cadus/Hardware-Circuit-Boards/Gesamtstückliste.xlsx

Sheet: Übersicht
remo2hbo Vitalparametermonitoring | Teil | Anzahl | Preis | Summe
 |  | 1 | 296.65 € | 296.65 €

Sheet: Komplett
Bauteilart | Anzahl | Bauteil | Bezeichnung | Einzelpreis | Summe | Anbieter | Artikelnummernr. | link
Power | 2 | 5V Schaltnetzteil | EPS-15-5 | 7.60 € | 15.20 € | Reichelt | EPS-15-5 | https://www.reichelt.de/schaltnetzteil-open-frame-15-w-5-v-3-a-eps-15-5-p170922.html?
 | 1 | Netzschalter | 2xAUS | 3.99 € | 3.99 € | Reichelt | WIPE 1935.3118 | https://www.reichelt.de/wippschalter-2x-aus-beleuchtet-gruen-i-o-wippe-1935-3118-p108252.html?trstct=pol_15
 | 1 | Kaltgerätebuchse + Feinsicherung |  | 1.45 € | 1.45 € | Reichelt | KES 2SI | https://www.reichelt.de/kaltgeraetestecker-mit-sicherungseinsatz-4-8-mm-faston-kes-2si-p9359.html?trstct=pol_1
IC | 3 | LED 3mm | EVL 1254-10SYGD1 | 0.08 € | 0.24 € | Reichelt | EVL 1254-10SYGD1 | https://www.reichelt.de/led-3-mm-bedrahtet-gruen-63-mcd-40-evl-1254-10sygd1-p230791.html?trstct=pol_1
 | 2 | 3,3V Festspannungsregler TO220 | LF33CV | 0.72 € | 1.44 € | Reichelt | LF 33 CV | https://www.reichelt.de/ldo-regler-fest-3-3-v-to-220-lf-33-cv-p39414.html?&trstct=pos_0
 | 1 | AD-Wandler | MCP-3008 | 2.51 € | 2.51 € | Conrad | 651456 - 62 | https://www.conrad.de/de/microchip-technology-mcp3008-ip-datenerfassungs-ic-analog-digital-wandler-adc-extern-pdip-16-651456.html
 | 1 | Drucksensor | OWN_MPX53GP | 8.99 € | 8.99 € | Reichelt | MPX 53GP | https://www.reichelt.de/drucksensor-0-50-kpa-1-2-mv-kpa-mpx-53gp-p82330.html?&trstct=pos_0
 | 1 | Tempsensor | DS18B20 | 7.65 € | 7.65 € | Reichelt | DEBO LK-TEMP2 | https://www.reichelt.de/entwicklerboards-temperatursensor-bis-125-c-debo-lk-temp2-p215884.html?trstct=pos_8
 | 3 | Transistor | IRF540 To220 | 0.50 € | 1.50 € | Reichelt | IRF 540N | https://www.reichelt.de/mosfet-n-ch-100v-33a-130w-to-220ab-irf-540n-p41613.html?&trstct=pos_2
 | 4 | Transistor | BC547 TO92 | 0.03 € | 0.12 € | Reichelt | RND BC547 | https://www.reichelt.de/bipolartransistor-npn-45v-0-1a-0-5w-to-92-rnd-bc547-p223356.html?trstct=pos_0
 | 1 | Multiplexer | CD4052B | 0.45 € | 0.45 € | Reichelt | CD 4052BE TEX | https://www.reichelt.de/multi-demultiplexer-4-ch-3-20-v-dil-16-cd-4052be-tex-p216651.html?trstct=pos_0
 | 2 | DigitalPoti | X9C104P DIL8 | 5.20 € | 10.40 € | Reichelt | X 9C104 PIZ | https://www.reichelt.de/digitalpoti-1-kanal-100-schritte-100-kohm-pdip-8-x-9c104-piz-p188766.html?trstct=pos_0
 | 3 | Instrumentenverstärker | INA126P | 2.99 € | 8.97 € | Reichelt | INA 126 PA | https://www.reichelt.de/instrumentenverstaerker-1-fach-dip-8-ina-126-pa-p147253.html?&trstct=pos_0
 | 11 | Quad OP Amp | LMC6484 | 2.60 € | 28.60 € | Reichelt | LMC 5484 N | https://www.reichelt.de/operationsverstaerker-4-fach-dip-14-lmc-6484-n-p10531.html?&trstct=pos_1
 | 3 | Quad OP Amp | MCP6024 | 2.46 € | 7.38 € | Conrad | 1084871 - 62 | https://www.conrad.de/de/microchip-technology-linear-ic-operationsverstaerker-mcp6024-ip-mehrzweck-pdip-14-1084871.html
 | 5 | ATMega 328P | DIP28 | 1.80 € | 9.00 € | Reichelt | ATMEGA 328P-PU | https://www.reichelt.de/mcu-atmega-avr-risc-32-kb-20-mhz-pdip-28-atmega-328p-pu-p119685.html?trstct=pos_1
 | 1 | ATTiny85 | Dil8 | 1.05 € | 1.05 € | Reichelt | ATTINY 85-20 PU | https://www.reichelt.de/mcu-attiny-avr-risc-8-kb-20-mhz-pdip-8-attiny-85-20-pu-p69299.html?trstct=pos_1
 | 4 | USB to Serial | Pololu CP2104 | 5.94 € | 23.76 € | Eckstein Komponente | PO1308 | https://eckstein-shop.de/Pololu-CP2104-USB-to-Serial-Adapter-Carrier
 | 5 | 16MHz Quarzoszillator | 16,0000-HC49U-S | 0.22 € | 1.10 € | Reichelt | 16,0000-HC49U-S | https://www.reichelt.de/standardquarz-grundton-16-000000-mhz-16-0000-hc49u-s-p32852.html?trstct=pos_7
Sockel | 5 | Sockel | DIL8 | 0.04 € | 0.20 € | Reichelt | GS 8 | https://www.reichelt.de/ic-sockel-8-polig-doppelter-federkontakt-gs-8-p8230.html?&trstct=pol_0
 | 14 | Sockel | DIL14 | 0.05 € | 0.70 € | Reichelt | GS 14 | https://www.reichelt.de/ic-sockel-14-polig-doppelter-federkontakt-gs-14-p8206.html?&trstct=pol_0
 | 2 | Sockel | DIl16 | 0.05 € | 0.10 € | Reichelt | GS 16 | https://www.reichelt.de/ic-sockel-16-polig-doppelter-federkontakt-gs-16-p8208.html?&trstct=pol_2
 | 1 | Sockel | DIL28 | 0.10 € | 0.10 € | Reichelt | GS 28-S | https://www.reichelt.de/ic-sockel-28-polig-doppelter-federkontakt-gs-28-s-p86281.html?&trstct=pol_0
 | 1 | Pinhead | 2x20 | 0.62 € | 0.62 € | Reichelt | MPE 087-2-040 | https://www.reichelt.de/stiftleisten-2-54-mm-2x20-gerade-mpe-087-2-040-p119900.html?&trstct=pol_2
 | 5 | Pinhead | 2x3 | 0.14 € | 0.70 € | Reichelt | MPE 087-2-006 | https://www.reichelt.de/stiftleisten-2-54-mm-2x03-gerade-mpe-087-2-006-p119893.html?&trstct=pol_13
 | 1 | Pinhead | 1x2 | 0.05 € | 0.05 € | Reichelt | MPE 087-1-002 | https://www.reichelt.de/stiftleisten-2-54-mm-1x02-gerade-mpe-087-1-002-p119879.html?&trstct=pol_3
 | 4 | Pinhead | 1x3 | 0.07 € | 0.28 € | Reichelt | MPE 097-1-003 | https://www.reichelt.de/stiftleisten-2-54-mm-1x03-gerade-mpe-087-1-003-p119880.html?&trstct=pol_4
Diode | 16 | Diode | 1N4148/1N4004 | 0.02 € | 0.32 € | Reichelt | RND 1N4148 | https://www.reichelt.de/schalt-diode-100-v-200-ma-do-35-rnd-1n4148-p223368.html?&trstct=pos_0
 | 9 | Schottkydiode | 1N5819 | 0.06 € | 0.54 € | Reichelt | 1N 5819 | https://www.reichelt.de/schottkydiode-40-v-1-a-do-41-1n-5819-p41850.html?&trstct=pos_0
Widerstand | 1 | Widerstand | 68 | 0.08 € | 0.08 € | Reichelt | K-O SFCN68R0T52 | https://www.reichelt.de/widerstand-metallschicht-68-ohm-0207-0-6-w-1-k-o-sfcn68r0t52-p237203.html?trstct=pos_0
 | 1 | Widerstand | 100 | 0.08 € | 0.08 € | Reichelt | K-O SFCN1000T52 | https://www.reichelt.de/widerstand-metallschicht-100-ohm-0207-0-6-w-1-k-o-sfcn1000t52-p237350.html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
 | 1 | Widerstand | 220 | 0.08 € | 0.08 € | Reichelt | K-O SFCN2200T52 | https://www.reichelt.de/widerstand-metallschicht-220-ohm-0207-0-6-w-1-k-o-sfcn2200t52-p237299.html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
 | 3 | Widerstand | 330 | 0.08 € | 0.24 € | Reichelt | K-O SFCN3300T52 | https://www.reichelt.de/widerstand-metallschicht-330-ohm-0207-0-6-w-1-k-o-sfcn3300t52-p237265.html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
 | 8 | Widerstand | 1k | 0.08 € | 0.64 € | Reichelt | K-O SFCN1001T52 | https://www.reichelt.de/widerstand-metallschicht-1-0-kohm-0207-0-6-w-1-k-o-sfcn1001t52-p237349.html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
 | 1 | Widerstand | 1,5k | 0.08 € | 0.08 € | Reichelt | K-O SFCN1501T52 | https://www.reichelt.de/widerstand-metallschicht-1-5-kohm-0207-0-6-w-1-k-o-sfcn1501t52-p237324.html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
 | 3 | Widerstand | 4,7k | 0.08 € | 0.24 € | Reichelt | K-O SFCN4701T52 | https://www.reichelt.de/widerstand-metallschicht-4-7-kohm-0207-0-6-w-1-k-o-sfcn4701t52-p237245.html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
 | 3 | Widerstand | 8,2k | 0.08 € | 0.24 € | Reichelt | K-O SFCN8201T52 | https://www.reichelt.de/widerstand-metallschicht-8-2-kohm-0207-0-6-w-1-k-o-sfcn8201t52-p237195.html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
 | 35 | Widerstand | 10k | 0.08 € | 2.80 € | Reichelt | K-O SFCN1002T52 | https://www.reichelt.de/widerstand-metallschicht-10-kohm-0207-0-6-w-1-k-o-sfcn1002t52-p237348.html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
 | 19 | Widerstand | 22k | 0.08 € | 1.52 € | Reichelt | K-O SFCN2202T52 | https://www.reichelt.de/widerstand-metallschicht-22-kohm-0207-0-6-w-1-k-o-sfcn2202t52-p237297.html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
 | 3 | Widerstand | 33k | 0.08 € | 0.24 € | Reichelt | K-O SFCN3302T52 | https://www.reichelt.de/widerstand-metallschicht-33-kohm-0207-0-6-w-1-k-o-sfcn3302t52-p237263.html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
 | 9 | Widerstand | 47k | 0.08 € | 0.72 € | Reichelt | K-O SFCN4702T52 | https://www.reichelt.de/widerstand-metallschicht-47-kohm-0207-0-6-w-1-k-o-sfcn4702t52-p237244.html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
 | 20 | Widerstand | 100k | 0.08 € | 1.60 € | Reichelt | K-O SFCN1003T52 | https://www.reichelt.de/widerstand-metallschicht-100-kohm-0207-0-6-w-1-k-o-sfcn1003t52-p237347.html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
 | 1 | Widerstand | 180k | 0.08 € | 0.08 € | Reichelt | METALL 180K | https://www.reichelt.de/widerstand-metallschicht-180-kohm-0207-0-6-w-1-metall-180k-p11564.html?trstct=pos_1
 | 4 | Widerstand | 220k | 0.08 € | 0.32 € | Reichelt | K-O SFCN2203T52 | https://www.reichelt.de/widerstand-metallschicht-220-kohm-0207-0-6-w-1-k-o-sfcn2203t52-p237296.html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
 | 3 | Widerstand | 390k | 0.08 € | 0.24 € | Reichelt | K-O SFCN3903T52 | https://www.reichelt.de/widerstand-metallschicht-390-kohm-0207-0-6-w-1-k-o-sfcn3903t52-p237255.html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
 | 6 | Widerstand | 470k | 0.08 € | 0.49 € | Reichelt | METALL 470K | https://www.reichelt.de/widerstand-metallschicht-470-kohm-0207-0-6-w-1-metall-470k-p11827.html?trstct=pos_1
 | 35 | Widerstand | 1M | 0.08 € | 2.80 € | Reichelt | K-O SFCN1004T52 | https://www.reichelt.de/widerstand-metallschicht-1-0-mohm-0207-0-6-w-1-k-o-sfcn1004t52-p237346.html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
 | 1 | Widerstand | 1,5M | 0.08 € | 0.08 € | Reichelt | K-O SFCN1504T52 | https://www.reichelt.de/widerstand-metallschicht-1-5-mohm-0207-0-6-w-1-k-o-sfcn1504t52-p237321.html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
Kondensator | 8 | Kondensator C2, 5 | 2,2p | 0.05 € | 0.40 € | Reichelt | KERKO 2,2P | https://www.reichelt.de/keramik-kondensator-2-2p-kerko-2-2p-p9276.html?&trstct=pol_0
 | 3 | Kondensator C2, 5 | 10p | 0.05 € | 0.15 € | Reichelt | KERKO 10P | https://www.reichelt.de/keramik-kondensator-10p-kerko-10p-p9268.html?&trstct=pol_0
 | 10 | Kondensator C2,5 | 22p | 0.05 € | 0.50 € | Reichelt | KERKO 22P | https://www.reichelt.de/keramik-kondensator-22p-kerko-22p-p9281.html?&trstct=pol_0
 | 3 | Kondensator C2, 5 | 100p | 0.05 € | 0.15 € | Reichelt | KERKO 100P | https://www.reichelt.de/keramik-kondensator-100p-kerko-100p-p9266.html?&trstct=pol_0
 | 7 | Kondensator C2, 5 | 150p | 0.06 € | 0.42 € | Reichelt | KERKO 150P | https://www.reichelt.de/keramik-kondensator-150p-kerko-150p-p9271.html?&trstct=pol_0
 | 8 | Kondensator C2, 5 | 470p | 0.05 € | 0.40 € | Reichelt | KERKO 470P | https://www.reichelt.de/keramik-kondensator-470p-kerko-470p-p9295.html?&trstct=pol_0
 | 3 | Kondensator C2, 5 | 680p | 0.05 € | 0.15 € | Reichelt | KERKO 680P | https://www.reichelt.de/keramik-kondensator-680p-kerko-680p-p9303.html?&trstct=pol_0
 | 15 | Kondensator C2, 5 | 1,5n | 0.05 € | 0.75 € | Reichelt | KERKO 1,5N | https://www.reichelt.de/keramik-kondensator-1-5n-kerko-1-5n-p9261.html?&trstct=pol_2
 | 6 | Kondensator C2, 5 | 2,2n | 0.06 € | 0.36 € | Reichelt | KERKO 2,2N | https://www.reichelt.de/keramik-kondensator-2-2n-kerko-2-2n-p9275.html?&trstct=pol_0
 | 6 | Kondensator C2, 5 | 4,7n | 0.06 € | 0.36 € | Reichelt | KERKO 4,7N | https://www.reichelt.de/keramik-kondensator-4-7n-kerko-4-7n-p9293.html?&trstct=pos_0
 | 3 | Kondensator C2,5 | 10n | 0.05 € | 0.15 € | Reichelt | KERKO 10N | https://www.reichelt.de/keramik-kondensator-10n-kerko-10n-p9267.html?&trstct=pos_0
 | 6 | Kondensator C2, 5 | 15n | 0.33 € | 1.98 € | Reichelt | ECWHA 15N 800 | https://www.reichelt.de/folienkondensator-15-nf-800-v-rm-13-105-c-3-ecwha-15n-800-p228880.html?trstct=pos_4
 | 2 | Kondensator C2, 5 | 22n | 0.06 € | 0.12 € | Reichelt | KERKO 22N | https://www.reichelt.de/keramik-kondensator-22n-kerko-22n-p9280.html?&trstct=pol_0
 | 3 | Kondensator C2, 5 | 33n | 0.24 € | 0.72 € | Reichelt | MKS02-250 33N | https://www.reichelt.de/folienkondensator-33nf-250v-rm2-5-mks02-250-33n-p172674.html?&trstct=pos_9
 | 2 | Kondensator C2, 5 | 47n | 0.09 € | 0.18 € | Reichelt | KERKO 47N | https://www.reichelt.de/keramik-kondensator-47n-kerko-47n-p9296.html?&trstct=pos_0
 | 9 | Kondensator C2, 5 | 68n | 0.44 € | 3.96 € | Reichelt | MKS02-63 680N | https://www.reichelt.de/folienkondensator-680nf-63v-rm2-5-mks02-63-680n-p12328.html?&trstct=pos_3
 | 14 | Kondensator C2,5 | 100n | 0.05 € | 0.70 € | Reichelt | KERKO 100N | https://www.reichelt.de/keramik-kondensator-100n-kerko-100n-p9265.html?r=1
 | 8 | Kondensator C2, 5 | 220n | 0.22 € | 1.76 € | Reichelt | MKS02-63 220N | https://www.reichelt.de/folienkondensator-220nf-63v-rm2-5-mks02-63-220n-p12319.html?&trstct=pos_3
 | 1 | Kondensator C2,5 | 330n | 0.27 € | 0.27 € | Reichelt | MKS02-63 330N | https://www.reichelt.de/folienkondensator-330nf-63v-rm2-5-mks02-63-330n-p172661.html?&trstct=pos_4
 | 6 | Kondensator C150 | 470n | 0.33 € | 1.98 € | Reichelt | MKP4-250 470N | https://www.reichelt.de/folienkondensator-470nf-250v-rm15-mkp4-250-470n-p172980.html?&trstct=pos_1
 | 1 | Kondensator C150 | 680n | 0.29 € | 0.29 € | Reichelt | MKS4-250 680N | https://www.reichelt.de/folienkondensator-680nf-250v-rm15-mks4-250-680n-p172870.html?&trstct=pos_13
 | 3 | Kondensator C150 | 1µ | 0.16 € | 0.48 € | Reichelt | RND 150MKT105K2A | https://www.reichelt.de/folienkondensator-1-f-100-v-rm15-rnd-150mkt105k2a-p211355.html?&trstct=pos_1
 | 2 | Kondensator E2,5 | 4,7µ | 0.02 € | 0.04 € | Reichelt | RAD 105 4,7/100 | https://www.reichelt.de/elko-radial-4-7-f-100-v-rm-2-5-1000h-105-c-20-rad-105-4-7-100-p44857.html?trstct=pol_0
 | 2 | Kondensator E2,5 | 10µ | 0.02 € | 0.04 € | Reichelt | RAD 105 10/63 | https://www.reichelt.de/elko-radial-10-f-63-v-rm-2-5-1000h-105-c-20-rad-105-10-63-p42397.html?trstct=pol_0
 | 10 | Kondensator E2,5 | 47µ | 0.04 € | 0.40 € | Reichelt | RAD 105 47/35 | https://www.reichelt.de/elko-radial-47-f-35-v-rm-2-5-1000h-105-c-20-rad-105-47-35-p42399.html?trstct=pol_1
Steckkontakte | 4 | JST B2P VH | Stifte gerade | 0.13 € | 0.52 € | Reichelt | JST VH2P ST | https://www.reichelt.de/jst-stiftleiste-gerade-1x2-polig-vh-jst-vh2p-st-p185110.html?&trstct=pos_11
Notlösung, muss dann angepasst werden | 2 | JST B2P VH | Stifte gewinkelt | 0.27 € | 0.54 € | Reichelt | JST VH4P ST90 | https://www.reichelt.de/jst-stiftleiste-rm-3-96-mm-1x4-polig-gew-vh-jst-vh4p-st90-p190558.html?trstct=pos_5
 | 10 | JST B2P VH | Female | 0.10 € | 1.00 € | Reichelt | JST VH2P BU | https://www.reichelt.de/jst-buchsengehaeuse-1x2-polig-vh-jst-vh2p-bu-p185107.html?&trstct=pos_8
 | 1 | JST B3P VH | Stifte gerade | 0.19 € | 0.19 € | Reichelt | JST VH3P ST | https://www.reichelt.de/jst-stiftleiste-gerade-1x3-polig-vh-jst-vh3p-st-p185111.html?&trstct=pos_12
 | 3 | JST B3P VH | Stifte gewinkelt | 0.41 € | 1.23 € | Conrad | 741182 - 62 | https://www.conrad.de/de/jst-stiftleiste-standard-vh-polzahl-gesamt-3-rastermass-396-mm-b3ps-vh-lfsn-1-st-741182.html
 | 4 | JST B3P VH | Female | 0.13 € | 0.52 € | Reichelt | JST VH3P BU | https://www.reichelt.de/jst-buchsengehaeuse-1x3-polig-vh-jst-vh3p-bu-p185108.html?&trstct=pos_9
 | 6 | JST XH 03 | Stifte gerade | 0.16 € | 0.96 € | Reichelt | JST XH3P ST | https://www.reichelt.de/jst-stiftleiste-gerade-1x3-polig-xh-jst-xh3p-st-p185074.html?&trstct=pos_5
 | 4 | JST XH 03 | Stifte gewinkelt | 0.19 € | 0.76 € | Reichelt | JST XH3P ST90 | https://www.reichelt.de/jst-stiftleiste-90-1x3-polig-xh-jst-xh3p-st90-p185080.html?&trstct=pos_10
 | 10 | JST XH 03 | Female | 0.06 € | 0.60 € | Reichelt | JST XH3P BU | https://www.reichelt.de/jst-buchsengehaeuse-1x3-polig-xh-jst-xh3p-bu-p185086.html?trstct=lsbght_sldr::185080
 | 15 | JST XH 02 | Stifte gerade | 0.10 € | 1.50 € | Reichelt | JST XH2P ST | https://www.reichelt.de/jst-stiftleiste-gerade-1x2-polig-xh-jst-xh2p-st-p185073.html?&trstct=pos_4
 | 19 | JST XH 02 | Stifte gewinkelt | 0.13 € | 2.47 € | Reichelt | JST XH2P ST90 | https://www.reichelt.de/jst-stiftleiste-90-1x2-polig-xh-jst-xh2p-st90-p185079.html?&trstct=pos_9
 | 34 | JST XH 02 | Female | 0.06 € | 2.04 € | Reichelt | JST XH2P BU | https://www.reichelt.de/jst-buchsengehaeuse-1x2-polig-xh-jst-xh2p-bu-p185085.html?trstct=lsbght_sldr::185079
 | 56 | Crimpkontakte | JST VH | 0.10 € | 5.60 € | Reichelt | JST VH CKS | https://www.reichelt.de/jst-crimpkontakt-buchse-vh-jst-vh-cks-p185113.html?&trstct=pos_0
 | 196 | Crimpkontakte | JST XH | 0.10 € | 19.60 € | Reichelt | JST XH CKB | https://www.reichelt.de/jst-crimpkontakt-buchse-xh-jst-xh-ckb-p185091.html?trstct=lsbght_sldr::185073
Leitung | 1 | EKG Elektrodenkabel |  |  | 0.00 €
 | 1 | Flachbandkabel Raspberry Pi |  | 3.25 € | 3.25 € | Eckstein Komponente | ZB02034 | https://eckstein-shop.de/IDE-Flachband-Kabel-40Pin-Buchse-auf-Buchse-female-to-female-20cm
 | 1 | Leitung |  | 0.81 € | 0.81 € | Reichelt | LITZE OR | https://www.reichelt.de/kupferlitze-isoliert-10m-1x0-14mm-orange-litze-or-p118722.html?&trstct=pol_0
 | 1 | Leitung |  | 0.78 € | 0.78 € | Reichelt | LITZE BL | https://www.reichelt.de/kupferlitze-isoliert-10m-1x0-14mm-blau-litze-bl-p10292.html?&trstct=pol_1
 | 1 | Leitung |  | 0.78 € | 0.78 € | Reichelt | LITZE BR | https://www.reichelt.de/kupferlitze-isoliert-10m-1x0-14mm-braun-litze-br-p10293.html?&trstct=pol_2
 | 1 | Leitung |  | 0.76 € | 0.76 € | Reichelt | LITZE GE | https://www.reichelt.de/kupferlitze-isoliert-10m-1x0-14mm-gelb-litze-ge-p10294.html?&trstct=pol_3
 | 1 | Leitung |  | 0.76 € | 0.76 € | Reichelt | LITZE GR | https://www.reichelt.de/kupferlitze-isoliert-10m-1x0-14mm-grau-litze-gr-p10295.html?&trstct=pol_4
 | 1 | Leitung |  | 0.76 € | 0.76 € | Reichelt | LITZE GN | https://www.reichelt.de/kupferlitze-isoliert-10m-1x0-14mm-gruen-litze-gn-p10296.html?&trstct=pol_5
 | 1 | Leitung |  | 0.76 € | 0.76 € | Reichelt | LITZE RT | https://www.reichelt.de/kupferlitze-isoliert-10m-1x0-14mm-rot-litze-rt-p10297.html?&trstct=pol_6
 | 1 | Leitung |  | 0.78 € | 0.78 € | Reichelt | LITZE SW | https://www.reichelt.de/kupferlitze-isoliert-10m-1x0-14mm-schwarz-litze-sw-p10298.html?&trstct=pol_7
 | 1 | Leitung |  | 1.20 € | 1.20 € | Reichelt | LITZE VT | https://www.reichelt.de/kupferlitze-isoliert-10m-1x0-14mm-violett-lila-litze-vt-p211172.html?trstct=pol_9
 | 1 | Leitung |  | 1.75 € | 1.75 € | Reichelt | H05VK 0,75-10BL | https://www.reichelt.de/schaltlitze-h05v-k-0-75-mm-10-m-blau-h05vk-0-75-10bl-p69460.html?trstct=pol_0
 | 1 | Leitung |  | 1.99 € | 1.99 € | Reichelt | H05VK 0,75-10SW | https://www.reichelt.de/schaltlitze-h05v-k-0-75-mm-10-m-schwarz-h05vk-0-75-10sw-p69459.html?trstct=pol_2
Gehäsueanschluss | 1 | D-SUB Einbaubuchse | 9 pol | 0.17 € | 0.17 € | Reichelt | D-SUB BU 09 | https://www.reichelt.de/d-sub-buchse-9-polig-loetkelch-d-sub-bu-09-p6948.html?&trstct=pos_10
 | 2 | Stereo Klinkenbuchse 3,5mm |  | 0.90 € | 1.80 € | Reichelt | LUM KLB 4 | https://www.reichelt.de/klinkeneinbaubuchse-3-5-mm-stereo-3-pol-lum-klb-4-p116183.html?trstct=pol_15
 | 1 | Schlauchanschluss-gehäuse |  |  | 0.00 €
Blutdruck | 1 | 6V DC Mini Air pump |  | 3.95 € | 3.95 € | Pollin Electronic | 330067 | https://www.pollin.de/p/luftpumpe-daypower-lp27-06-6-v-330067
 | 2 | 3V Magnetventil |  | 0.34 € | 0.68 € | Aliexpress |  | https://de.aliexpress.com/item/DC3V-Elektronische-Blutdruck-Magnetventil-Normal-Open-Arbeitsdruck-300-mmHg-Blutdruckmessger-t-Vent-Ventil-DC-Auspuff-Ventil/32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
 | 1 | Schlauch |  |  | 0.00 €
 | 3 | T Stück |  |  | 0.00 €
 | 1 | KLettManschette Erwachsene Standard abwaschbar |  | 16.50 € | 16.50 € | Medishop | BOS1104250A | https://www.medishop.de/sitemap/Klettenmanschette-fuer-Erwachsene-Standard-abwaschbar-Einschlauch.html
Sonstiges | 1 | Display, 7" resisitive Touch |  | 54.95 € | 54.95 € | Pollin Electronic | 120964 | https://www.pollin.de/p/7-17-78-cm-display-set-mit-touchscreen-ls-7t-hdmi-dvi-vga-cvbs-120964
 | 1 | Raspberry Pi 3B+ |  | 32.50 € | 32.50 € | Reichelt | RASPBERRY PI 3B+ | https://www.reichelt.de/raspberry-pi-3-b-4x-1-4-ghz-1-gb-ram-wlan-bt-raspberry-pi-3b-p217696.html?trstct=pos_0
 | 5 | USB Kabel micro-->A |  | 1.45 € | 7.25 € | Eckstein Komponente | ZB02246 | https://eckstein-shop.de/20cm-Micro-USB-Ladekaber-fuer-Raspberry-Pi-Adapterkabel-keine-Datenuebertragung
 | 1 | HDMI |  | 7.90 € | 7.90 € | Reichelt | DELOCK 85117 | https://www.reichelt.de/high-speed-hdmi-kabel-mit-ethernet-0-25-m-delock-85117-p203113.html?trstct=pol_0
 | 1 | Kaltgerätekabel | 2,5m | 3.55 € | 3.55 € | Reichelt | NKSK 250 SW | https://www.reichelt.de/kaltgeraeteanschlusskabel-2-5m-schwarz-nksk-250-sw-p133128.html?trstct=pos_1
 | 1 | Usb Hub |  | 9.40 € | 9.40 € | Reichelt | RPIZ USB 4PORT | https://www.reichelt.de/raspberry-pi-usb-hub-4-port-phat-rpiz-usb-4port-p242791.html?PROVID=2788&r=1

Sheet: Power Supply
Baugruppe / Modul | Anzahl | Bauteil | Bezeichnung
Power supply | 2 | Kondensator E2, 5 | 10µ
 | 2 | Kondensator C2, 5 | 0,1µ
 | 2 | 3,3V Festspannungsregler TO220 | LF33
 | 3 | LED 3mm
 | 1 | Widerstand | 220
 | 2 | Widerstand | 1k
 | 3 | JST B2P VH | Buchse gerade
 | 3 | JST B2P VH | Stecker
 | 1 | JST B3P VH | Buchse gerade
 | 1 | JST B3P VH | Stecker

Sheet: OctoBrain
Baugruppe / Modul | Anzahl | Bauteil | Bezeichnung
OctoBrain | 1 | Kondensator E2, 5 | 47µ
 | 1 | AD-Wandler | MCP-3008
 | 1 | Widerstand | 4,7k
 | 1 | Pinhead | 2x20
 | 1 | JST XH 03 | Buchse gerade
 | 1 | JST XH 03 | Stecker
 | 12 | JST XH 02 | Buchse gerade
 | 12 | JST XH 02 | Stecker
 | 1 | JST B2P VH | Buchse gerade
 | 1 | JST B2P VH | Stecker

Sheet: ECG Supply
Baugruppe / Modul | Anzahl | Bauteil | Bezeichnung
ECG_Supply | 6 | Diode | 1N4148
 | 3 | Widerstand | 100k
 | 5 | JST XH 03 | Buchse gerade
 | 5 | JST XH 03 | Stecker
 | 3 | JST XH 02 | Buchse gerade
 | 3 | JST XH 02 | Stecker

Sheet: ECG
Baugruppe / Modul | Anzahl | Bauteil | Bezeichnung
ECG I, II, III | 6 | Kondensator C2, 5 | 2,2p
 | 3 | Kondensator C2, 5 | 10p
 | 3 | Kondensator C2, 5 | 100p
 | 6 | Kondensator C2, 5 | 150p
 | 6 | Kondensator C2, 5 | 470p
 | 3 | Kondensator C2, 5 | 680p
 | 15 | Kondensator C2, 5 | 1,5n
 | 6 | Kondensator C2, 5 | 2,2n
 | 6 | Kondensator C2, 5 | 4,7n
 | 6 | Kondensator C2, 5 | 15n
 | 3 | Kondensator C2, 5 | 33n
 | 9 | Kondensator C2, 5 | 68n
 | 3 | Kondensator C2, 5 | 100n
 | 6 | Kondensator C2, 5 | 220n
 | 6 | Kondensator C15 | 0,47µ
 | 3 | Schottkydiode | 1N5819
 | 3 | Diode | 1N4148/1N4004
 | 3 | Instrumentenverstärker | INA126P
 | 9 | Quad OP Amp | LM6484
 | 3 | Widerstand | 330
 | 3 | Widerstand | 8,2k
 | 21 | Widerstand | 10k
 | 3 | Widerstand | 22k
 | 12 | Widerstand | 27k
 | 3 | Widerstand | 33k
 | 9 | Widerstand | 47k
 | 3 | Widerstand | 100k
 | 3 | Widerstand | 390k
 | 6 | Widerstand | 500k
 | 24 | Widerstand | 1M
 | 3 | JST XH 03 | Buchse
 | 3 | JST XH 03 | Stecker
 | 9 | JST XH 02 | Buchse
 | 9 | JST XH 02 | Stecker
 | 1 | Stereo Klinkenbuchse 3,5mm
 | 1 | Elektrodenkabel
 | 9 | Sockel | DIL14
 | 3 | Sockel | DIL8

Sheet: PulseDet
Baugruppe / Modul | Anzahl | Bauteil | Bezeichnung
Pulse_Detection | 2 | Kondensator C2, 5 | 22p
 | 1 | Pinhead | 2x3
 | 1 | Pinhead | 1x3
 | 1 | ATMega 328P | DIP28
 | 1 | 16MHz Crystal
 | 3 | Widerstand | 22k
 | 1 | Widerstand | 10k
 | 1 | USB to Serial | Pololu CP2104
 | 1 | Sockel | DIL28
 | 1 | JST XH 03 | Buchse
 | 1 | JST XH 03 | Stecker
 | 3 | JST XH 02 | Buchse
 | 3 | JST XH 02 | Stecker

Sheet: PulseOxy
Baugruppe / Modul | Anzahl | Bauteil | Bezeichnung
PulseOxy | 1 | ATTiny85 | Dil8
 | 1 | ATMega 328P | DIP28
 | 2 | Kondensator C2, 5 | 2,2p
 | 2 | Kondensator C2,5 | 22p
 | 1 | Kondensator C2, 5 | 150p
 | 2 | Kondensator C2,5 | 470p
 | 2 | Kondensator C2,5 | 10n
 | 2 | Kondensator C2, 5 | 22n
 | 2 | Kondensator C2, 5 | 47n
 | 5 | Kondensator C2, 5 | 100n
 | 2 | Kondensator C150 | 1µ
 | 2 | Kondensator E2,5 | 4,7µ
 | 4 | Kondensator E2,5 | 47µ
 | 4 | Schottkydiode | 1N5819
 | 1 | Diode | 1N4148/1N4004
 | 1 | Multiplexer | CD4052B
 | 1 | Pinhead | 2x3
 | 1 | Pinhead | 1x3
 | 1 | 16MHz Crystal
 | 1 | Widerstand | 68
 | 1 | Widerstand | 100
 | 6 | Widerstand | 1k
 | 2 | Widerstand | 4,7k
 | 9 | Widerstand | 10k
 | 6 | Widerstand | 100k
 | 1 | Widerstand | 180k
 | 2 | Widerstand | 220k
 | 9 | Widerstand | 1Meg
 | 4 | Transistor | BC547 TO92
 | 2 | DigitalPoti | X9C104P DIL8
 | 1 | USB to Serial | Pololu CP2104
 | 1 | Quad OP Amp | LM6484
 | 2 | Quad OP Amp | MCP6024
 | 4 | JST XH 02 | Buchse
 | 4 | JST XH 02 | Stecker
 | 1 | JST B3P VH | Buchse
 | 1 | JST B3P VH | Stecker
 | 1 | D-SUB Einbaubuchse | 9 pol
 | 2 | Sockel | DIL8
 | 3 | Sockel | DIL14
 | 1 | Sockel | DIl16
 | 1 | Sockel | DIL28

Sheet: PTT
Baugruppe / Modul | Anzahl | Bauteil | Bezeichnung
PTT | 4 | Kondensator C2,5 | 22p
 | 2 | Kondensator C2,5 | 100n
 | 2 | Kondensator E2,5 | 47µ
 | 2 | Diode | 1N4148/1N4004
 | 2 | ATMega 328P | DIP28
 | 2 | 16MHz Crystal
 | 2 | Pinhead | 1x3
 | 2 | Pinhead | 2x3
 | 2 | Widerstand | 10k
 | 1 | USB to Serial | Pololu CP2104
 | 1 | JST B2P VH | Buchse
 | 1 | JST B2P VH | Stecker
 | 1 | JST B3P VH | Buchse
 | 1 | JST B3P VH | Stecker
 | 2 | Sockel | DIL28

Sheet: BloodPressure
Baugruppe / Modul | Anzahl | Bauteil | Bezeichnung
Blood_Pressure | 2 | Kondensator C2,5 | 22p
 | 1 | Kondensator C2,5 | 10n
 | 2 | Kondensator C2,5 | 100n
 | 2 | Kondensator C2,5 | 220n
 | 1 | Kondensator C2,5 | 330n
 | 1 | Kondensator C150 | 680n
 | 1 | Kondensator C150 | 1µ
 | 3 | Kondensator E2,5 | 47µ
 | 4 | Diode | 1N4148/1N4004
 | 2 | Schottkydiode | 1N5819
 | 1 | ATMega 328P | DIP28
 | 1 | Pinhead | 2x3
 | 1 | Drucksensor | OWN_MPX53GP
 | 1 | 16MHz Crystal
 | 3 | Transistor | IRF540 To220
 | 1 | Widerstand | 1,5k
 | 2 | Widerstand | 10k
 | 1 | Widerstand | 22k
 | 8 | Widerstand | 100k
 | 2 | Widerstand | 220k
 | 2 | Widerstand | 1M
 | 1 | Widerstand | 1,5M
 | 1 | Pinhead | 1x3
 | 1 | Pinhead | 1x2
 | 1 | USB to Serial | Pololu CP2104
 | 1 | Quad OP Amp | MCP6024
 | 1 | Quad OP Amp | LM6484
 | 3 | JST XH 02 | Buchse
 | 3 | JST XH 02 | Stecker
 | 1 | JST B3P VH | Buchse
 | 1 | JST B3P VH | Stecker
 | 1 | JST B2P VH | Buchse
 | 1 | JST B2P VH | Stecker
 | 1 | DC E-Pump
 | 2 | Micro Valve
 | 1 | Schlauch
 | 1 | Schlauchanschluss-gehäuse
 | 2 | T Stück
 | 1 | Blutdruckmanschette
 | 1 | Sockel | DIl28
 | 2 | Sockel | DIl14

Sheet: Netzteil
Baugruppe / Modul | Anzahl | Bauteil | Bezeichnung
Netzteil | 2 | 5V Schaltnetzteil | EPS-15-5
 | 4 | JST B2P VH | Stecker
 | 1 | Netzschalter
 | 1 | Kaltgerätebuchse + Feinsicherung
