cadus/Hardware-Circuit-Boards/Wiring_all_modules.pdf

# Power Supply

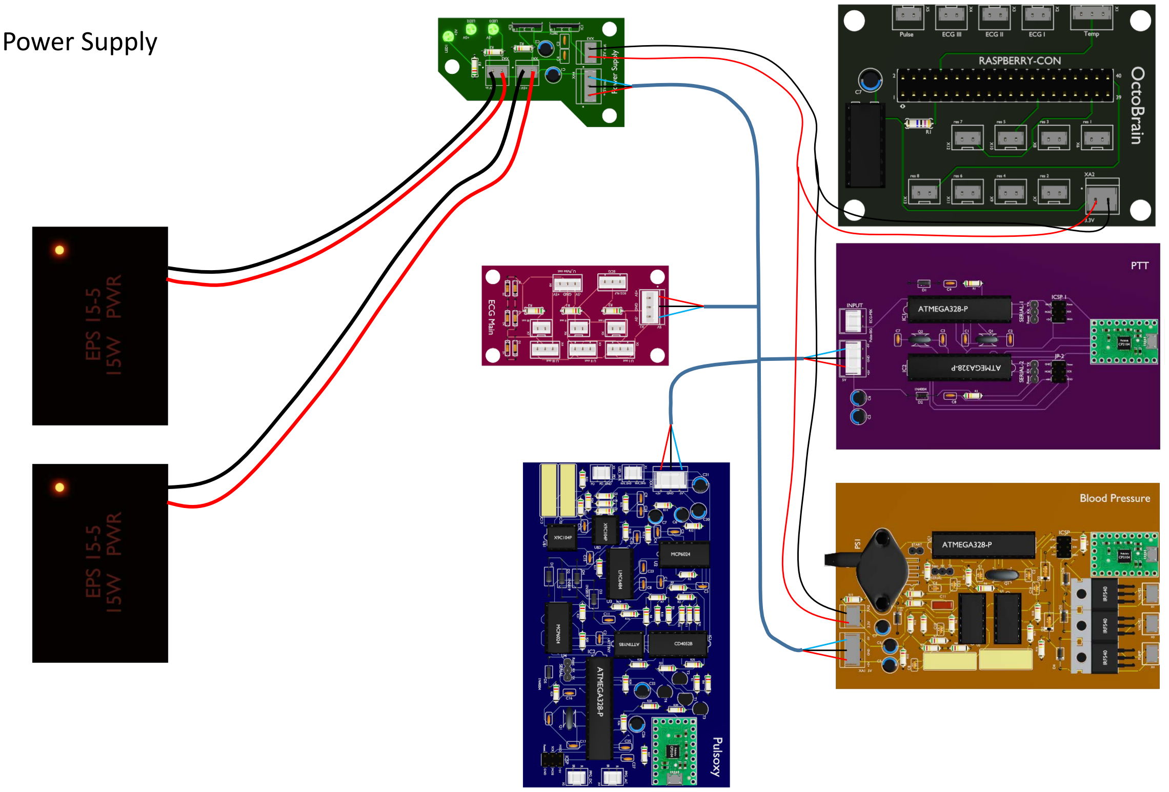
[picture p1: page 1]

# ECG

R

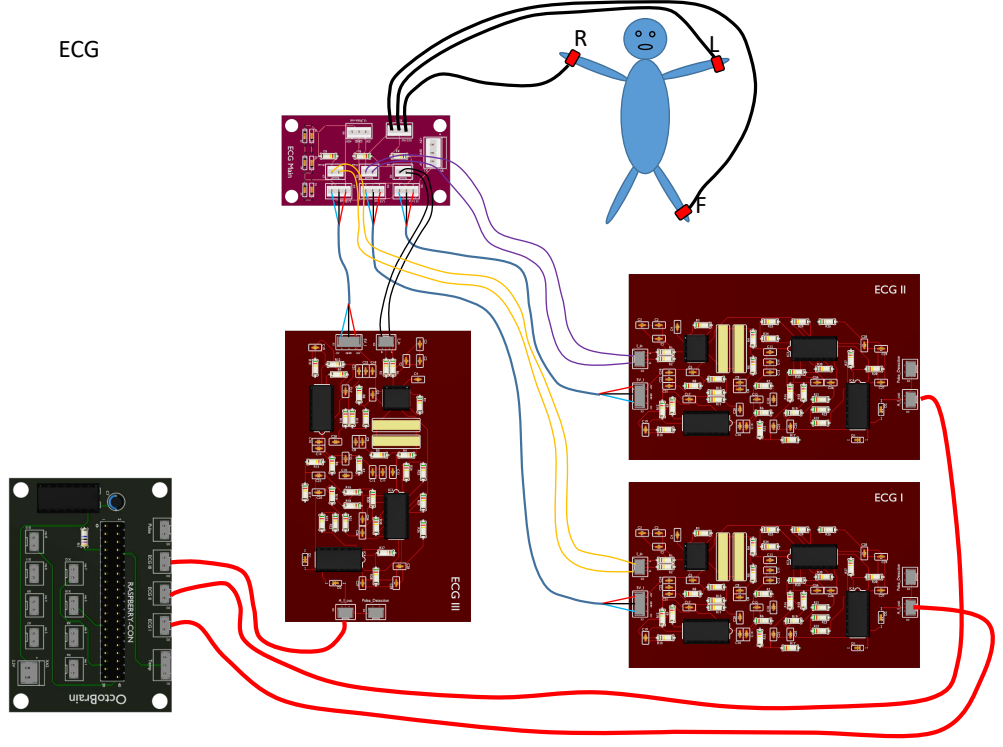
[picture p2: page 2]

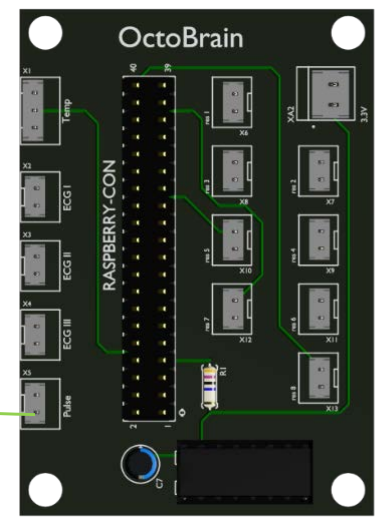
[picture p3: figure]

# SpO2

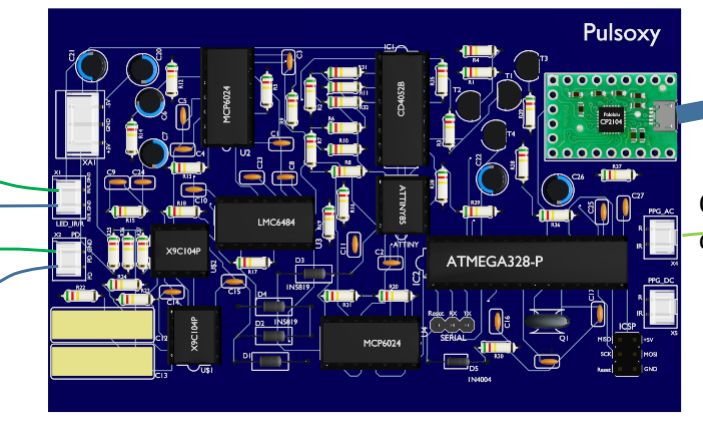
[picture p4: figure]

Only one of the two pins, either the R channel or the IR channel

R
IR

PD

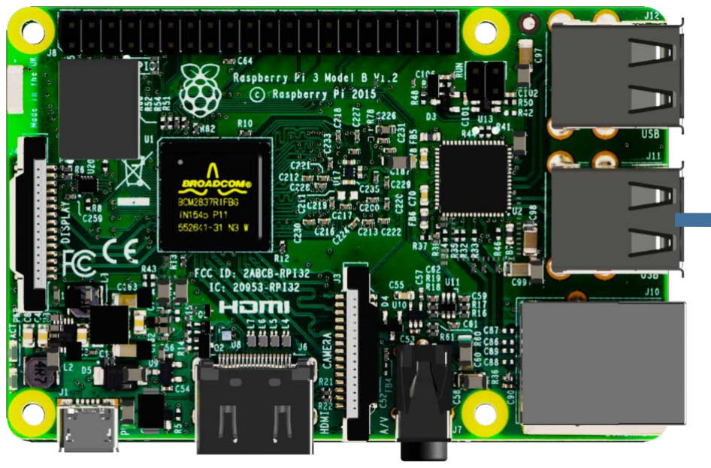
[picture p5: figure]

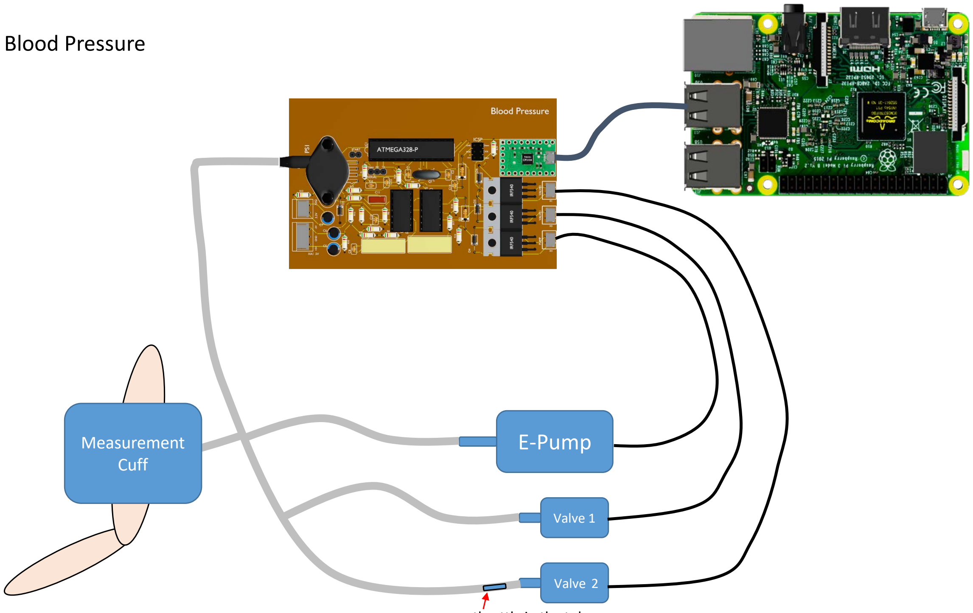
[picture p6: figure]
Blood Pressure; E-Pump; Valve 1; Valve 2; Measurement Cuff

### throttle in the tube

# Pulse

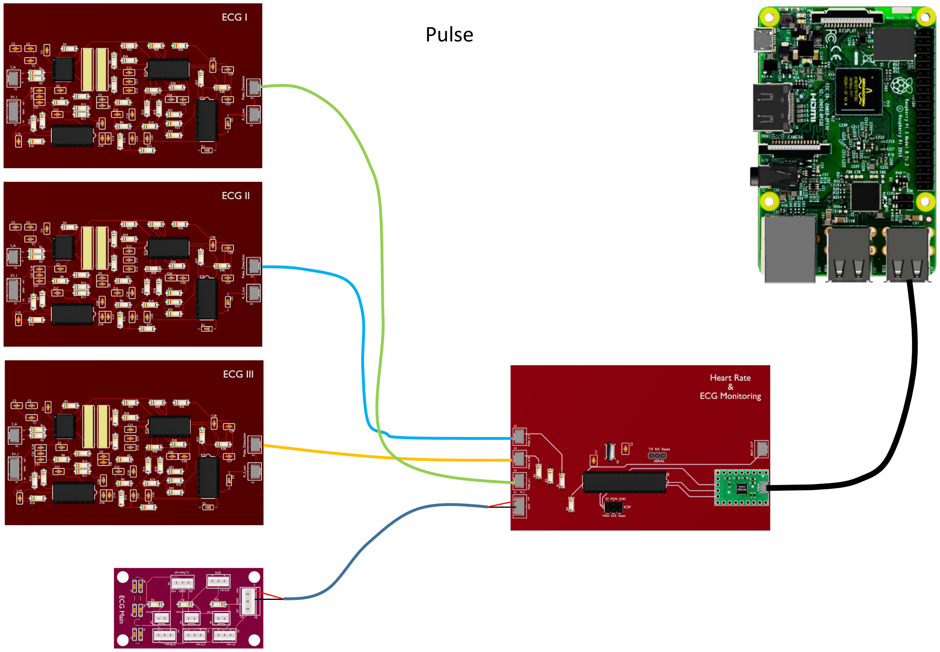
[picture p7: page 5]

# Pulse Transit Time

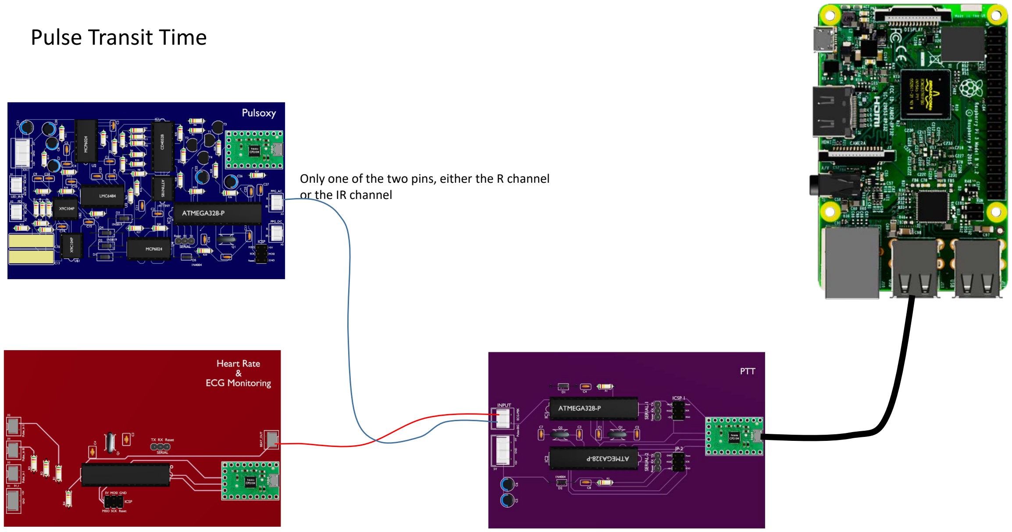
[picture p8: page 6]

Only one of the two pins, either the R channel or the IR channel
