cadus/Hardware-Circuit-Boards/(threads)

Thread 1 (2019-05-07):

Question

kermit943, 2019-05-07:
May we write in English or German?

I saw you work on the CCC youtube chanel

Any reasons why you don´t use SMD parts for the boards?
I can imagine that there is barley time or nerves to resolder a resistor in a crises area no matter if THT or SMD.
But SMD build could reduce the costs of production and there could be mass produced mmodules with still low costs if you chose assembled boards.
-> more boards/moduls -> just swap the old with the new one and repair the other one if you got time.

I know there still some parts with needed to be resolder or handsoldered before sending (pressurepump and so on)

other thing why using a Atmega 328p and extra usbUart MCU if u can have a arduino nano clone for less than 2€, you cann still use the ISP and remove the Bootloader if thats the reason.

not even a hour in the group and already complaining .... tztz sorry

I´m not an electrician or any specialist, just a industrialmechanic and a (so called) Maker with Experience in Arduino/AVR/Rasperry/shit but I hope I can help in any way..

auf gute zusammen Arbeit =)

sabinammm, 2019-05-13:
Hi Kermit:)

thanks for your questions and comments!! English is perfect, but we are just starting out as a community, so please bear with us as we don't always answer everything.

We're just now in the process of building the 2nd prototype using the CAD files available here. As 2 out of 3 of us are relatively new to soldering and not at all specialists, we figure this is a great testing ground for these instructions.

I will pass on your questions with regard to soldering. One thing that comes to mind that makes soldering important: robustness. In a crisis area, machines do need to be especially robust. But in connection with replaceable parts, this is definitely a challenge.

Thanks for the info on the Atmega - maybe one of the more experienced health electronics professionals will have answers to that.

kermit943, 2019-05-13:
> please bear with us as we don't always answer everything.

 How couldn´ t I.

> great testing ground

didn´t thought about prototyping, forgive me

I´m looking forward to see some of the team at MakerFair in Berlin

sabinammm, 2019-05-14:
> I´m looking forward to see some of the team at MakerFair in Berlin

Great:) We also look forward to seeing you there!!

kermit943, 2019-05-18:
Hy Sabinammm
ich kann natürlich keine Leute hinzufügen, sorry!
Würdest du salt4pommes adden?

Wir hätten mal Mailadressen oder ähnliches austauschen sollen

grüße Kermit

sabinammm, 2019-05-22:
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

Hi Kermit,
da du Mitglied der Organisation bist, dachte ich du könntest auch Leute hinzufügen. Vielleicht muss ich das dann noch einschalten. Ich füge salt4pommes gerne hinzu.

Wir hatten ja über das Image geredet. Hier findest du ein funktionierendes: http://remo2hbo-sim.f4.htw-berlin.de/. Wir sind aber noch auf der Suche nach einer besseren Ablage für dieses und zukünftige, also solltet ihr oder du da eine Idee haben, freuen sich bestimmt noch viele Mitstreiter*innen:)

sabinammm, 2019-05-23:
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

Hi Kermit,
das SD-Kartenimage hat jetzt einen neuen Platz: https://redmine.f4.htw-berlin.de/owncloud/index.php/s/6XYWEb62KBo3KN4

sabinammm, 2019-06-06:
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

Hi Kermit,
wir haben noch eine Mailingliste: https://lists.htw-berlin.de/mailman/listinfo/remo2hbo-community. Das hatte ich vergessen dir zu schreiben. Ist eine sehr gute alternative Kommunikation.
VG
Sabina

kermit943, 2019-06-14:
Hy Sabina da trag ich mich gleich mal ein.
Kannst du mir zufällig sagen was das EKG -Modul ausgibt bzw. hast du/ ihr ne Testausgabe? Bild von der UART kommunikation o.ä.
liebe Grüße

steini-at-cadus, 2019-06-14:
Hallo,

Ohne zu wissen worum‘s gerade geht.
Derzeit liegt das EKG analog vor. Nächste Woche wird der AD Wandler hoffentlich seinen Job tun, dann haben wir auf dem Raspi einen digitalen stream der Daten.

Im Moment schaut das analog so aus:

Lieben Gruss,
Steini
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

kermit943, 2019-06-15:
Guten Morgen Steini
kurz: Pommes und ich versuchen uns grade an einer Lösung die auf den RaspberryPi verzichtet, wenn wir ein bisschen weiter sind, zeigen wir das mal vor.

Außer dem probieren wir das ganze mit TWI (I2C) statt UART und Multiplexer umzusetzen.
Dafür lasse ich 3 ATMegas Module Simulieren Blutdruck, Herzrate und EKG. was bissher auch funktioniert.
Nur bin ich mit meiner EKG sache nicht ganz zu frieden ich arbeite mit delays und setze ein wert zwischen 126 und 142, sieht im Plotter richtig gut aus, aufm display dann aber bisschen gequetscht da ich wahrscheinlich mehr werte brauche.

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

Bild zeigt EKG, BD 120 zu 90 und 80er Puls

soviel dazu
ähm sollte bei dir ein Bild angehängt sein?

Im moment ist nach dem ":"   weiß .

Liebe Grüße Kermit

steini-at-cadus, 2019-06-15:
Moin,

Jo, auf den Raspi zu verzichten is ne gute Idee. Das Ding treibt die Kosten. Ich sehe da eher so was wie n ESP32 oder so. Billig und mach gleich wifi.
Irgendwo nen Raspi als server für viele Patienten würde ja reichen.

Kannste für die Simulation nich real-Daten nehmen? Gibts doch bestimmt im Netz. Ist halt immer so ne Sache mit der time-base...
Oder noch besser, ne ECG Platine nachbauen und echte Daten nehmen ;-)
Was wollt ihr als Display nehmen?

Und ja, da hing ein Bild dran. Hier noch mal:

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

kermit943, 2019-06-15:
Du bist ja auch zeitig wach.
über den esp32 haben wir auch nach gedacht, sind aber zu dem schluss gekommen, dass das Kanonen auf Spatzen wären, also der esp8266. bei mir in Form eines esp12 aufm wemos clon.
Pommes baut das web interface zurzeit auf dem Esp-01. ist ja dann kompatibel.

wir haben seit gestern ein ecg Modul von eBay das ist wahrscheinlich qualitativ nicht zuvergleichen aber könnte uns erstmal Werte geben.
besser wäre natürlich wenn ihr noch eine EKG Platine rumliegen habt die wir uns leihen könnten.

als display habe ich an ein nextion gedacht was aber noch irgend wo im Versand hängt -.-
ich probiere aber schon mal mit dem Nextion Editor rum, der hat einen Simulatior für die Displays.

irgend was stimmt bei dir mit den Bildern nicht.

Thread 7 (2019-12-11):

Microcontroller code needs rewrite

Zaph-O, 2019-12-11:
Code for Microcontroller was written in Atmel-Studio and needs to be rewritten in Arduino-Code for consitancy

[Link to code ](https://github.com/cadus/Hardware-Circuit-Boards/tree/master/Source_codes/SPO2)

seihan, 2020-01-18:
I have prepared a simple port here: https://github.com/seihan/arduino-pulsoxy
This is just a 'throw the C files into an Arduino project' approach. Are you looking for consistency only in the build system or should it all be translated into clean Arduino-style C++?

I also opened pull request https://github.com/cadus/Hardware-Circuit-Boards/pull/8 to import the project.
