cadus/Hardware-Circuit-Boards/Schematics and PCB as PDF and PNG/Blood_Pressure_schematic.pdf

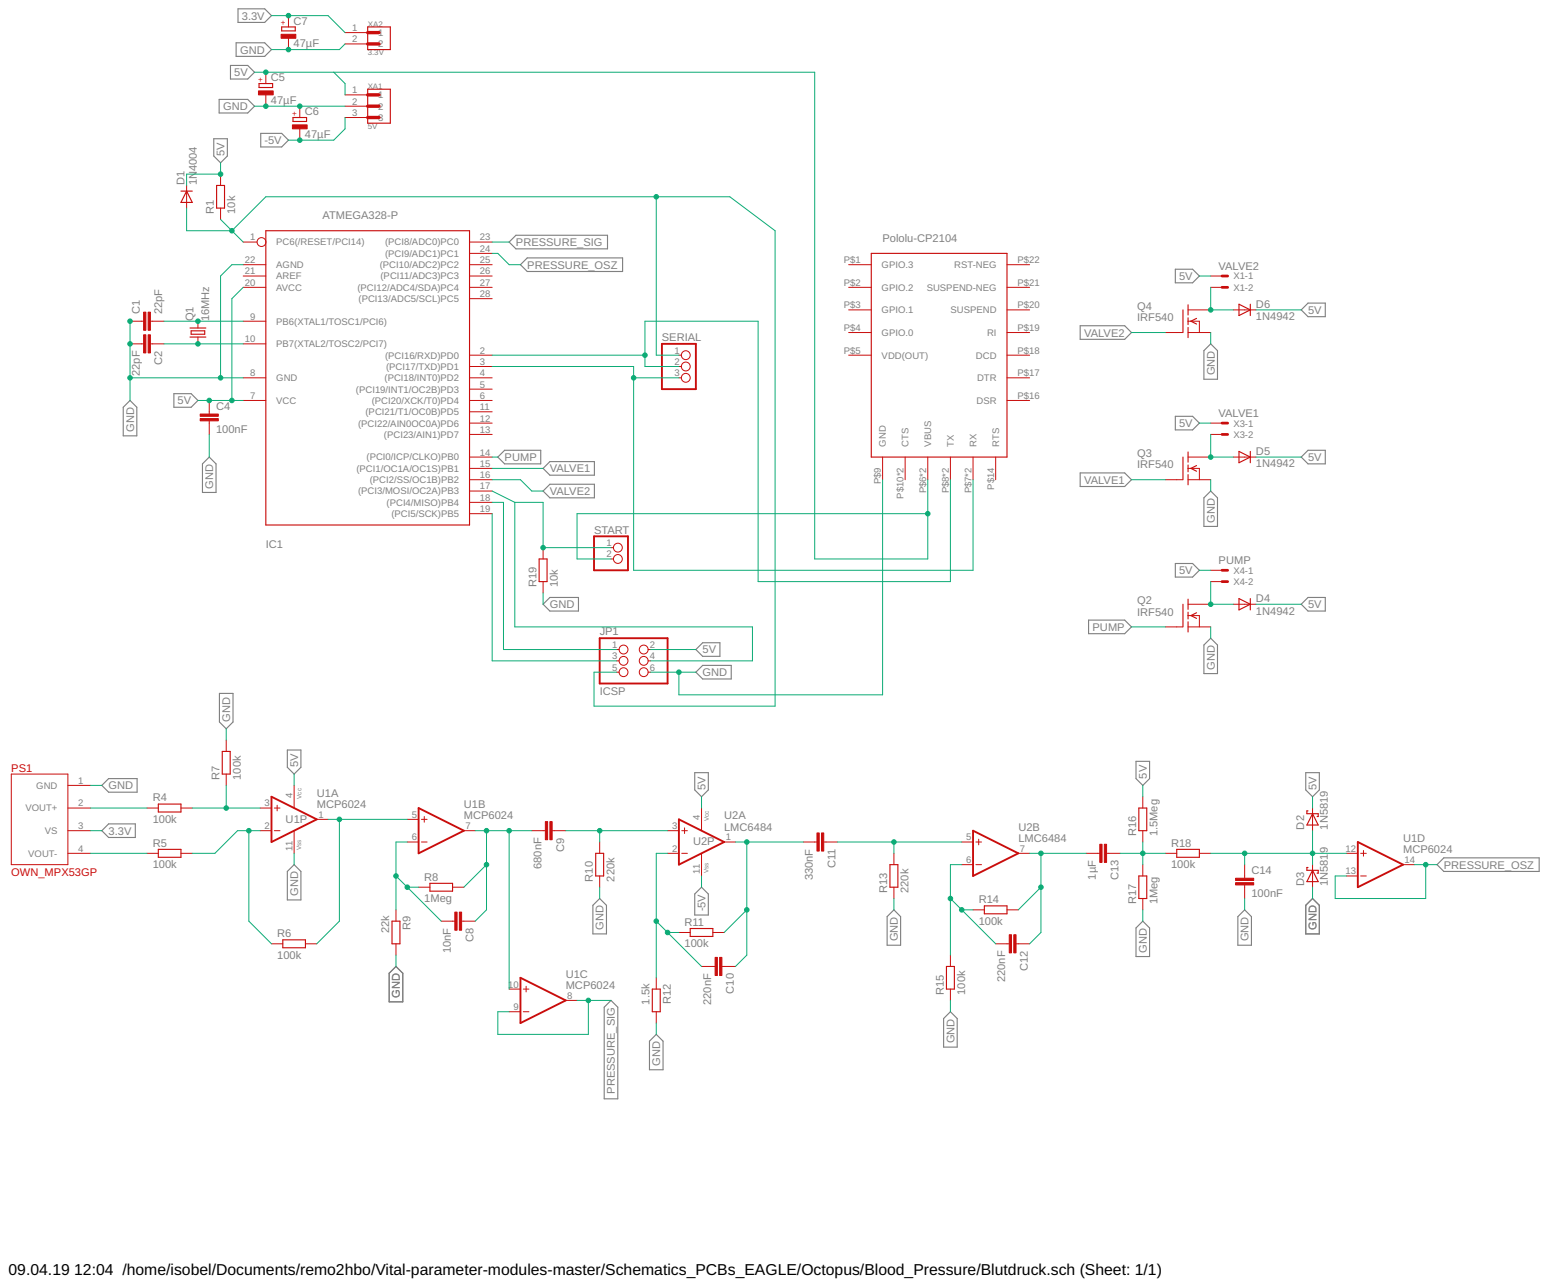
[picture p9: page 1]

09.04.19 12:04 /home/isobel/Documents/remo2hbo/Vital-parameter-modules-master/Schematics_PCBs_EAGLE/Octopus/Blood_Pressure/Blutdruck.sch (Sheet: 1/1)
