cadus/Hardware-Circuit-Boards/Schematics and PCB as PDF and PNG/ECG_HeartRate ECG_Monitoring_schematic.pdf

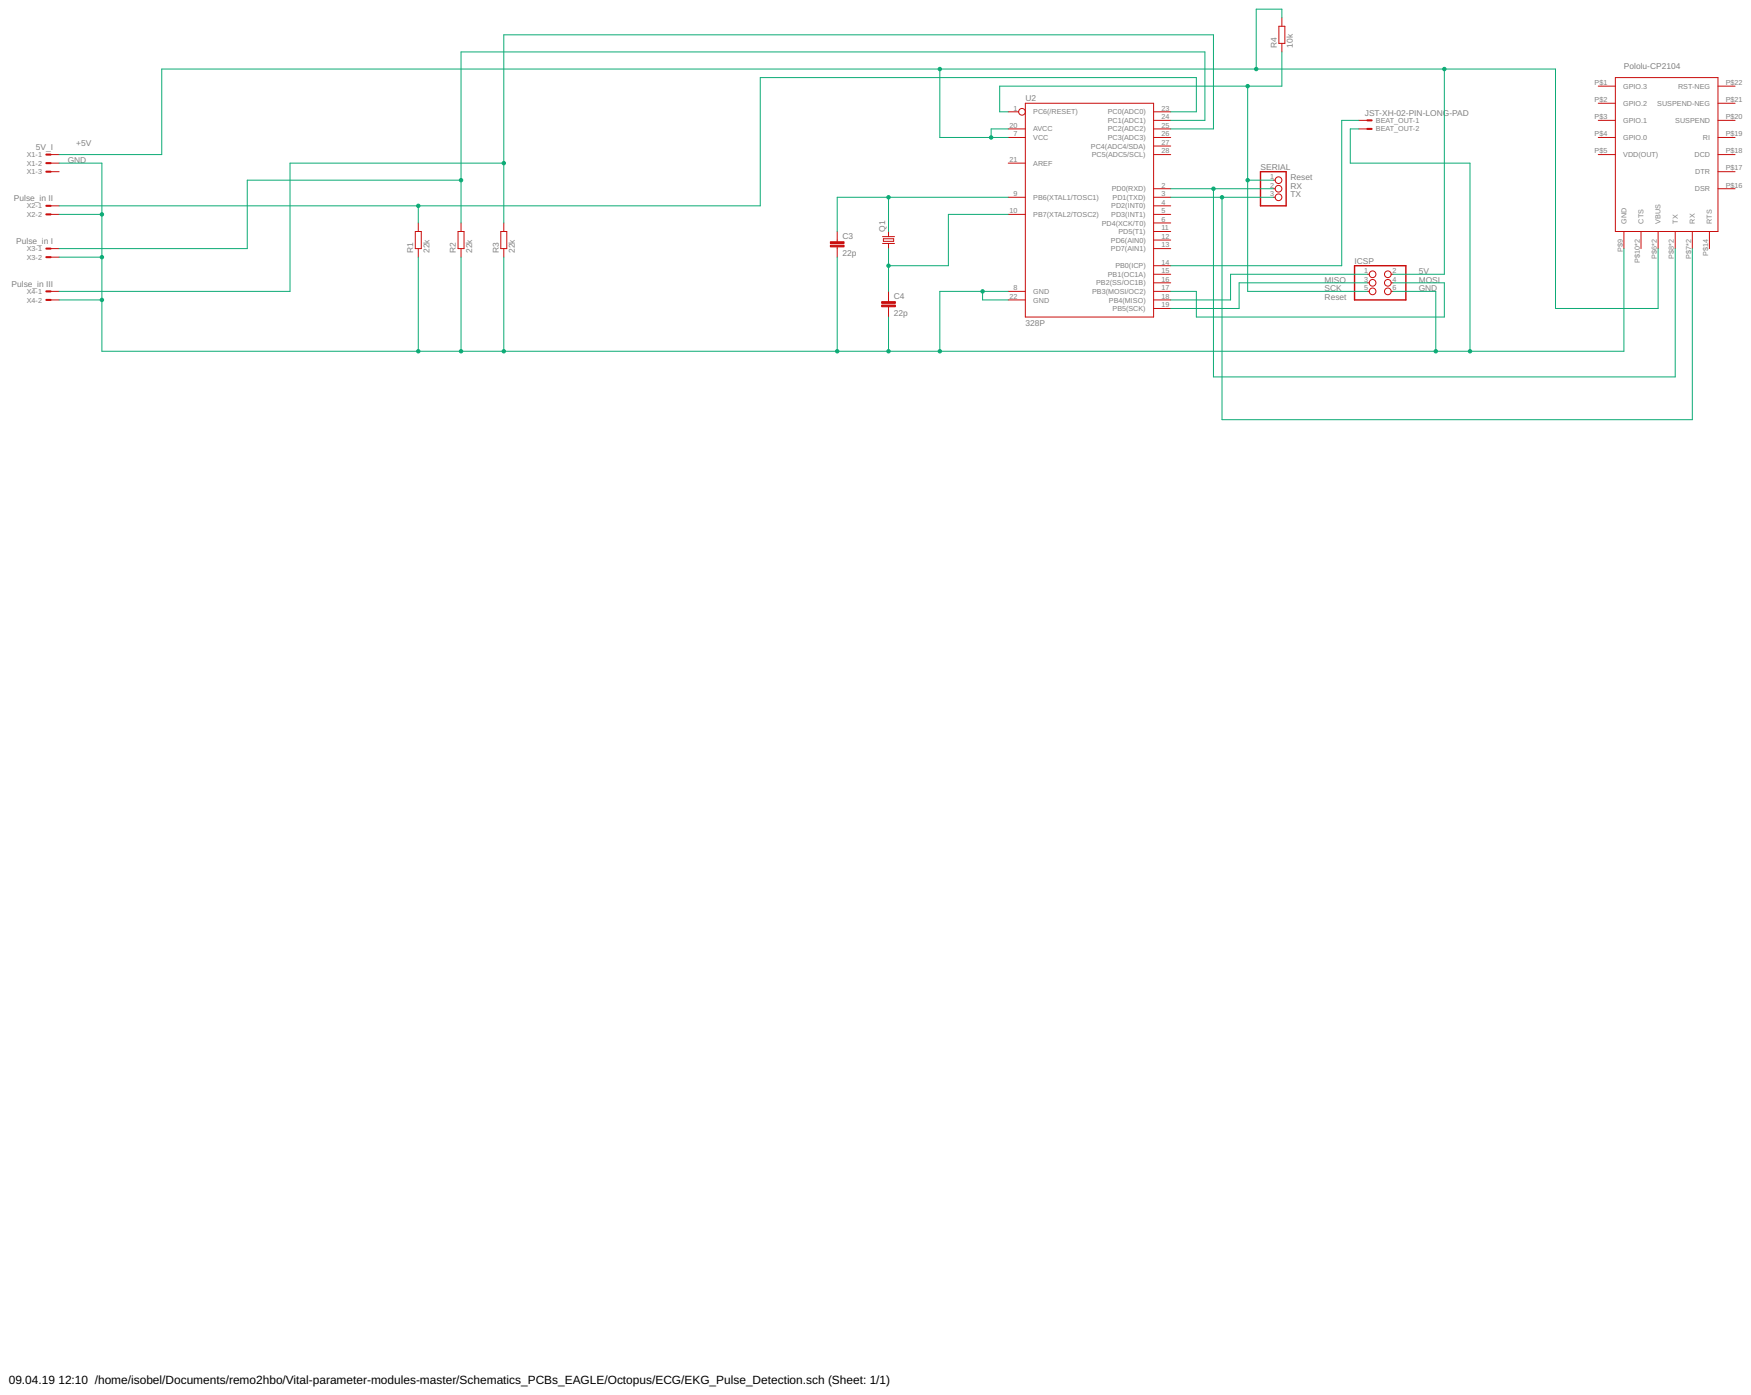
[picture p10: page 1]

JST-XH-02-PIN-LONG-PAD

09.04.19 12:10 /home/isobel/Documents/remo2hbo/Vital-parameter-modules-master/Schematics_PCBs_EAGLE/Octopus/ECG/EKG_Pulse_Detection.sch (Sheet: 1/1)
