cadus/Hardware-Circuit-Boards/Schematics and PCB as PDF and PNG/ECG_II_schematic.pdf

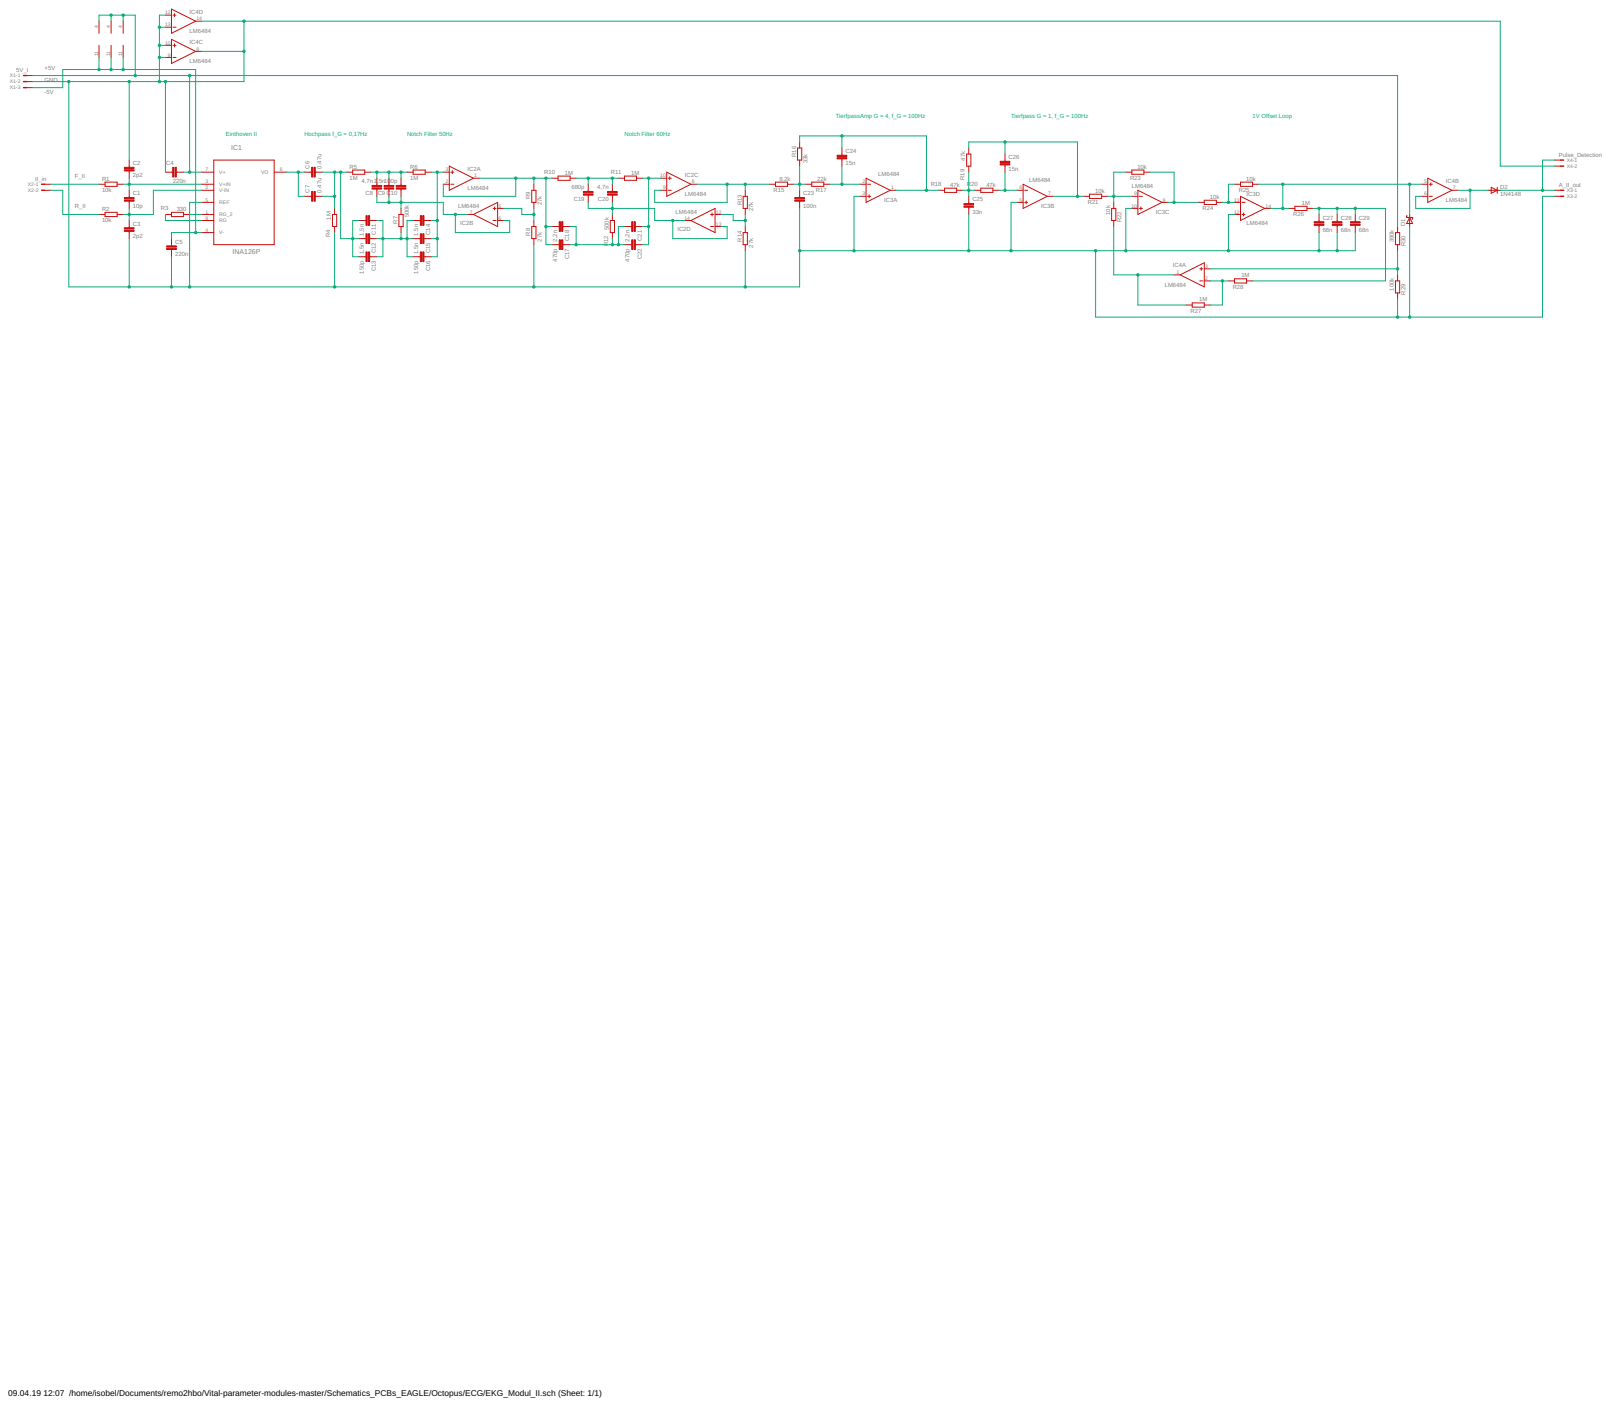
[picture p12: page 1]

09.04.19 12:07 /home/isobel/Documents/remo2hbo/Vital-parameter-modules-master/Schematics_PCBs_EAGLE/Octopus/ECG/EKG_Modul_II.sch (Sheet: 1/1)
