cadus/Hardware-Circuit-Boards/Schematics and PCB as PDF and PNG/ECG_III_schematic.pdf

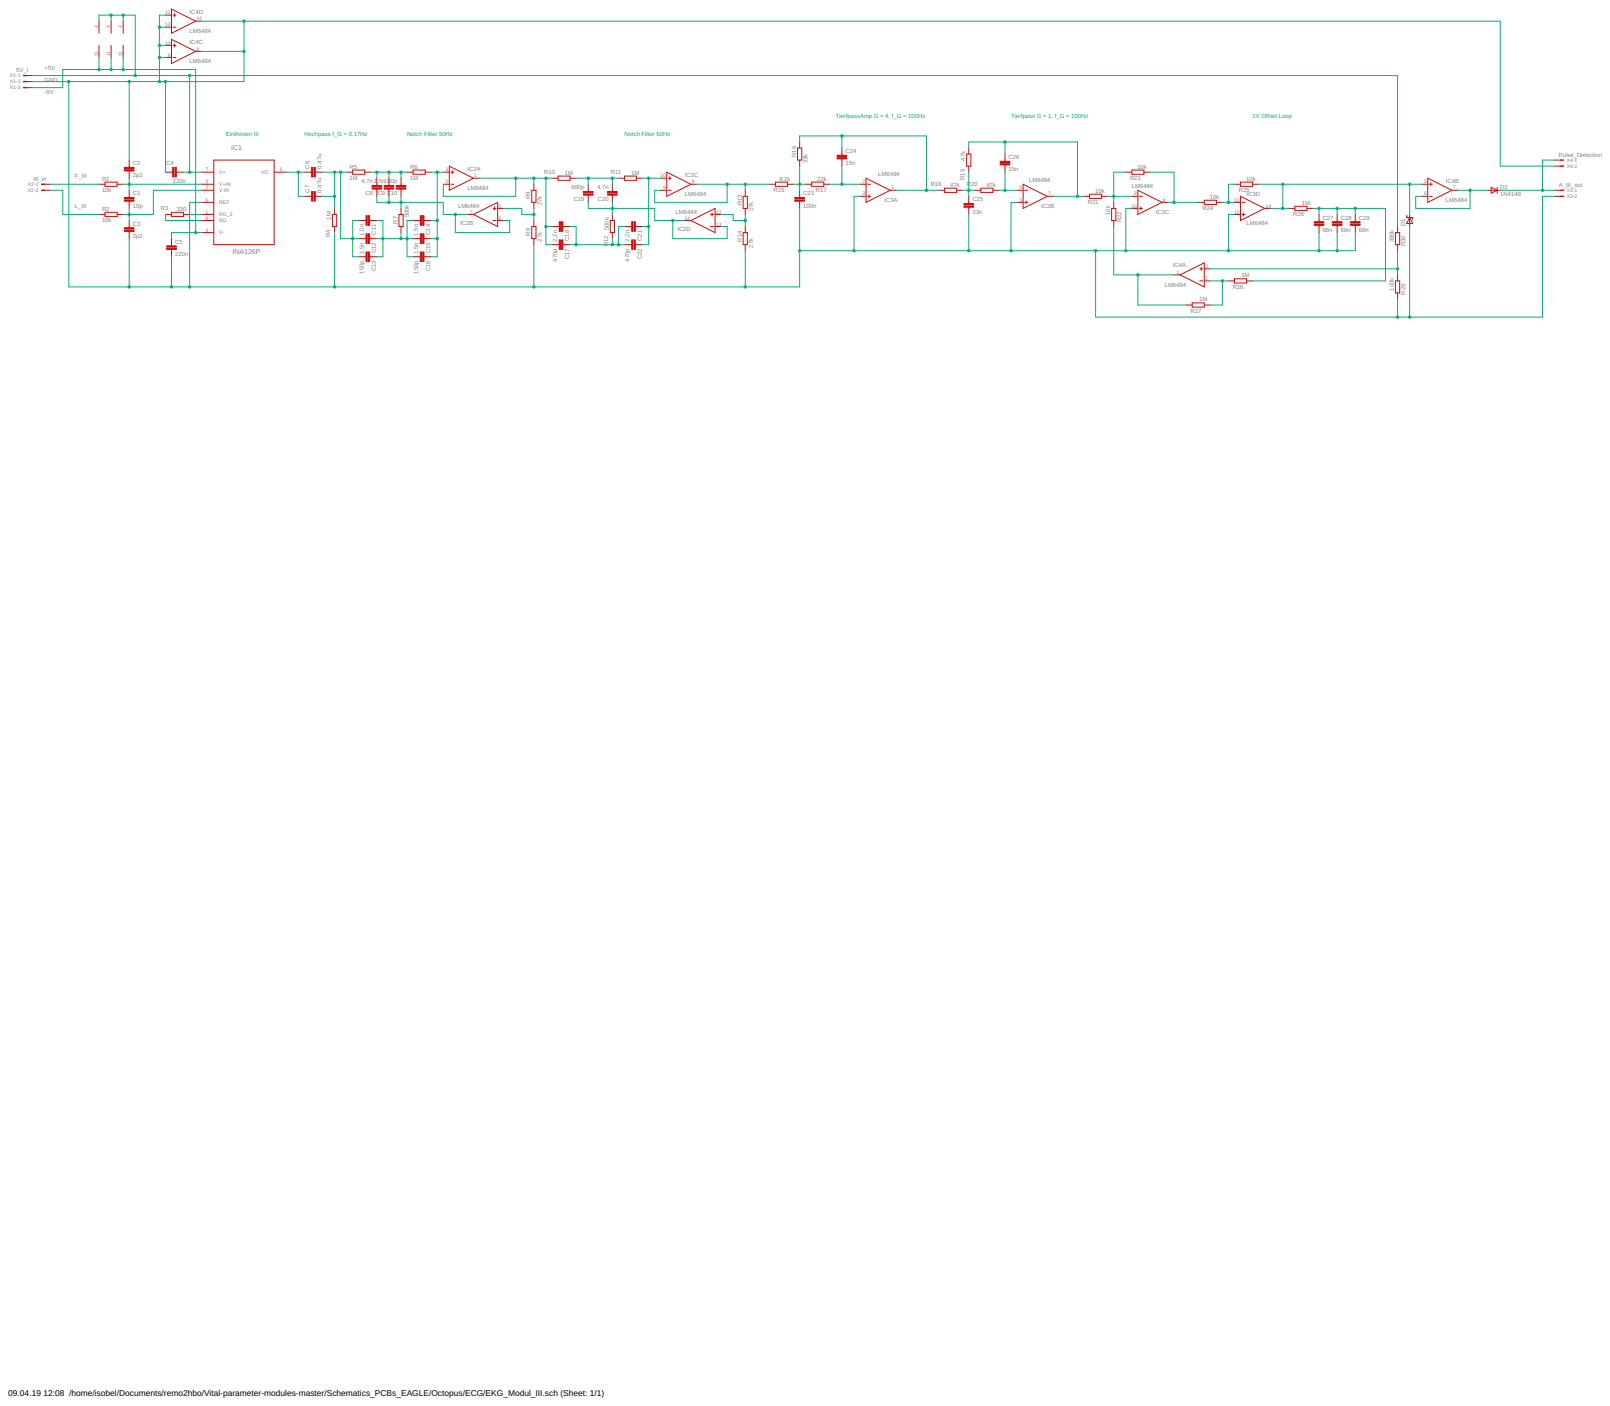
[picture p13: page 1]

09.04.19 12:08 /home/isobel/Documents/remo2hbo/Vital-parameter-modules-master/Schematics_PCBs_EAGLE/Octopus/ECG/EKG_Modul_III.sch (Sheet: 1/1)
