cadus/Hardware-Circuit-Boards/Schematics and PCB as PDF and PNG/ECG_Main_schematic.pdf

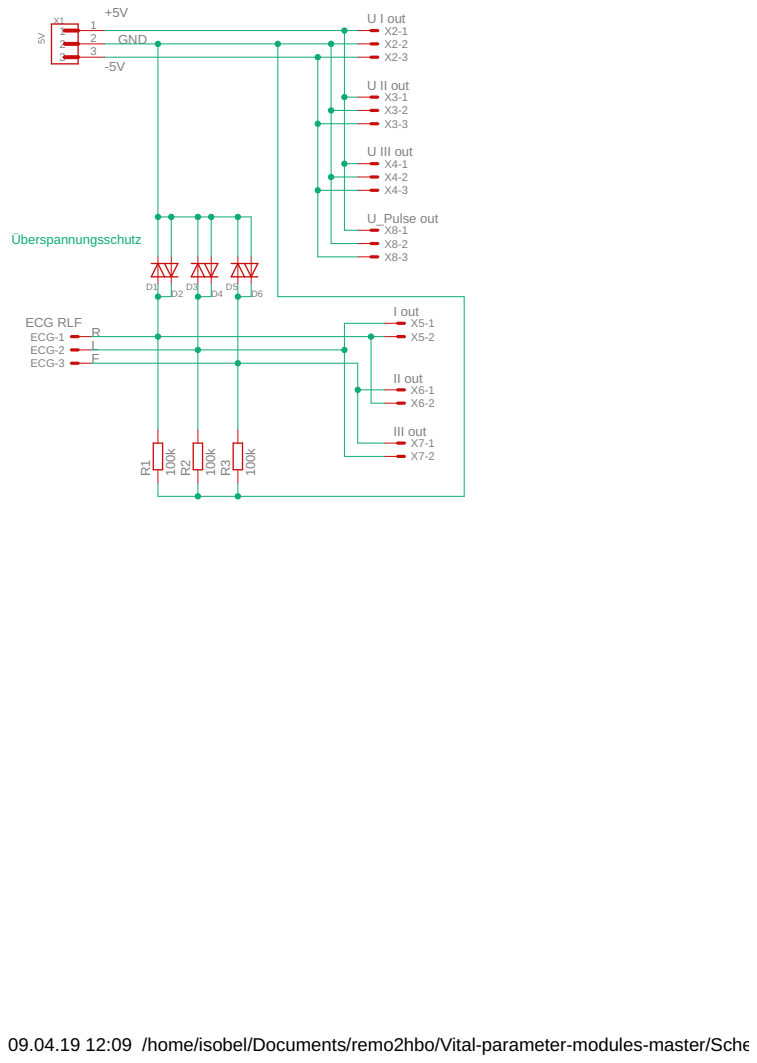
[picture p14: page 1]

09.04.19 12:09 /home/isobel/Documents/remo2hbo/Vital-parameter-modules-master/Schematics_PCBs_EAGLE/Octopus/ECG/EKG_Modul_Versorgung.sch (Sheet: 1/1)
