cadus/Hardware-Circuit-Boards/Schematics and PCB as PDF and PNG/OctoBrain2.pdf

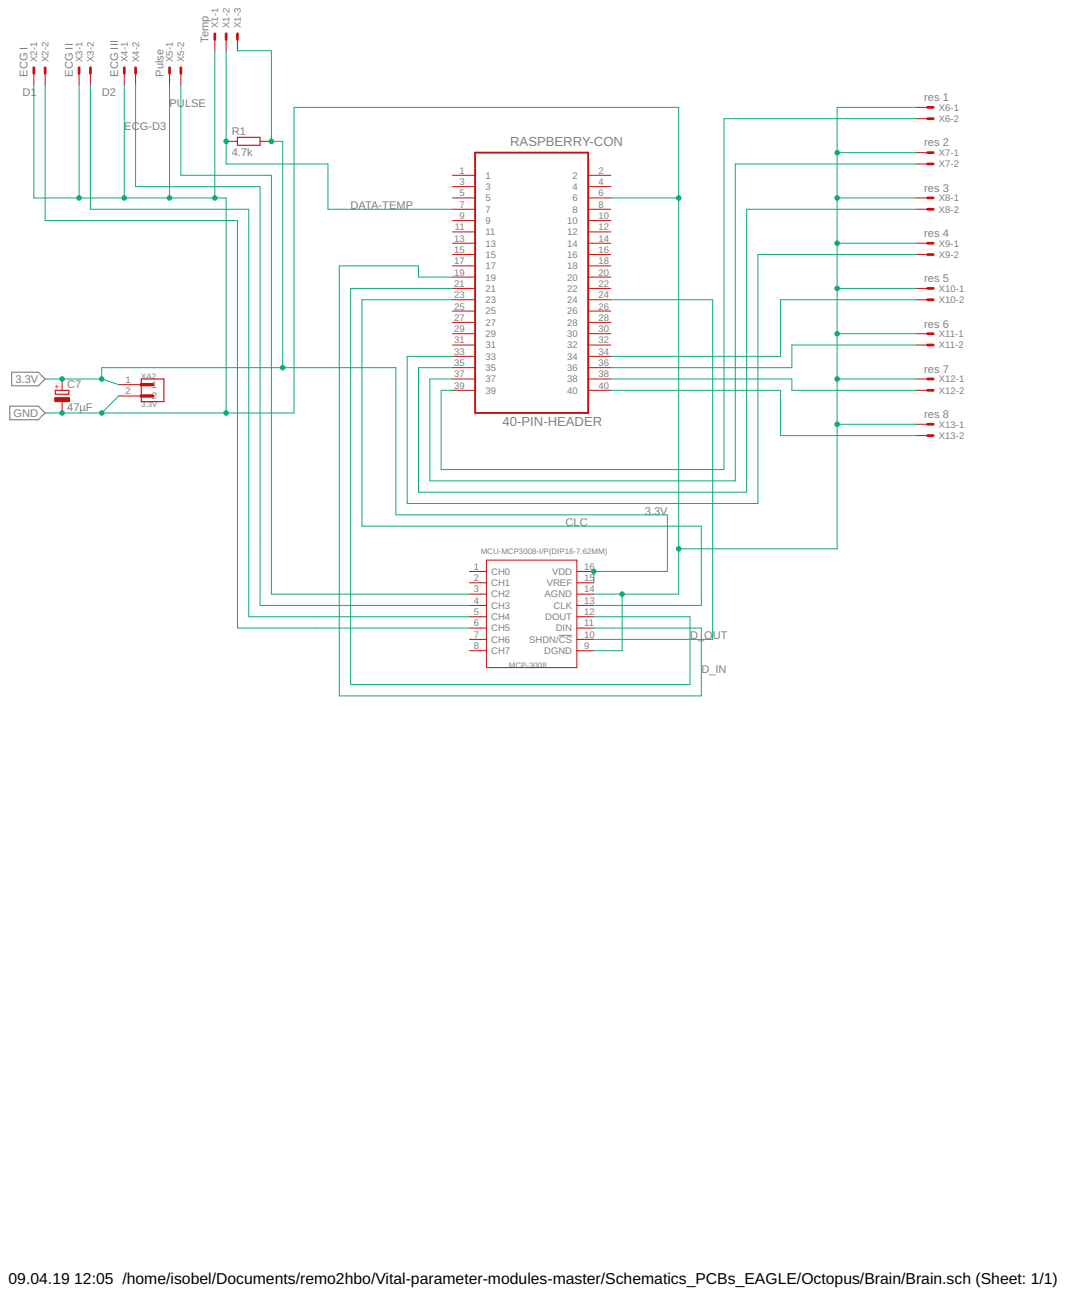
[picture p15: page 1]

ECG I ECG II ECG III Pulse

35 | 36
37 | 38
39 | 40

09.04.19 12:05 /home/isobel/Documents/remo2hbo/Vital-parameter-modules-master/Schematics_PCBs_EAGLE/Octopus/Brain/Brain.sch (Sheet: 1/1)
