cadus/Hardware-Circuit-Boards/Schematics and PCB as PDF and PNG/Power_Supply_schematic.pdf

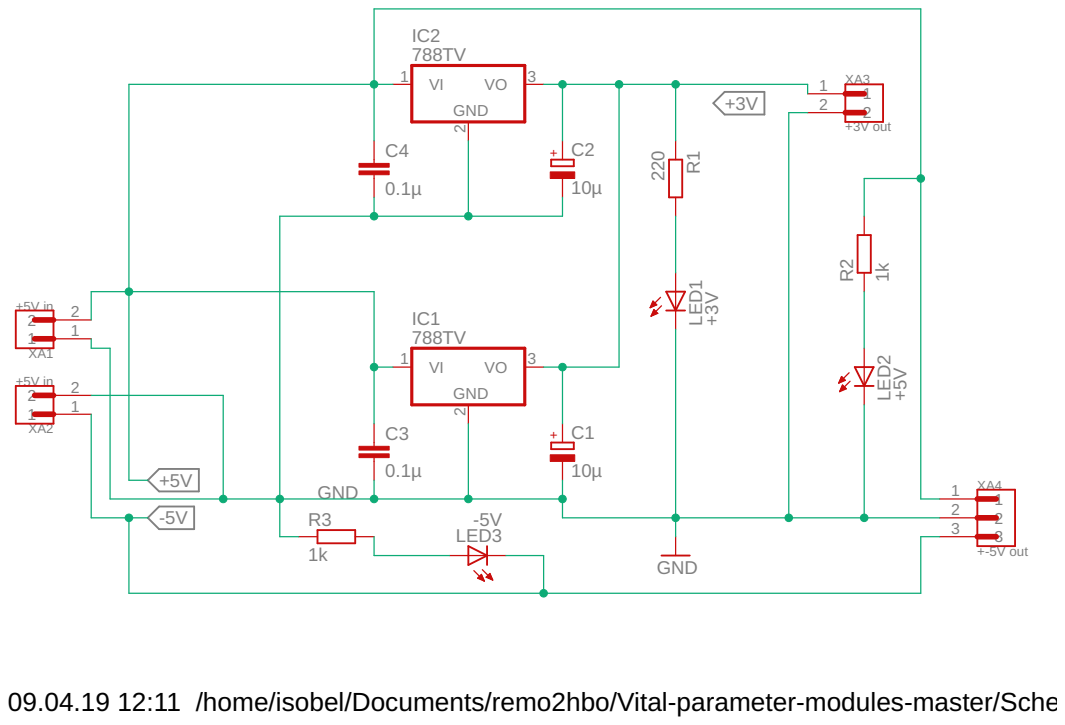
[picture p16: page 1]

09.04.19 12:11 /home/isobel/Documents/remo2hbo/Vital-parameter-modules-master/Schematics_PCBs_EAGLE/Octopus/Power_Supply/Spannungsversorgung.sch (Sheet: 1/1)
