cadus/Hardware-Circuit-Boards/Schematics and PCB as PDF and PNG/Pulsoxy_schematic.pdf

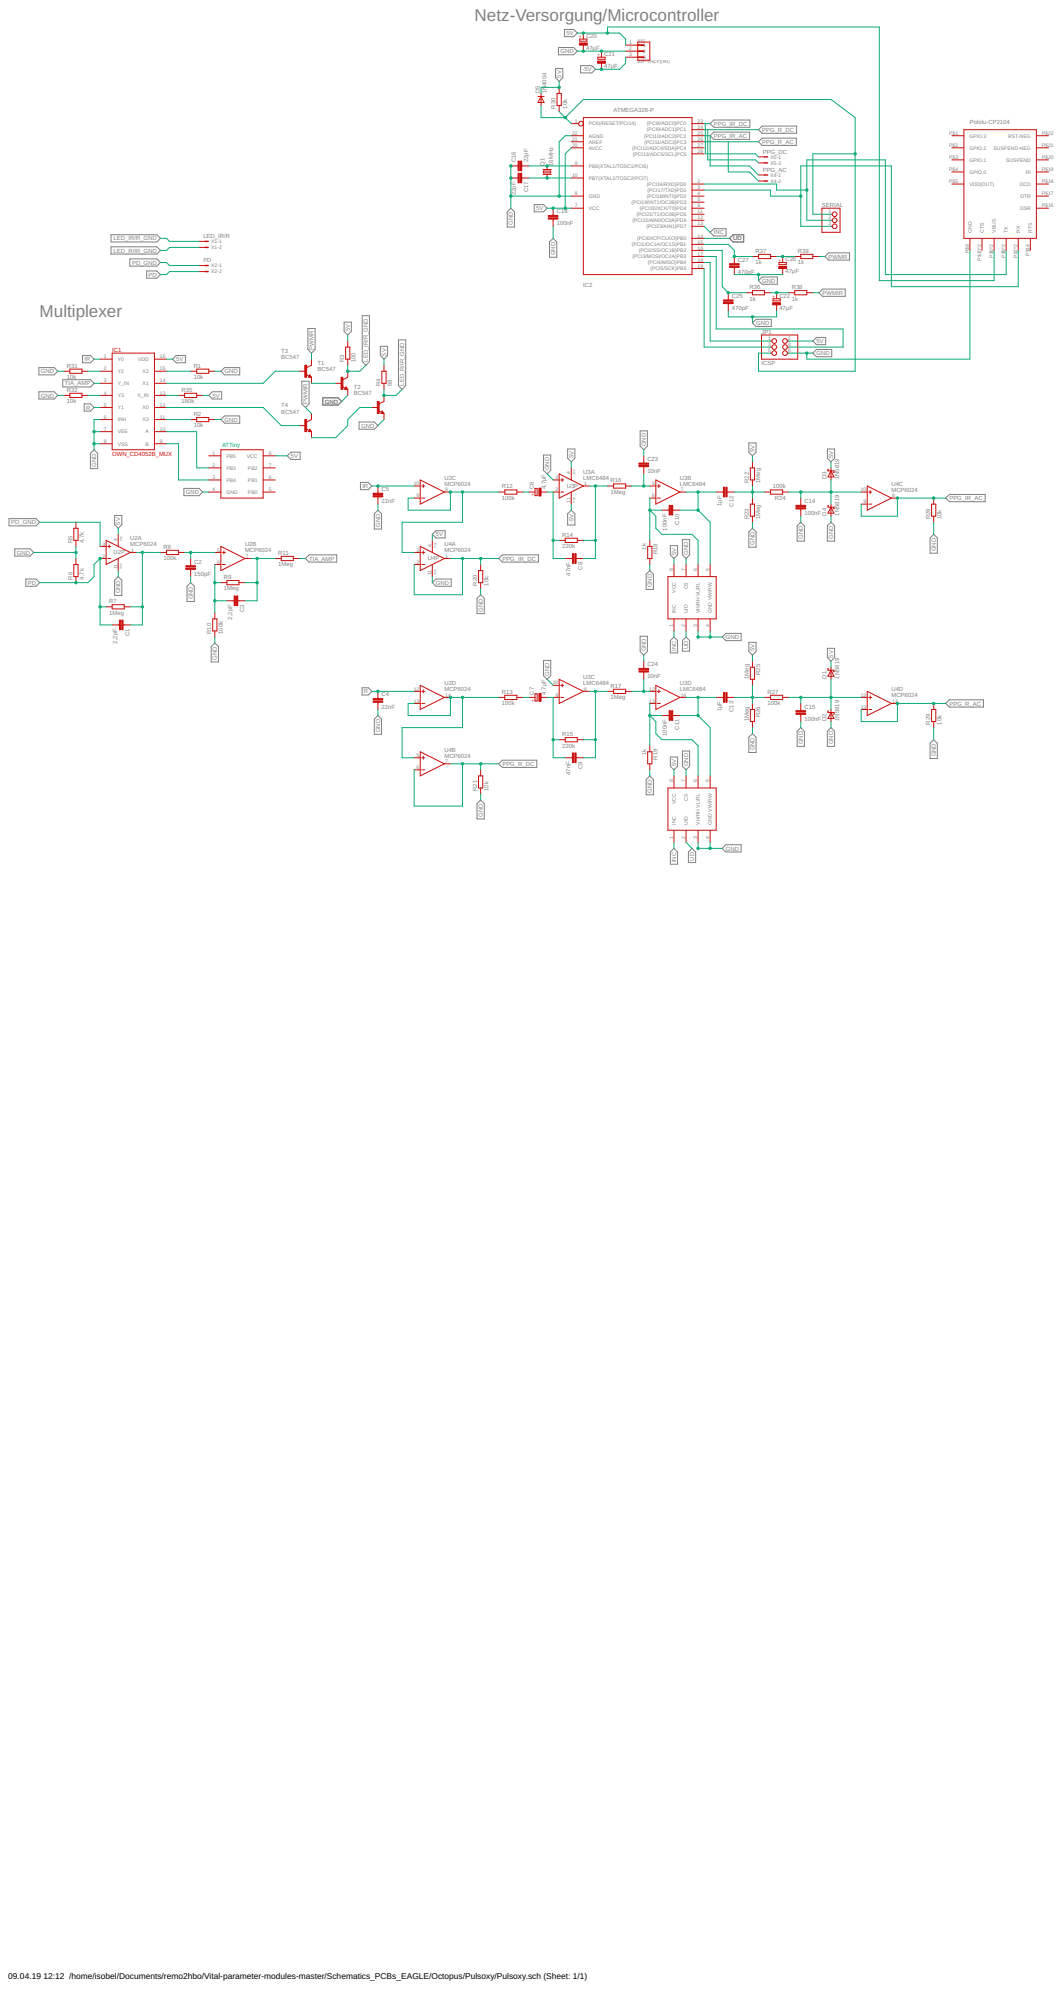
[picture p17: page 1]

GND GND GND

09.04.19 12:12 /home/isobel/Documents/remo2hbo/Vital-parameter-modules-master/Schematics_PCBs_EAGLE/Octopus/Pulsoxy/Pulsoxy.sch (Sheet: 1/1)
