cadus/Hardware-Circuit-Boards/Schematics and PCB as PDF and PNG/Heart_Rate ECG_Monitoring.pdf

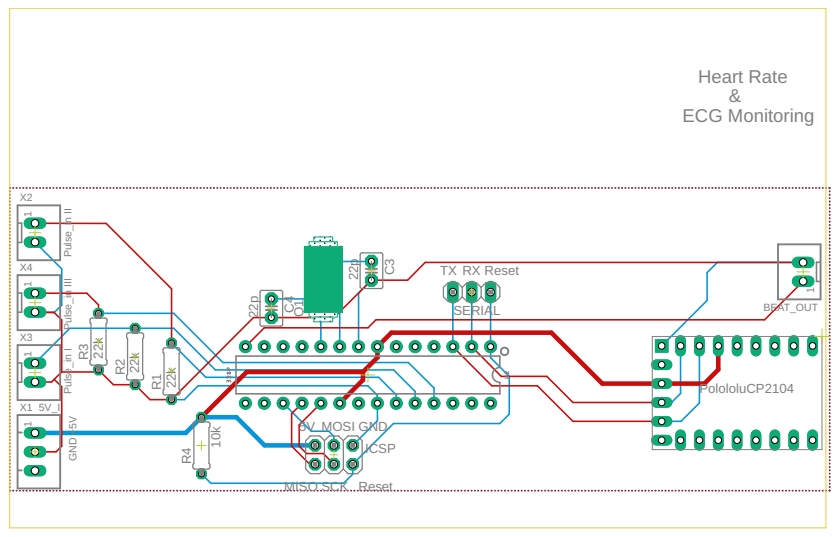
[picture p18: page 1]

1 1 1 1 1 TX RX Reset Reset 5V MOSI GND MISO SCK Heart Rate & ECG Monitoring +5V GND X1 5V_I X2 Pulse_in II Q1 C3 C4 ICSP SERIAL BEAT_OUT RPolololuCP2104 1R2R3 X3 Pulse_in I X4 Pulse_in III R4 22p 22p 222k22k2k 10k
