cadus/Hardware-Circuit-Boards/Schematics and PCB as PDF and PNG/OctoBrain.pdf

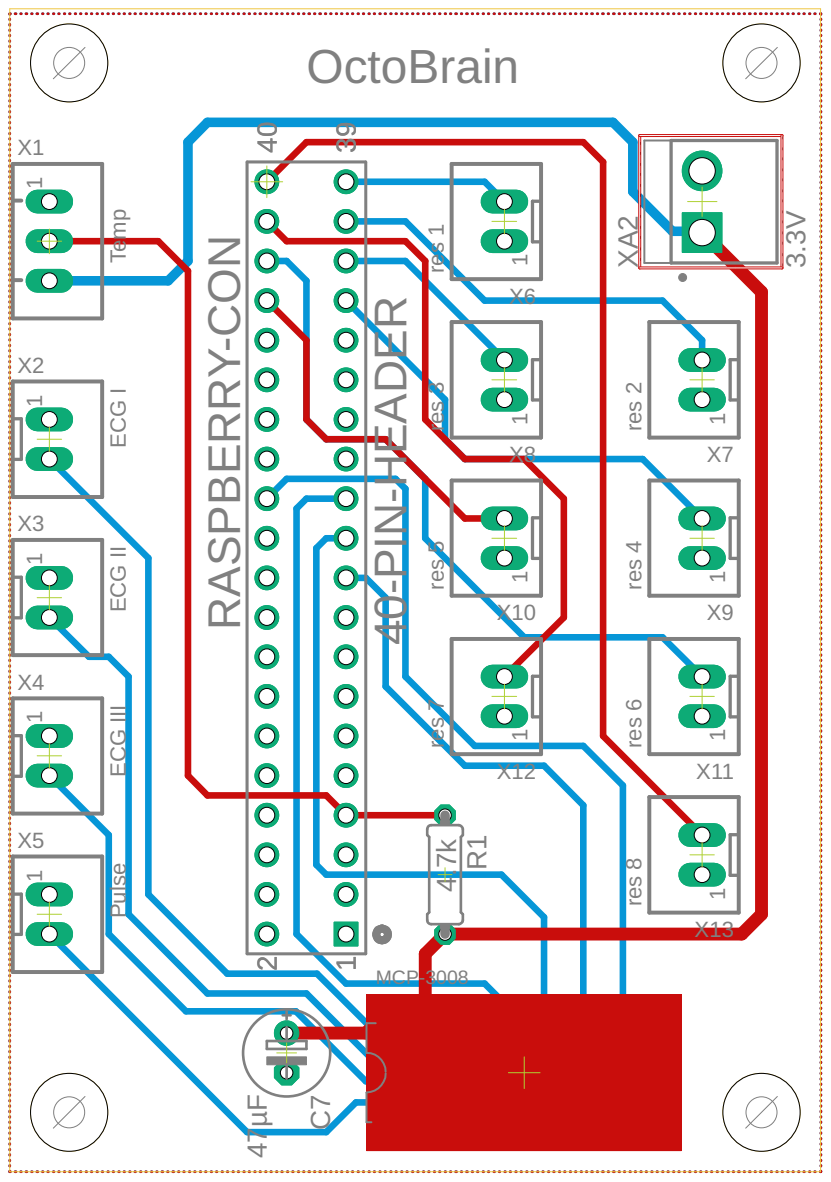
[picture p19: page 1]

21 3940 21 3940 1 1 1 1 1 1 11 11 11 1 OctoBrain C7 MCP-3008 R1 RASPBERRY-CONXA2 3.3V X1 Temp X2 ECG I X3 ECG II X4 ECG III X5 Pulse X6 res 1 X8 X7 res 3 X9 res 4 X10 res 5 X11 res 6 X12 res 7 X13 res 8 47µF 4.7k 40-PIN-HEADER res 2
