cadus/Hardware-Circuit-Boards/Schematics and PCB as PDF and PNG/Blood_Pressure.pdf

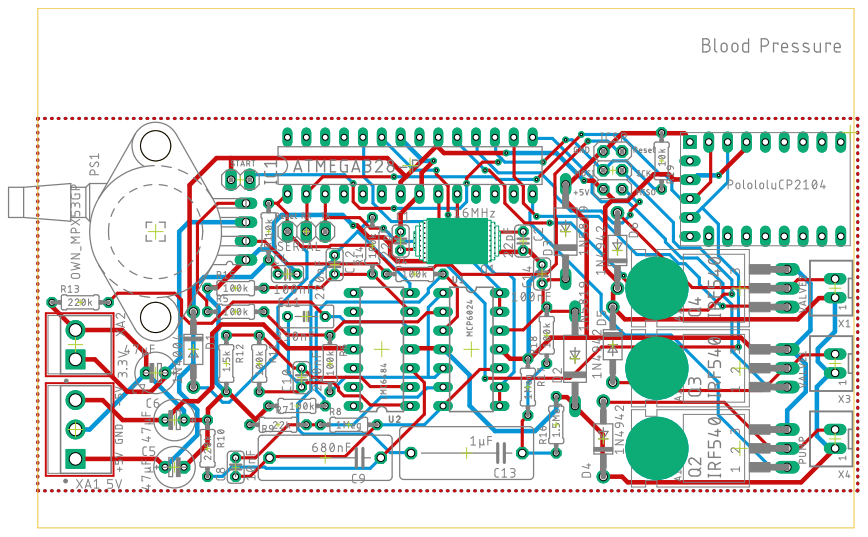
[picture p20: page 1]
