cadus/Hardware-Circuit-Boards/Schematics and PCB as PDF and PNG/ECG_I.pdf

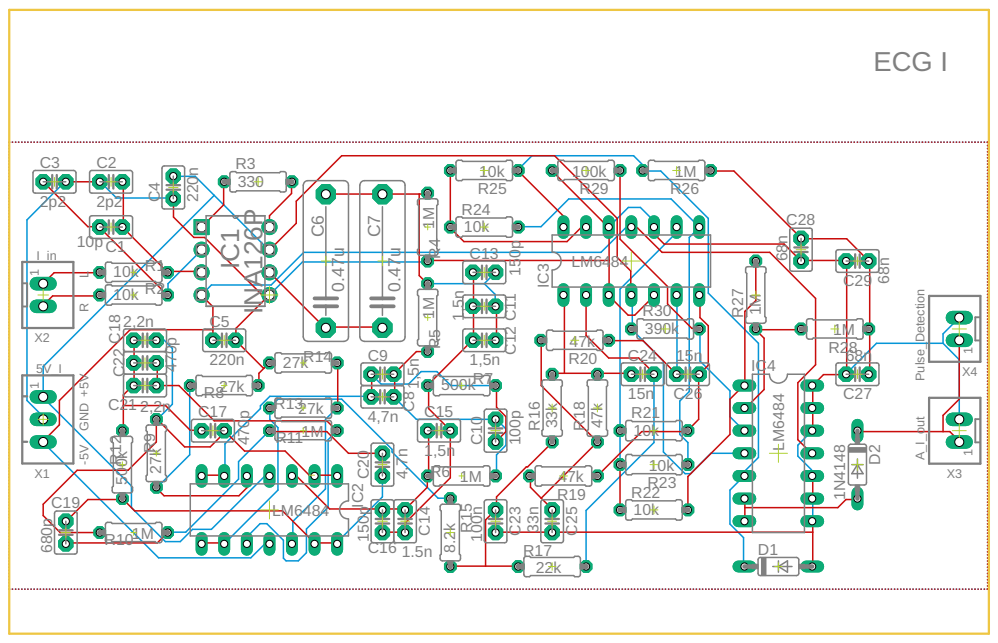
[picture p21: page 1]
