cadus/Hardware-Circuit-Boards/Schematics and PCB as PDF and PNG/ECG_II.pdf

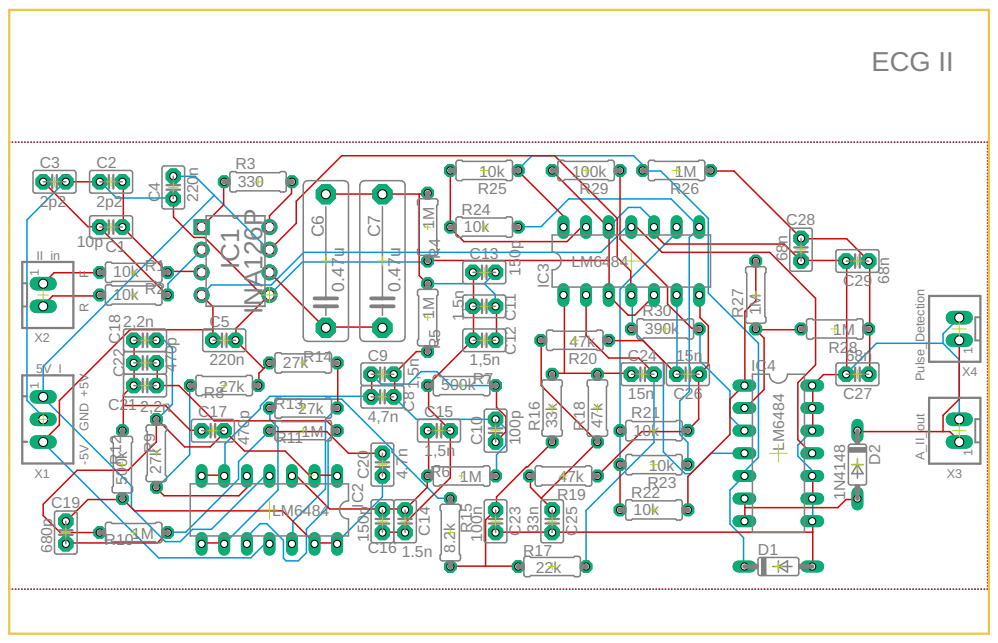
[picture p22: page 1]
