cadus/Hardware-Circuit-Boards/Schematics and PCB as PDF and PNG/ECG_III.pdf

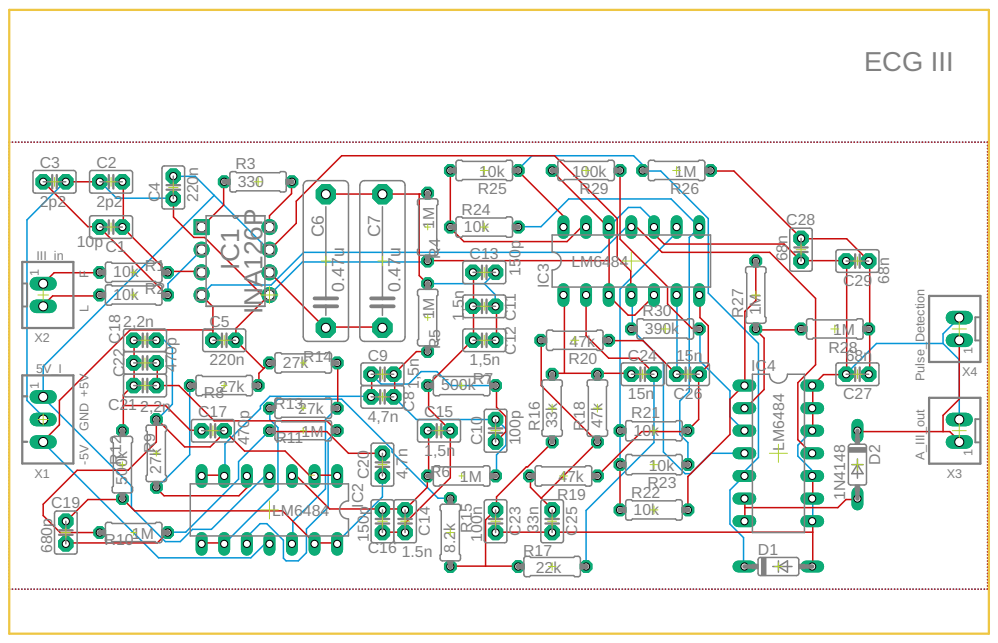
[picture p23: page 1]
