cadus/Hardware-Circuit-Boards/Schematics and PCB as PDF and PNG/ECG_Main.pdf

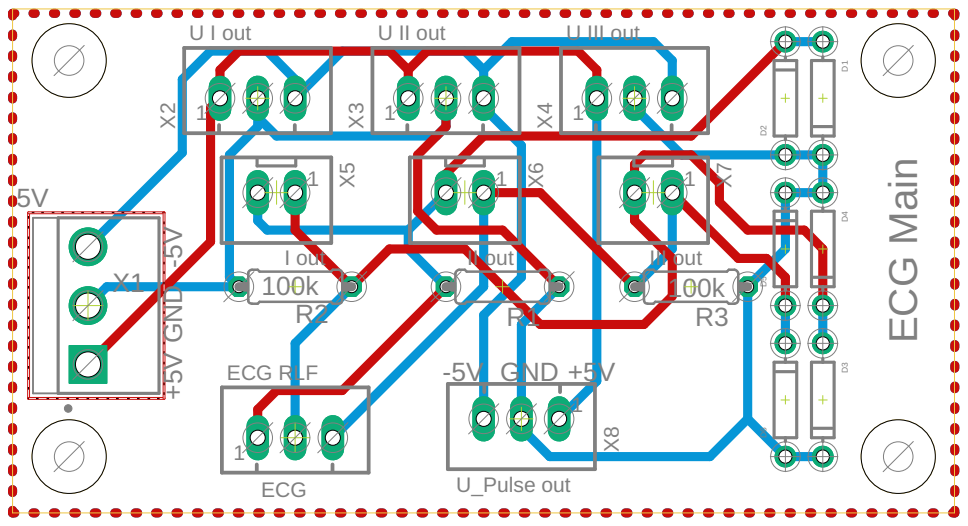
[picture p24: page 1]
