cadus/Hardware-Circuit-Boards/Schematics and PCB as PDF and PNG/Power_Supply.pdf

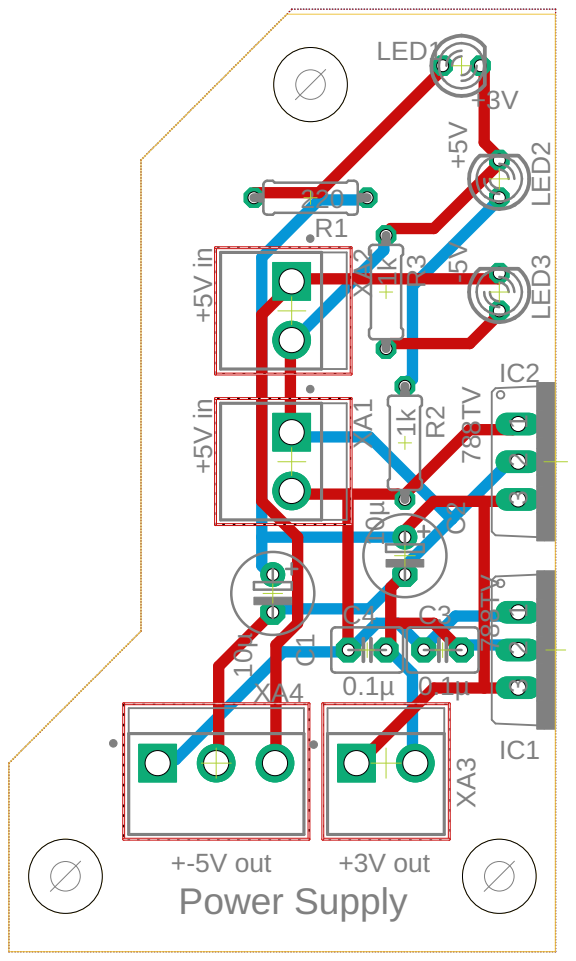
[picture p25: page 1]
