cadus/Hardware-Circuit-Boards/Schematics and PCB as PDF and PNG/PTT.pdf

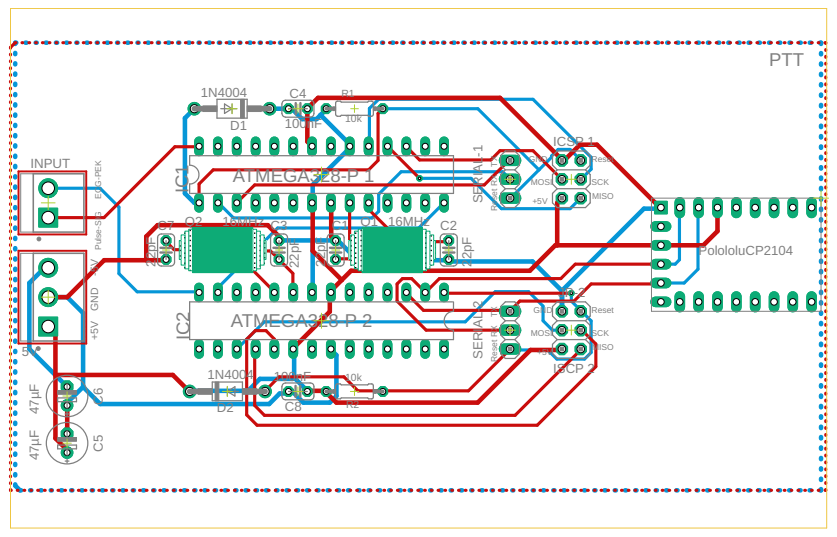
[picture p26: page 1]
