cadus/Hardware-Circuit-Boards/Schematics and PCB as PDF and PNG/Pulsoxy.pdf

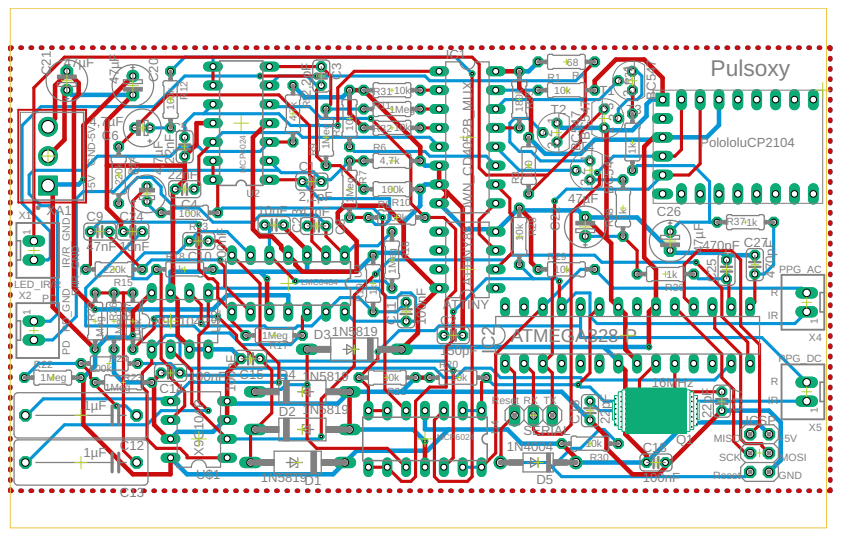
[picture p27: page 1]

16MHz
