cadus/Hardware-Circuit-Boards/Schematics_PCBs_EAGLE/Octopus/Blood_Pressure/Blutdruck.brd

## EAGLE design Schematics_PCBs_EAGLE/Octopus/Blood_Pressure/Blutdruck.brd (2019-03-29)

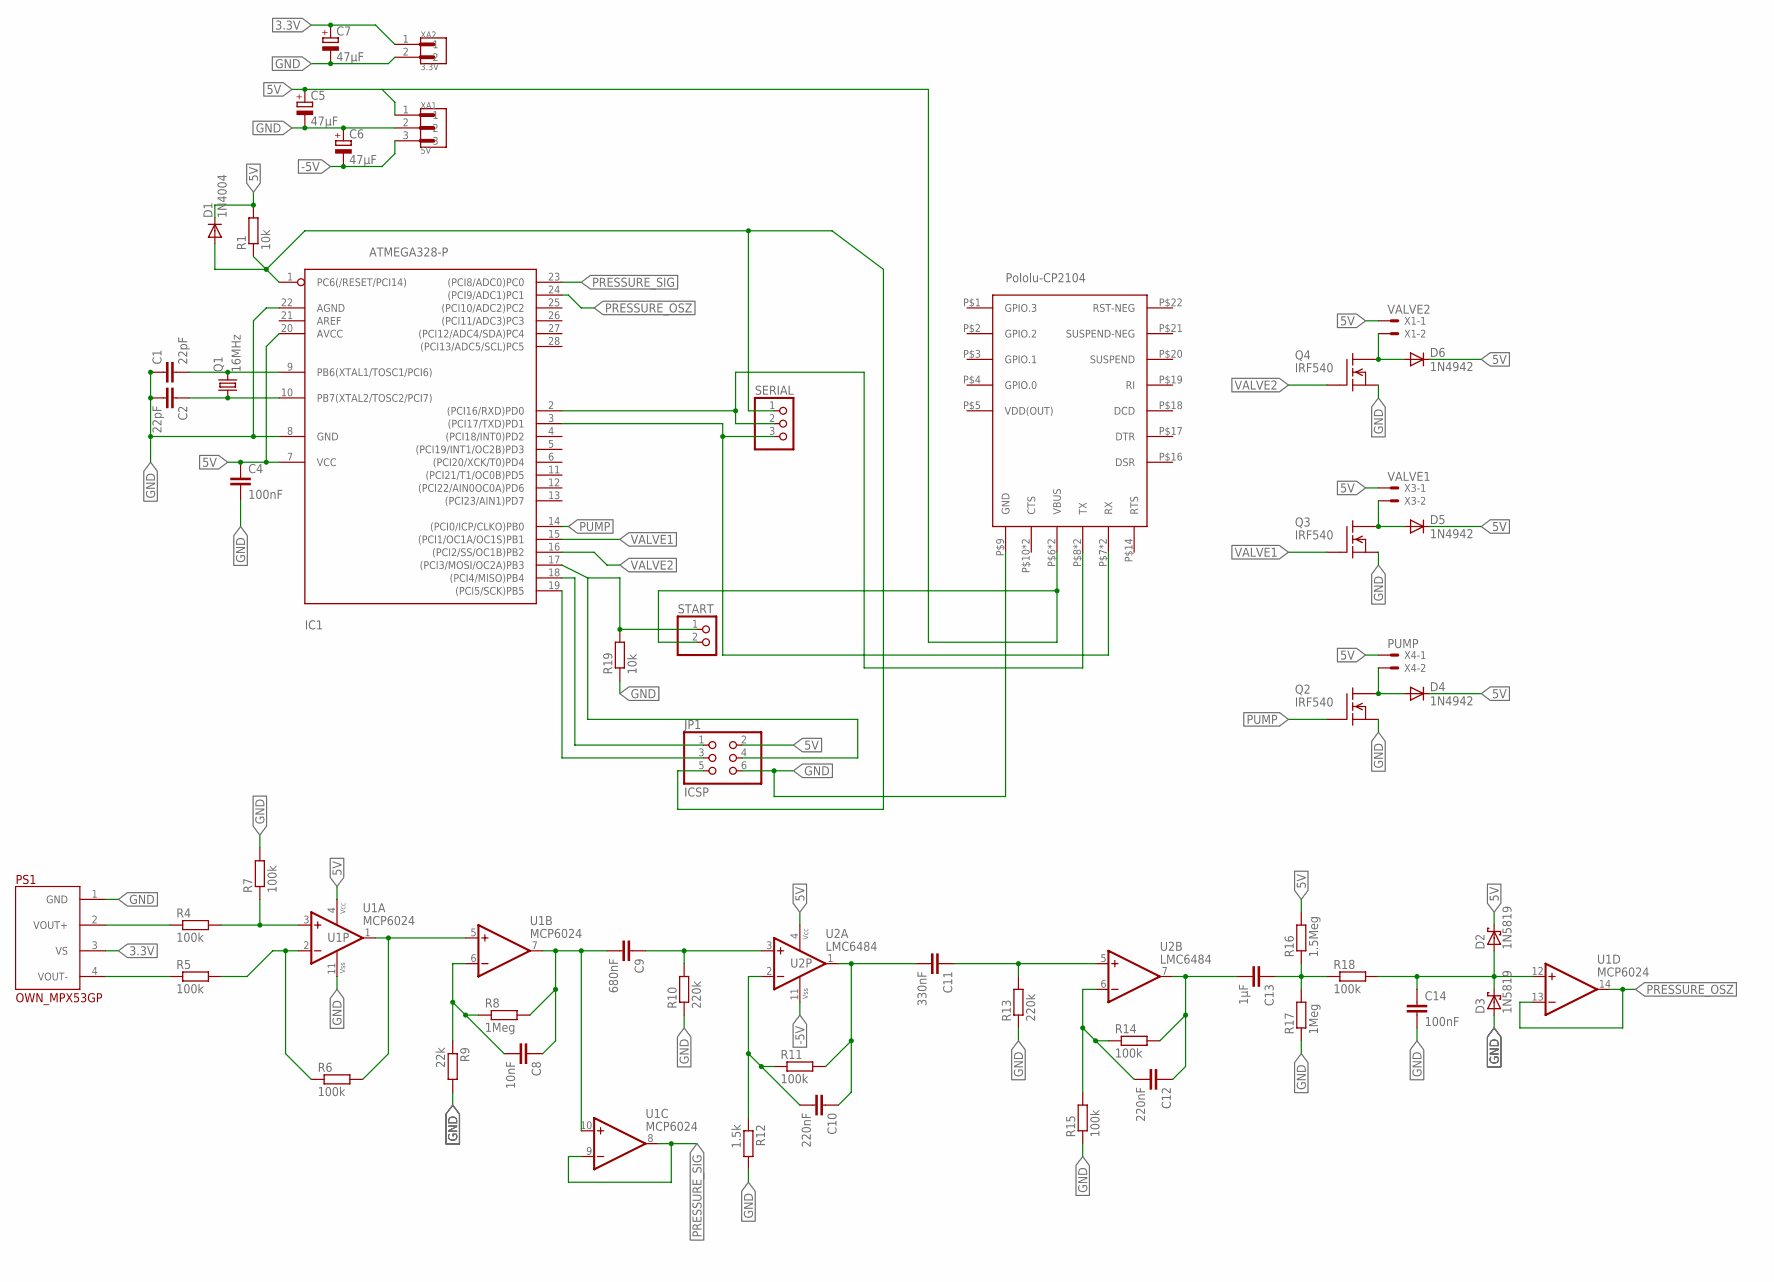
[picture p28: schematic Blutdruck.sch]

Parts:
C1, C2: 22pF; C025-024X044
C4, C14: 100nF; C025-024X044
C5, C6, C7: 47µF; E2,5-6E
C8: 10nF; C025-024X044
C9: 680nF; C150-064X183
C10, C12: 220nF; C025-024X044
C11: 330nF; C050-030X075
C13: 1µF; C150-072X183
D1: 1N4004; DO41-10
D2, D3: 1N5819; F126Z12
D4, D5, D6: 1N4942; DO41-10
IC1: ATMEGA328-P; DIL28-3
JP1: ICSP; 2X03
PS1: OWN_MPX53GP; MPX53
Q1: 16MHz; HC49U70
Q2, Q3, Q4: IRF540; TO220
R1, R19: 10k; 0204/7
R4, R5, R6, R7, R11, R14, R15, R18: 100k; 0204/7
R8, R17: 1Meg; 0204/7
R9: 22k; 0204/7
R10, R13: 220k; 0204/7
R12: 1.5k; 0204/7
R16: 1.5Meg; 0204/7
SERIAL: PINHD-1X3; 1X03
START: PINHD-1X2; 1X02
U1: MCP6024; DIL14
U2: LMC6484; DIL14
U$1: POLOLU_CP2104; POLOLUCP2104
X1: VALVE2; JST-XH-02-PACKAGE-LONG-PAD
X3: VALVE1; JST-XH-02-PACKAGE-LONG-PAD
X4: PUMP; JST-XH-02-PACKAGE-LONG-PAD
XA1: 5V; JST_B3P-VH(LF)(SN)
XA2: 3.3V; JST_B2P-VH(LF)(SN)

Connections:
3.3V: C7.+, PS1.3 (VS), XA2.1
5V: C4.1, C5.+, D1.C, D2.C, D4.C, D5.C, D6.C, IC1.7 (VCC), IC1.20 (AVCC), JP1.2, R1.2, R16.2, START.2, U1.4 (VCC+), U2.4 (VCC+), U$1.P$6 (VBUS), U$1.P$11 (VBUS), X1.1, X3.1, X4.1, XA1.1
-5V: C6.-, U2.11 (VCC-), XA1.3
GND: C1.1, C2.2, C4.2, C5.-, C6.+, C7.-, C14.2, D3.A, IC1.8 (GND), IC1.22 (AGND), JP1.6, PS1.1 (GND), Q2.3 (S), Q3.3 (S), Q4.3 (S), R7.2, R9.2, R10.1, R12.2, R13.1, R15.1, R17.1, R19.1, U1.11 (VCC-), U$1.P$9 (GND), XA1.2, XA2.2
unnamed: PS1.2 (VOUT+), R4.1
unnamed: R4.2, R7.1, U1.3 (+IN)
unnamed: PS1.4 (VOUT-), R5.1
unnamed: R5.2, R6.1, U1.2 (-IN)
unnamed: R6.2, U1.1 (OUT), U1.5 (+IN)
unnamed: C8.2, R8.1, R9.1, U1.6 (-IN)
unnamed: C8.1, C9.2, R8.2, U1.7 (OUT), U1.10 (+IN)
unnamed: C9.1, R10.2, U2.3 (+IN)
unnamed: C10.2, R11.1, R12.1, U2.2 (-IN)
unnamed: C10.1, C11.2, R11.2, U2.1 (OUT)
unnamed: C11.1, R13.2, U2.5 (+IN)
unnamed: C12.2, R14.1, R15.2, U2.6 (-IN)
unnamed: C12.1, C13.2, R14.2, U2.7 (OUT)
unnamed: C13.1, R16.1, R17.2, R18.1
unnamed: C14.1, D2.A, D3.C, R18.2, U1.12 (+IN)
unnamed: D4.A, Q2.2 (D), X4.2
unnamed: D5.A, Q3.2 (D), X3.2
unnamed: D6.A, Q4.2 (D), X1.2
unnamed: IC1.17 ((PCI3/MOSI/OC2A)PB3), JP1.4, R19.2, START.1
unnamed: IC1.2 ((PCI16/RXD)PD0), SERIAL.2, U$1.P$8 (TX), U$1.P$12 (TX)
unnamed: IC1.3 ((PCI17/TXD)PD1), SERIAL.3, U$1.P$7 (RX), U$1.P$13 (RX)
unnamed: C1.2, IC1.9 (PB6(XTAL1/TOSC1/PCI6)), Q1.2
unnamed: C2.1, IC1.10 (PB7(XTAL2/TOSC2/PCI7)), Q1.1
unnamed: IC1.18 ((PCI4/MISO)PB4), JP1.1
unnamed: IC1.19 ((PCI5/SCK)PB5), JP1.3
PRESSURE_OSZ: IC1.24 ((PCI9/ADC1)PC1), U1.13 (-IN), U1.14 (OUT)
PRESSURE_SIG: IC1.23 ((PCI8/ADC0)PC0), U1.8 (OUT), U1.9 (-IN)
PUMP: IC1.14 ((PCI0/ICP/CLKO)PB0), Q2.1 (G)
RESET: D1.A, IC1.1 (PC6(/RESET/PCI14)), JP1.5, R1.1, SERIAL.1
VALVE1: IC1.15 ((PCI1/OC1A/OC1S)PB1), Q3.1 (G)
VALVE2: IC1.16 ((PCI2/SS/OC1B)PB2), Q4.1 (G)
VDD(OUT): U$1.P$5 (VDD(OUT))

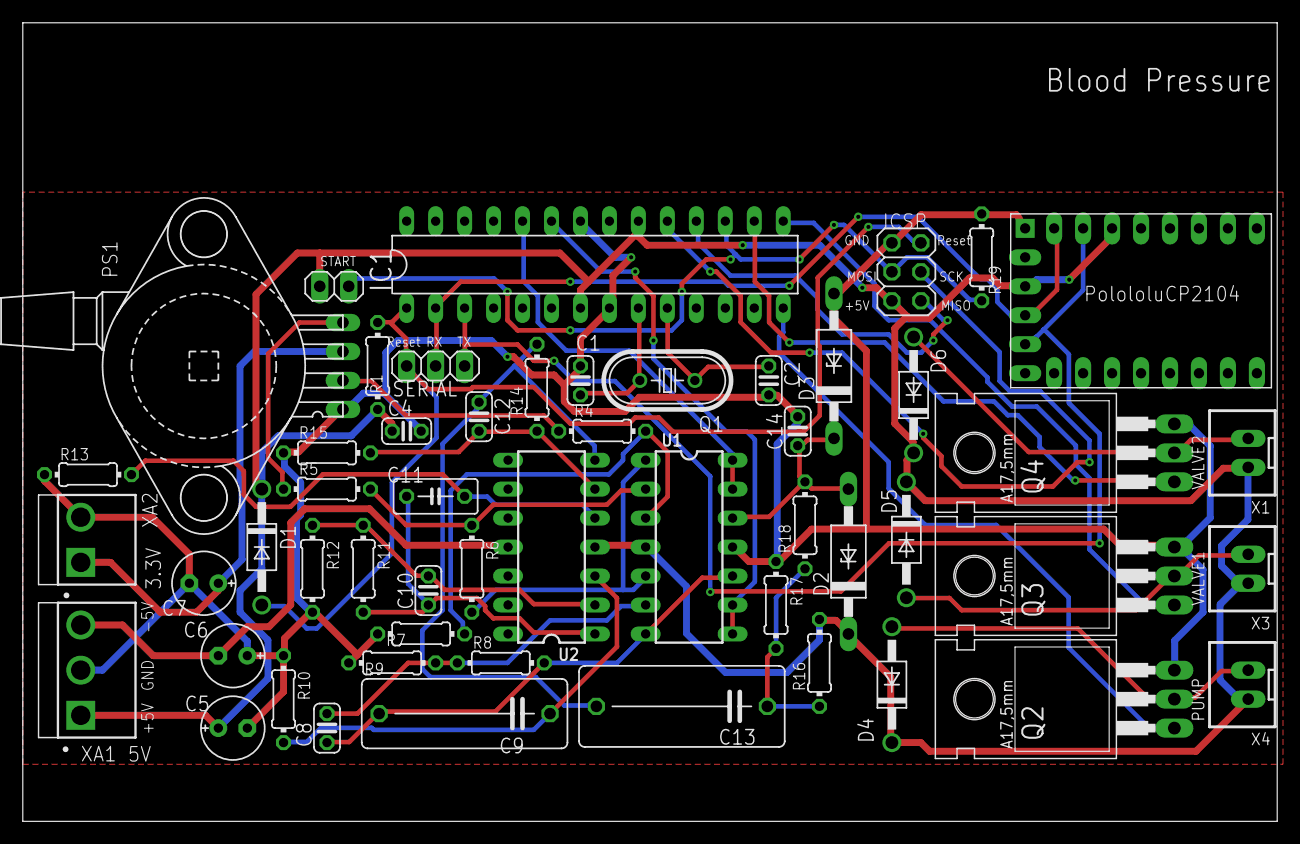
[picture p29: board Blutdruck.brd from above]

Board: 2 copper layers, 110.0 x 70.0 mm, 53 parts (0 on the bottom side), 35 nets.
