cadus/Hardware-Circuit-Boards/Schematics_PCBs_EAGLE/Octopus/PTT/PTT.brd

## EAGLE design Schematics_PCBs_EAGLE/Octopus/PTT/PTT.brd (2019-03-29)

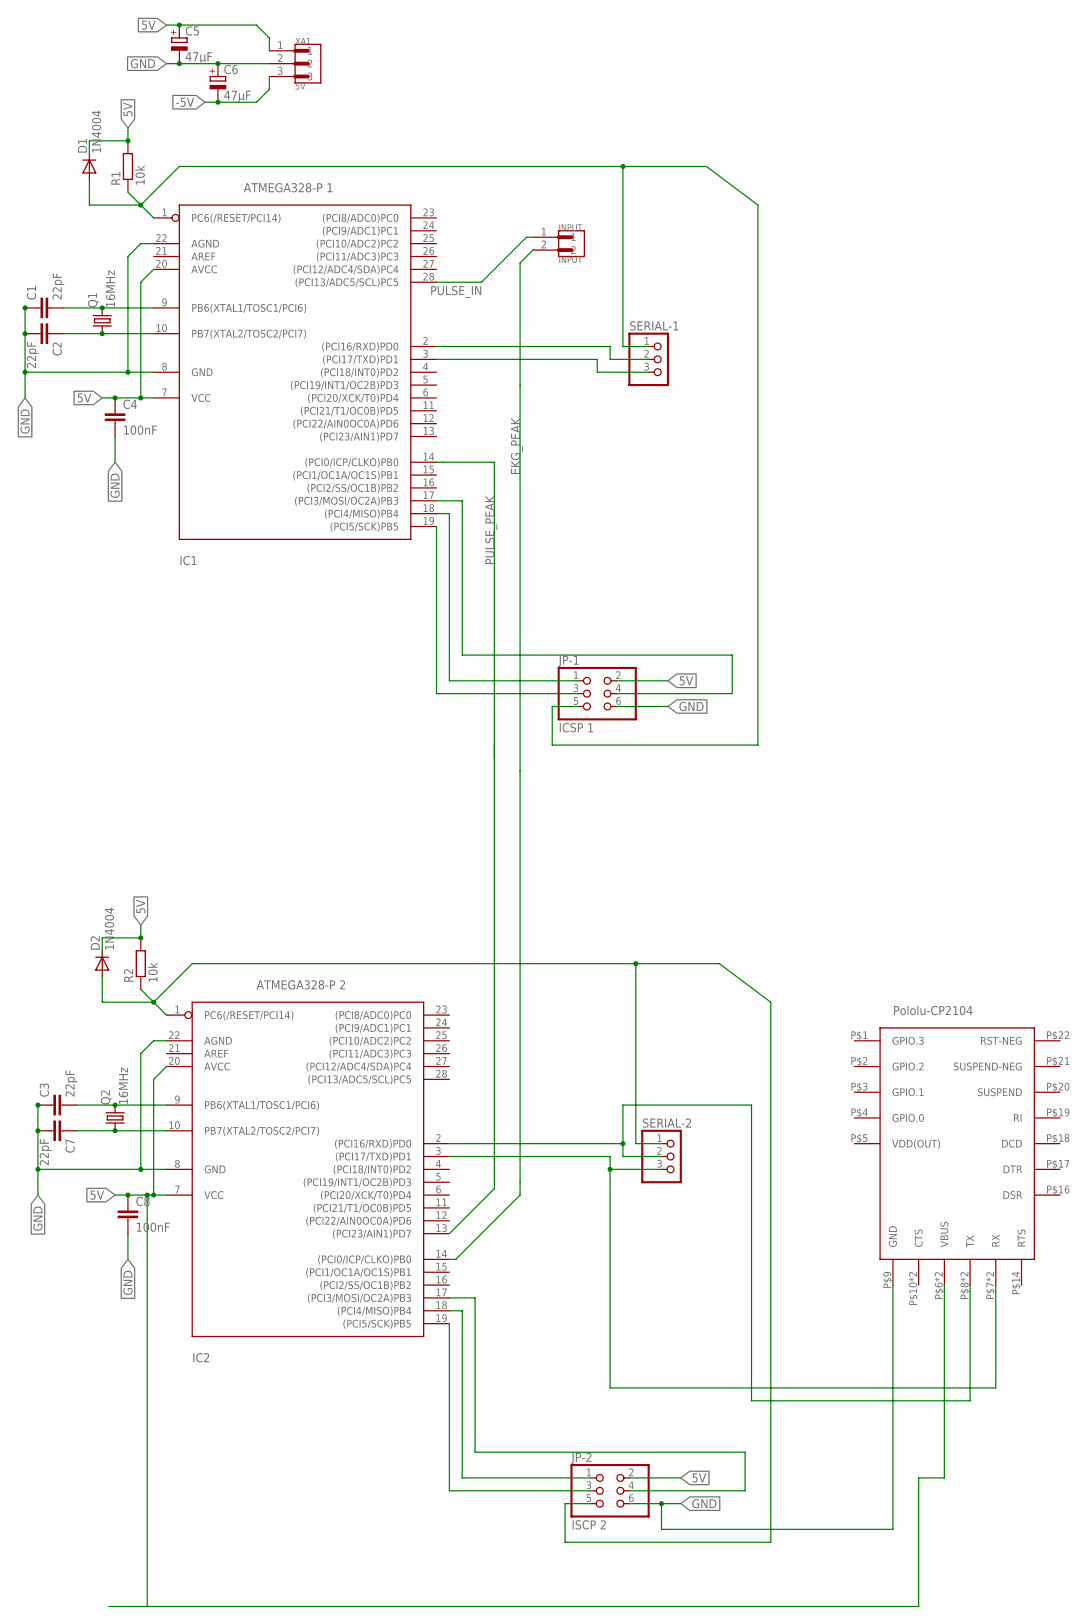
[picture p30: schematic PTT.sch]

Parts:
C1, C2, C3, C7: 22pF; C025-024X044
C4, C8: 100nF; C025-024X044
C5, C6: 47µF; E2,5-6E
D1, D2: 1N4004; DO41-10
IC1: ATMEGA328-P 1; DIL28-3
IC2: ATMEGA328-P 2; DIL28-3
INPUT: INPUT; JST_B2P-VH(LF)(SN)
JP-1: ICSP 1; 2X03
JP-2: ISCP 2; 2X03
Q1, Q2: 16MHz; HC49U70
R1, R2: 10k; 0204/7
SERIAL-1, SERIAL-2: PINHD-1X3; 1X03
U$2: POLOLU_CP2104; POLOLUCP2104
XA1: 5V; JST_B3P-VH(LF)(SN)

Connections:
5V: C4.1, C5.+, C8.1, D1.C, D2.C, IC1.7 (VCC), IC1.20 (AVCC), IC2.7 (VCC), IC2.20 (AVCC), JP-1.2, JP-2.2, R1.2, R2.2, U$2.P$6 (VBUS), U$2.P$11 (VBUS), XA1.1
-5V: C6.-, XA1.3
EKG_PEAK: IC2.14 ((PCI0/ICP/CLKO)PB0), INPUT.2
GND: C1.1, C2.2, C3.1, C4.2, C5.-, C6.+, C7.2, C8.2, IC1.8 (GND), IC1.22 (AGND), IC2.8 (GND), IC2.22 (AGND), JP-1.6, JP-2.6, U$2.P$9 (GND), XA1.2
unnamed: C3.2, IC2.9 (PB6(XTAL1/TOSC1/PCI6)), Q2.2
unnamed: C7.1, IC2.10 (PB7(XTAL2/TOSC2/PCI7)), Q2.1
unnamed: IC2.18 ((PCI4/MISO)PB4), JP-2.1
unnamed: IC2.19 ((PCI5/SCK)PB5), JP-2.3
unnamed: IC2.17 ((PCI3/MOSI/OC2A)PB3), JP-2.4
unnamed: IC2.2 ((PCI16/RXD)PD0), SERIAL-2.2, U$2.P$8 (TX), U$2.P$12 (TX)
unnamed: IC2.3 ((PCI17/TXD)PD1), SERIAL-2.3, U$2.P$7 (RX), U$2.P$13 (RX)
unnamed: IC1.17 ((PCI3/MOSI/OC2A)PB3), JP-1.4
unnamed: IC1.2 ((PCI16/RXD)PD0), SERIAL-1.2
unnamed: IC1.3 ((PCI17/TXD)PD1), SERIAL-1.3
unnamed: C1.2, IC1.9 (PB6(XTAL1/TOSC1/PCI6)), Q1.2
unnamed: C2.1, IC1.10 (PB7(XTAL2/TOSC2/PCI7)), Q1.1
unnamed: IC1.18 ((PCI4/MISO)PB4), JP-1.1
unnamed: IC1.19 ((PCI5/SCK)PB5), JP-1.3
PULSE_IN: IC1.28 ((PCI13/ADC5/SCL)PC5), INPUT.1
PULSE_PEAK: IC1.14 ((PCI0/ICP/CLKO)PB0), IC2.13 ((PCI23/AIN1)PD7)
RESET: D1.A, IC1.1 (PC6(/RESET/PCI14)), JP-1.5, R1.1, SERIAL-1.1
RESET1: D2.A, IC2.1 (PC6(/RESET/PCI14)), JP-2.5, R2.1, SERIAL-2.1
VDD(OUT): U$2.P$5 (VDD(OUT))

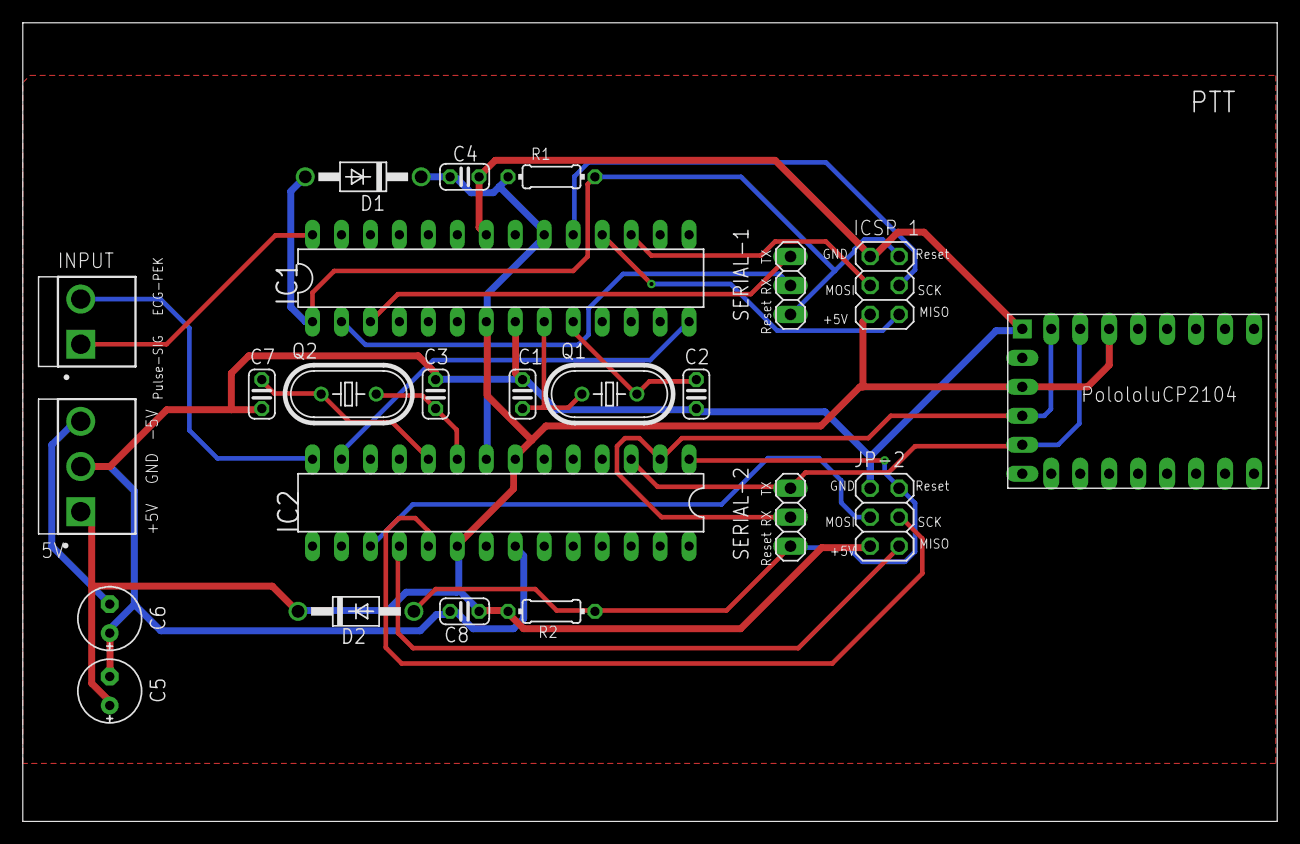
[picture p31: board PTT.brd from above]

Board: 2 copper layers, 110.0 x 70.0 mm, 23 parts (0 on the bottom side), 22 nets.
