cadus/Hardware-Circuit-Boards/Schematics_PCBs_EAGLE/Octopus/ECG/EKG_Pulse_Detection.brd

## EAGLE design Schematics_PCBs_EAGLE/Octopus/ECG/EKG_Pulse_Detection.brd (2019-03-29)

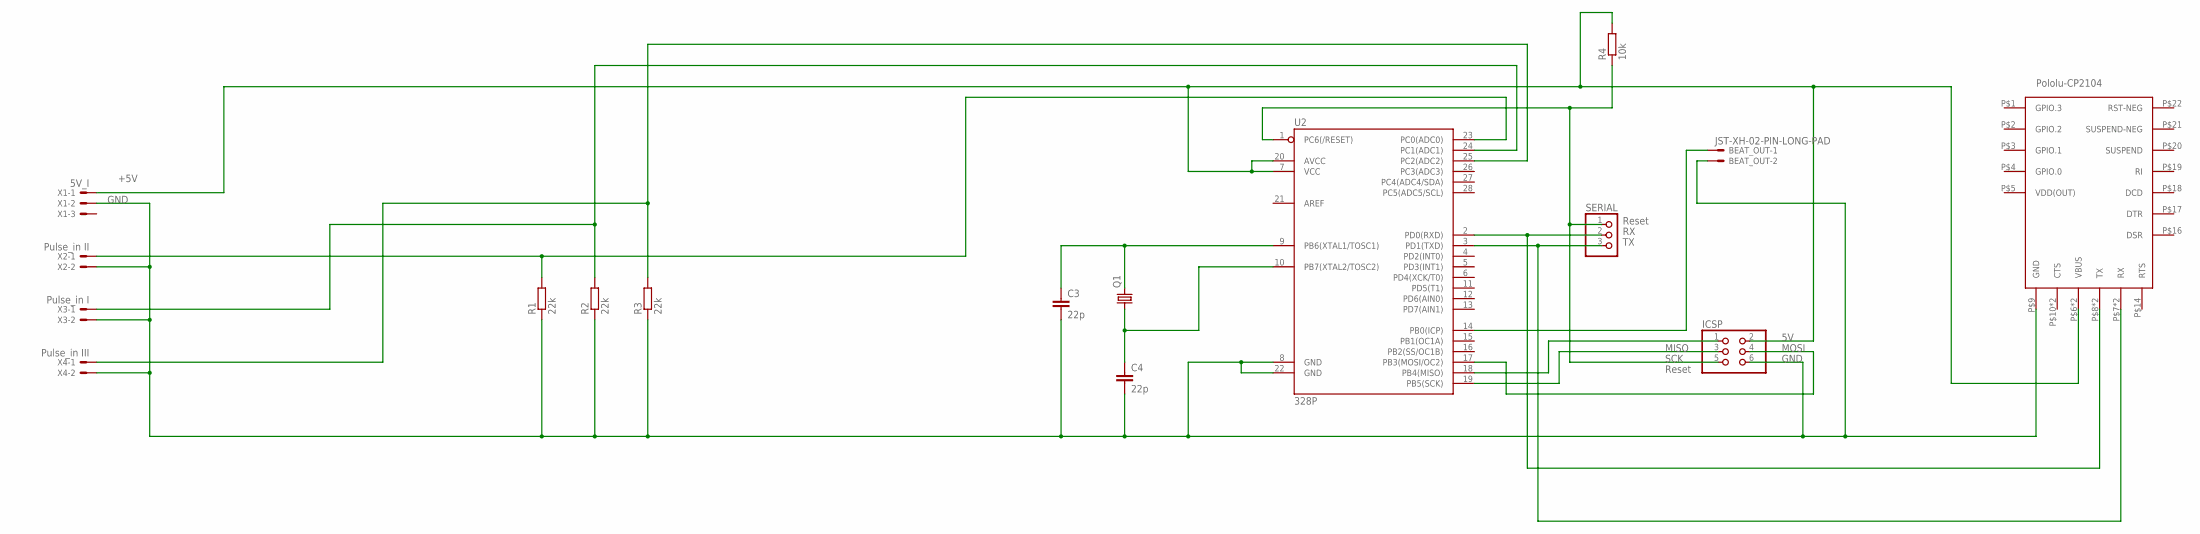
[picture p32: schematic EKG_Pulse_Detection.sch]

Parts:
BEAT_OUT: JST-XH-02-PIN-LONG-PAD; JST-XH-02-PACKAGE-LONG-PAD
C3, C4: 22p; C2.5-3
ICSP: PINHD-2X3; 2X03
Q1: CRYSTALHC49S; HC49/S
R1, R2, R3: 22k; 0207/7
R4: 10k; 0207/7
SERIAL: PINHD-1X3; 1X03
U2: 328P; DIP28
U$1: POLOLU_CP2104; POLOLUCP2104
X1: 5V_I; JST-XH-03-PACKAGE-LONG-PAD
X2: Pulse_in II; JST-XH-02-PACKAGE-LONG-PAD
X3: Pulse_in I; JST-XH-02-PACKAGE-LONG-PAD
X4: Pulse_in III; JST-XH-02-PACKAGE-LONG-PAD

Connections:
+5V: ICSP.2, R4.2, U2.7 (VCC), U2.20 (AVCC), U$1.P$6 (VBUS), U$1.P$11 (VBUS), X1.1
GND: BEAT_OUT.2, C3.2, C4.2, ICSP.6, R1.1, R2.1, R3.1, U2.8 (GND), U2.22 (GND), U$1.P$9 (GND), X1.2, X2.2, X3.2, X4.2
unnamed: R1.2, U2.23 (PC0(ADC0)), X2.1
unnamed: R2.2, U2.24 (PC1(ADC1)), X3.1
unnamed: R3.2, U2.25 (PC2(ADC2)), X4.1
unnamed: C3.1, Q1.2, U2.9 (PB6(XTAL1/TOSC1))
unnamed: C4.1, Q1.1, U2.10 (PB7(XTAL2/TOSC2))
unnamed: ICSP.1, U2.18 (PB4(MISO))
unnamed: ICSP.3, U2.19 (PB5(SCK))
unnamed: ICSP.4, U2.17 (PB3(MOSI/OC2))
unnamed: BEAT_OUT.1, U2.14 (PB0(ICP))
RESET: ICSP.5, R4.1, SERIAL.1, U2.1 (PC6(/RESET))
RX: SERIAL.2, U2.2 (PD0(RXD)), U$1.P$8 (TX), U$1.P$12 (TX)
TX: SERIAL.3, U2.3 (PD1(TXD)), U$1.P$7 (RX), U$1.P$13 (RX)
VDD(OUT): U$1.P$5 (VDD(OUT))

Notes on the sheet:
Reset
SCK
MISO
MOSI
GND

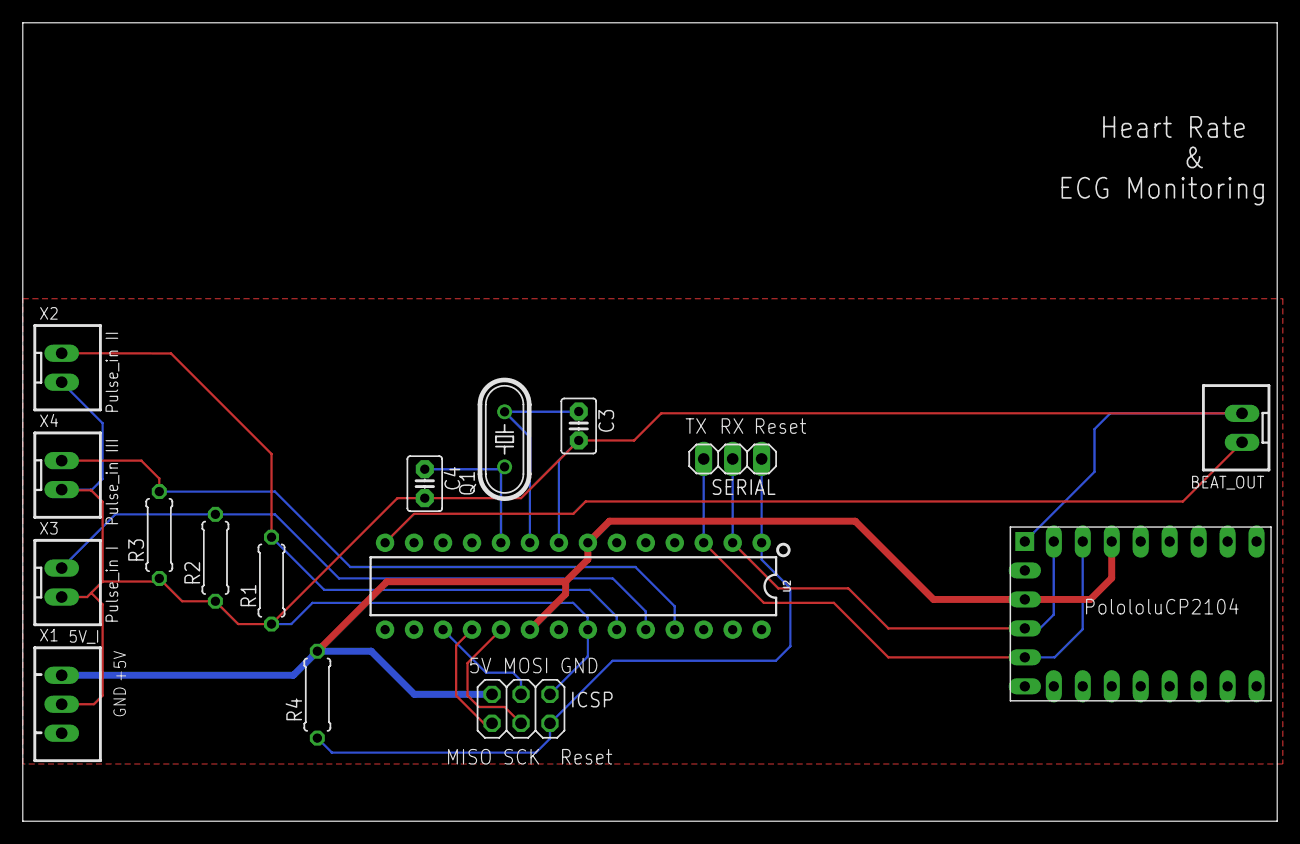
[picture p33: board EKG_Pulse_Detection.brd from above]

Board: 2 copper layers, 110.0 x 70.0 mm, 16 parts (0 on the bottom side), 14 nets.
