cadus/Hardware-Circuit-Boards/Schematics_PCBs_EAGLE/Octopus/ECG/EKG_Modul_I.brd

## EAGLE design Schematics_PCBs_EAGLE/Octopus/ECG/EKG_Modul_I.brd (2019-03-29)

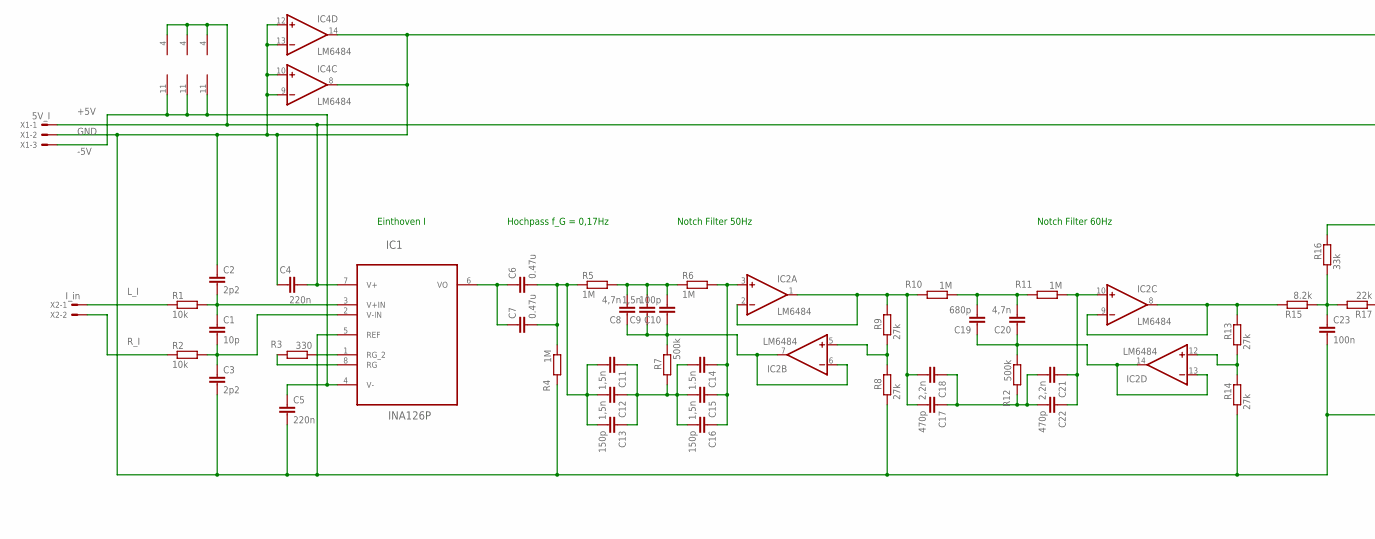
[picture p34: schematic EKG_Modul_I.sch, part in row 1, column 1]

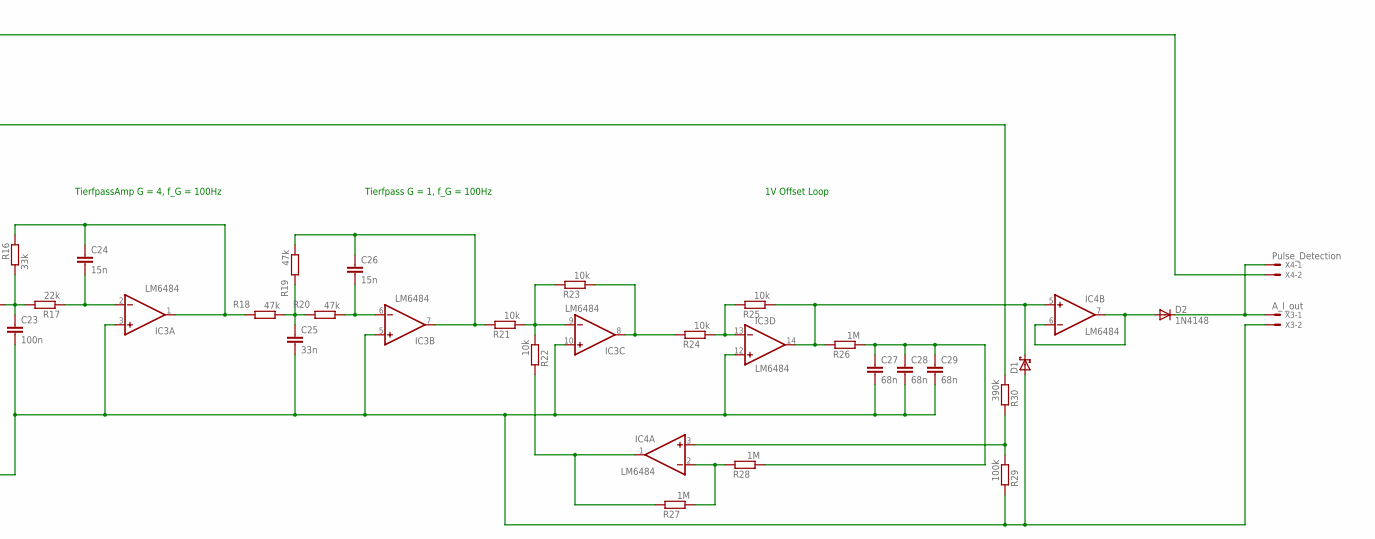
[picture p35: schematic EKG_Modul_I.sch, part in row 1, column 2]

Parts:
C1: 10p; C2.5-2
C2, C3: 2p2; C2.5-2
C4, C5: 220n; C2.5-2
C6, C7: 0.47u; C15B5
C8, C20: 4,7n; C2.5-2
C9, C11, C12, C15: 1,5n; C2.5-2
C10: 100p; C2.5-2
C13, C16: 150p; C2.5-2
C14: 1.5n; C2.5-2
C17, C22: 470p; C2.5-2
C18, C21: 2,2n; C2.5-2
C19: 680p; C2.5-2
C23: 100n; C2.5-2
C24, C26: 15n; C2.5-2
C25: 33n; C2.5-2
C27, C28, C29: 68n; C2.5-2
D1: SCHOTTKY-DIODEDO35-7; DO35-7
D2: 1N4148; DO35-7
IC1: INA126P; DIP254P762X508-8
IC2, IC3, IC4: LM6484; DIL14
R1, R2, R21, R22, R23, R24, R25: 10k; 0207/7
R3: 330; 0207/7
R4, R5, R6, R10, R11, R26, R27, R28: 1M; 0207/7
R7, R12: 500k; 0207/7
R8, R9, R13, R14: 27k; 0207/7
R15: 8.2k; 0207/7
R16: 33k; 0207/7
R17: 22k; 0207/7
R18, R19, R20: 47k; 0207/7
R29: 100k; 0207/7
R30: 390k; 0207/7
X1: 5V_I; JST-XH-03-PACKAGE-LONG-PAD
X2: I_in; JST-XH-02-PACKAGE-LONG-PAD
X3: A_I_out; JST-XH-02-PACKAGE-LONG-PAD
X4: Pulse_Detection; JST-XH-02-PACKAGE-LONG-PAD

Connections:
+5V: C4.2, IC1.7 (V+), IC2.4 (V+), IC3.4 (V+), IC4.4 (V+), R30.1, X1.1
-5V: C5.1, IC1.4 (V-), IC2.11 (V-), IC3.11 (V-), IC4.11 (V-), X1.3
GND: C2.1, C3.2, C4.1, C5.2, C23.2, C25.2, C27.2, C28.2, C29.2, D1.A, IC1.5 (REF), IC3.3 (+IN), IC3.5 (+IN), IC3.10 (+IN), IC3.12 (+IN), IC4.8 (OUT), IC4.9 (-IN), IC4.10 (+IN), IC4.12 (+IN), IC4.13 (-IN), IC4.14 (OUT), R4.2, R8.1, R14.1, R29.2, X1.2, X3.2, X4.2
L_I: R1.1, X2.1
unnamed: D2.A, IC4.6 (-IN), IC4.7 (OUT)
unnamed: D2.C, X3.1, X4.1
unnamed: C1.1, C2.2, IC1.3 (V+IN), R1.2
unnamed: C1.2, C3.1, IC1.2 (V-IN), R2.2
unnamed: IC1.1 (RG_2), R3.1
unnamed: IC1.8 (RG), R3.2
unnamed: C6.1, C7.1, IC1.6 (VO)
unnamed: C6.2, C7.2, C11.2, C12.2, C13.2, R4.1, R5.1
unnamed: C17.2, C18.2, IC2.1 (OUT), IC2.2 (-IN), R9.2, R10.2
unnamed: C8.2, C9.2, C10.2, R5.2, R6.1
unnamed: C11.1, C12.1, C13.1, C14.2, C15.2, C16.2, R7.1
unnamed: C14.1, C15.1, C16.1, IC2.3 (+IN), R6.2
unnamed: IC2.8 (OUT), IC2.9 (-IN), R13.2, R15.2
unnamed: IC2.5 (+IN), R8.2, R9.1
unnamed: C24.1, IC3.1 (OUT), R16.2, R18.2
unnamed: C19.2, C20.2, R10.1, R11.2
unnamed: C23.1, R15.1, R16.1, R17.2
unnamed: C17.1, C18.1, C21.2, C22.2, R12.2
unnamed: C21.1, C22.1, IC2.10 (+IN), R11.1
unnamed: C19.1, C20.1, IC2.13 (-IN), IC2.14 (OUT), R12.1
unnamed: C24.2, IC3.2 (-IN), R17.1
unnamed: IC2.12 (+IN), R13.1, R14.2
unnamed: IC3.13 (-IN), R24.1, R25.2
unnamed: C26.2, IC3.6 (-IN), R20.1
unnamed: C25.1, R18.1, R19.2, R20.2
unnamed: IC3.9 (-IN), R21.1, R22.1, R23.2
unnamed: C26.1, IC3.7 (OUT), R19.1, R21.2
unnamed: IC3.8 (OUT), R23.1, R24.2
unnamed: C8.1, C9.1, C10.1, IC2.6 (-IN), IC2.7 (OUT), R7.2
unnamed: D1.C, IC3.14 (OUT), IC4.5 (+IN), R25.1, R26.2
unnamed: IC4.1 (OUT), R22.2, R27.2
unnamed: IC4.2 (-IN), R27.1, R28.2
unnamed: C27.1, C28.1, C29.1, R26.1, R28.1
unnamed: IC4.3 (+IN), R29.1, R30.2
R_I: R2.1, X2.2

Notes on the sheet:
Einthoven I
Hochpass f_G = 0,17Hz
Notch Filter 50Hz
Notch Filter 60Hz
Tierfpass G = 1, f_G = 100Hz
TierfpassAmp G = 4, f_G = 100Hz
1V Offset Loop

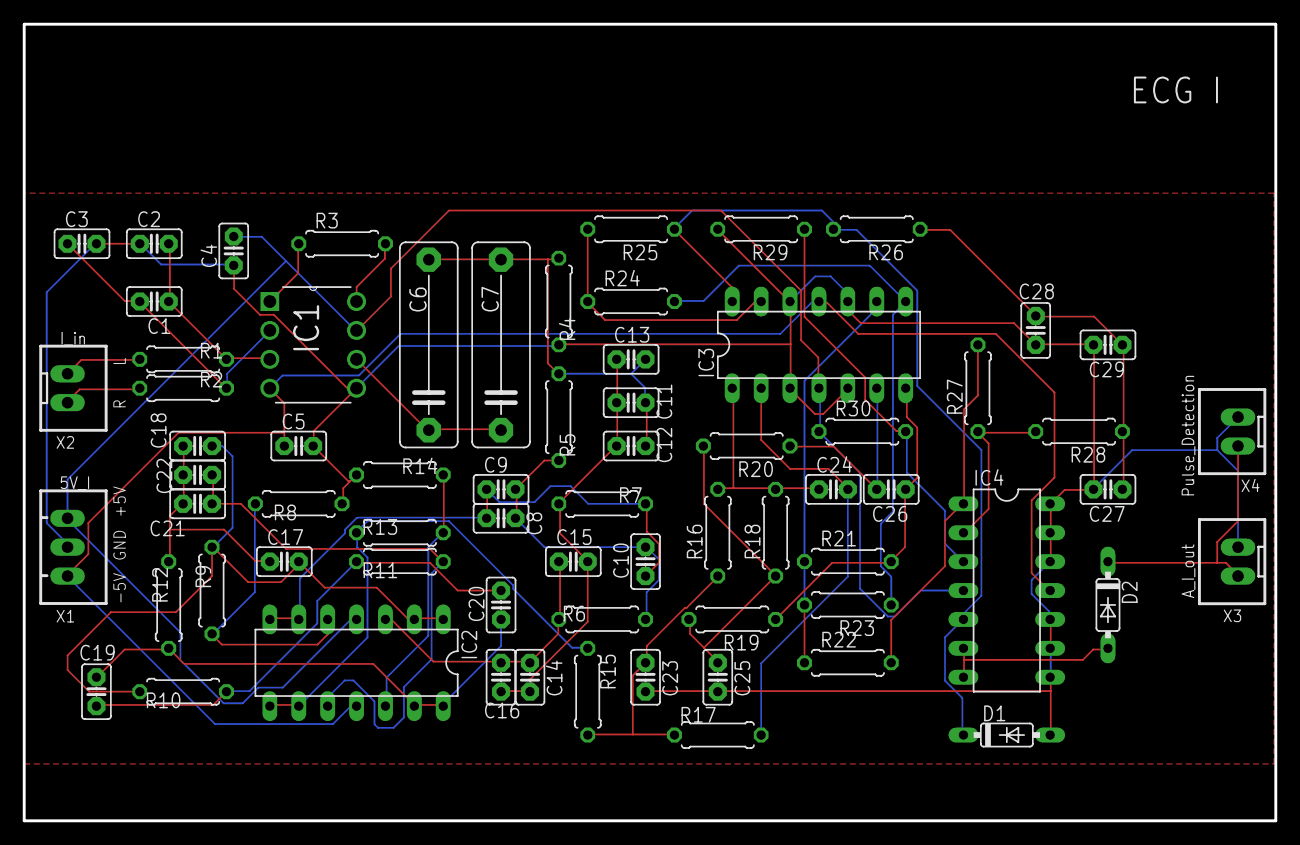
[picture p36: board EKG_Modul_I.brd from above]

Board: 2 copper layers, 110.0 x 70.0 mm, 69 parts (0 on the bottom side), 39 nets.
