cadus/Hardware-Circuit-Boards/Schematics_PCBs_EAGLE/Octopus/Pulsoxy/Pulsoxy.brd

## EAGLE design Schematics_PCBs_EAGLE/Octopus/Pulsoxy/Pulsoxy.brd (2019-03-29)

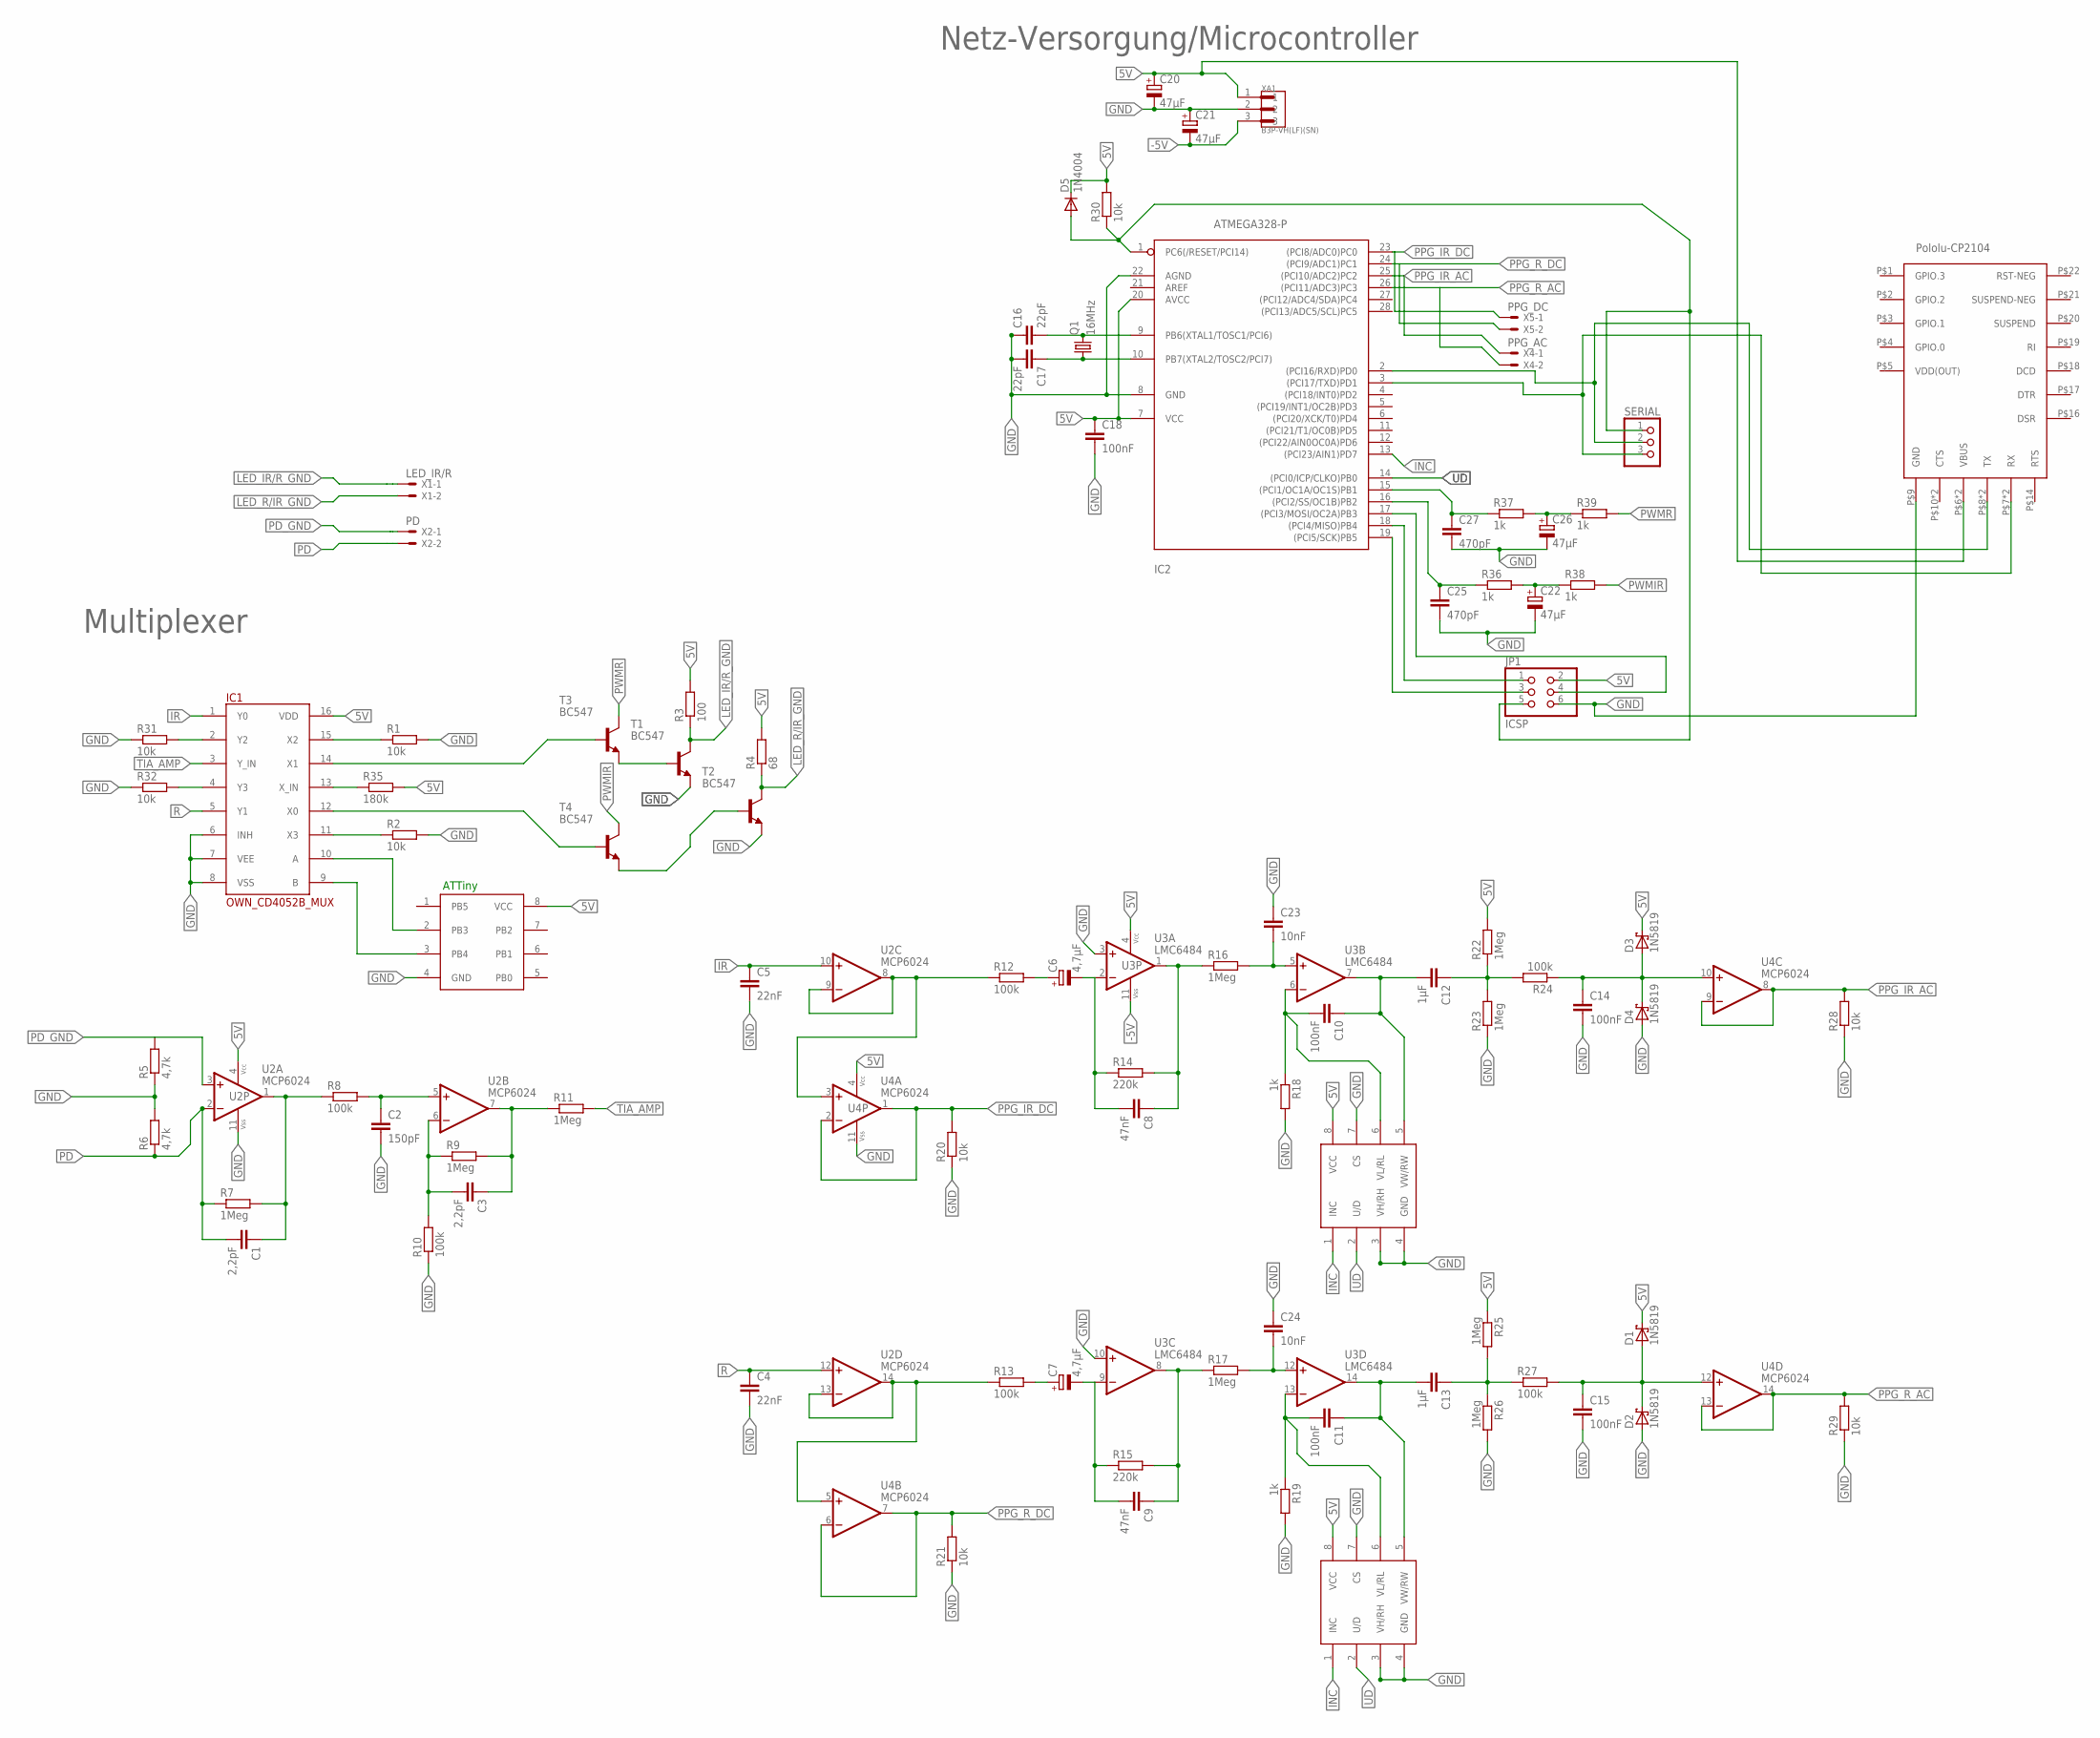
[picture p37: schematic Pulsoxy.sch]

Parts:
ATTINY: ATTINY85; DIL08
C1, C3: 2,2pF; C025-024X044
C2: 150pF; C025-024X044
C4, C5: 22nF; C025-024X044
C6, C7: 4,7µF; E2-5
C8, C9: 47nF; C025-024X044
C10, C11, C14, C15, C18: 100nF; C025-024X044
C12, C13: 1µF; C150-064X183
C16, C17: 22pF; C025-024X044
C20, C21, C22, C26: 47µF; E2,5-6E
C23, C24: 10nF; C025-024X044
C25, C27: 470pF; C025-024X044
D1, D2, D3, D4: 1N5819; F126Z12
D5: 1N4004; DO41-10
IC1: OWN_CD4052B_MUX; DIL16
IC2: ATMEGA328-P; DIL28-3
JP1: ICSP; 2X03
Q1: 16MHz; HC49U70
R1, R2, R20, R21, R28, R29, R30, R31, R32: 10k; 0204/7
R3: 100; 0204/7
R4: 68; 0204/7
R5, R6: 4,7k; 0204/7
R7, R9, R11, R16, R17, R22, R23, R25, R26: 1Meg; 0204/7
R8, R10, R12, R13, R24, R27: 100k; 0204/7
R14, R15: 220k; 0204/7
R18, R19, R36, R37, R38, R39: 1k; 0204/7
R35: 180k; 0204/7
SERIAL: PINHD-1X3; 1X03
T1, T2, T3, T4: BC547; TO92
U2, U4: MCP6024; DIL14
U3: LMC6484; DIL14
U$1, U$2: X9C104P; DIL08
U$3: POLOLU_CP2104; POLOLUCP2104
X1: LED_IR/R; JST-XH-02-PACKAGE-LONG-PAD
X2: PD; JST-XH-02-PACKAGE-LONG-PAD
X4: PPG_AC; JST-XH-02-PACKAGE-LONG-PAD
X5: PPG_DC; JST-XH-02-PACKAGE-LONG-PAD
XA1: B3P-VH(LF)(SN); JST_B3P-VH(LF)(SN)

Connections:
5V: ATTINY.8 (VCC), C18.1, C20.+, D1.C, D3.C, D5.C, IC1.16 (VDD), IC2.7 (VCC), IC2.20 (AVCC), JP1.2, R3.2, R4.2, R22.2, R25.1, R30.2, R35.2, U2.4 (VCC+), U3.4 (VCC+), U4.4 (VCC+), U$1.8 (VCC), U$2.8 (VCC), U$3.P$6 (VBUS), U$3.P$11 (VBUS), XA1.1
-5V: C21.-, U3.11 (VCC-), XA1.3
GND: ATTINY.4 (GND), C2.2, C4.2, C5.2, C14.2, C15.2, C16.1, C17.2, C18.2, C20.-, C21.+, C22.-, C23.1, C24.1, C25.2, C26.-, C27.2, D2.A, D4.A, IC1.6 (INH), IC1.7 (VEE), IC1.8 (VSS), IC2.8 (GND), IC2.22 (AGND), JP1.6, R1.2, R2.2, R5.1, R6.2, R10.1, R18.2, R19.2, R20.1, R21.1, R23.1, R26.2, R28.1, R29.1, R31.1, R32.1, T1.1 (E), T2.1 (E), U2.11 (VCC-), U3.3 (+IN), U3.10 (+IN), U4.11 (VCC-), U$1.3 (VH/RH), U$1.4 (GND), U$1.7 (CS), U$2.3 (VH/RH), U$2.4 (GND), U$2.7 (CS), U$3.P$9 (GND), XA1.2
INC: IC2.13 ((PCI23/AIN1)PD7), U$1.1 (INC), U$2.1 (INC)
IR: C5.1, IC1.1 (Y0), U2.10 (+IN)
LED_IR/R_GND: R3.1, T1.3 (C), X1.1
LED_R/IR_GND: R4.1, T2.3 (C), X1.2
unnamed: IC1.11 (X3), R2.1
unnamed: IC1.15 (X2), R1.1
unnamed: IC1.14 (X1), T3.2 (B)
unnamed: IC1.12 (X0), T4.2 (B)
unnamed: C1.1, R7.2, R8.1, U2.1 (OUT)
unnamed: C2.1, R8.2, U2.5 (+IN)
unnamed: C3.2, R9.1, R10.2, U2.6 (-IN)
unnamed: C3.1, R9.2, R11.1, U2.7 (OUT)
unnamed: R12.1, U2.8 (OUT), U2.9 (-IN), U4.3 (+IN)
unnamed: R13.1, U2.13 (-IN), U2.14 (OUT), U4.5 (+IN)
unnamed: ATTINY.2 (PB3), IC1.10 (A)
unnamed: ATTINY.3 (PB4), IC1.9 (B)
unnamed: C7.-, C9.2, R15.1, U3.9 (-IN)
unnamed: C8.1, R14.2, R16.1, U3.1 (OUT)
unnamed: C6.-, C8.2, R14.1, U3.2 (-IN)
unnamed: C9.1, R15.2, R17.1, U3.8 (OUT)
unnamed: C13.1, R25.2, R26.1, R27.1
unnamed: C14.1, D3.A, D4.C, R24.1, U4.10 (+IN)
unnamed: C10.2, R18.1, U3.6 (-IN), U$1.6 (VL/RL)
unnamed: C15.1, D1.A, D2.C, R27.2, U4.12 (+IN)
unnamed: C11.2, R19.1, U3.13 (-IN), U$2.6 (VL/RL)
unnamed: IC1.4 (Y3), R32.2
unnamed: C10.1, C12.2, U3.7 (OUT), U$1.5 (VW/RW)
unnamed: C12.1, R22.1, R23.2, R24.2
unnamed: C11.1, C13.2, U3.14 (OUT), U$2.5 (VW/RW)
unnamed: C16.2, IC2.9 (PB6(XTAL1/TOSC1/PCI6)), Q1.2
unnamed: C17.1, IC2.10 (PB7(XTAL2/TOSC2/PCI7)), Q1.1
unnamed: IC2.2 ((PCI16/RXD)PD0), SERIAL.2, U$3.P$8 (TX), U$3.P$12 (TX)
unnamed: D5.A, IC2.1 (PC6(/RESET/PCI14)), JP1.5, R30.1, SERIAL.1
unnamed: IC2.18 ((PCI4/MISO)PB4), JP1.1
unnamed: IC2.19 ((PCI5/SCK)PB5), JP1.3
unnamed: IC2.17 ((PCI3/MOSI/OC2A)PB3), JP1.4
unnamed: IC1.2 (Y2), R31.2
unnamed: IC2.3 ((PCI17/TXD)PD1), SERIAL.3, U$3.P$7 (RX), U$3.P$13 (RX)
unnamed: C24.2, R17.2, U3.12 (+IN)
unnamed: IC1.13 (X_IN), R35.1
unnamed: C25.1, IC2.16 ((PCI2/SS/OC1B)PB2), R36.1
unnamed: C23.2, R16.2, U3.5 (+IN)
unnamed: C7.+, R13.2
unnamed: C6.+, R12.2
unnamed: T1.2 (B), T3.1 (E)
unnamed: T2.2 (B), T4.1 (E)
unnamed: C22.+, R36.2, R38.1
unnamed: C27.1, IC2.15 ((PCI1/OC1A/OC1S)PB1), R37.1
unnamed: C26.+, R37.2, R39.1
PD: C1.2, R6.1, R7.1, U2.2 (-IN), X2.2
PD_GND: R5.2, U2.3 (+IN), X2.1
PPG_IR_AC: IC2.25 ((PCI10/ADC2)PC2), R28.2, U4.8 (OUT), U4.9 (-IN), X4.1
PPG_IR_DC: IC2.23 ((PCI8/ADC0)PC0), R20.2, U4.1 (OUT), U4.2 (-IN), X5.1
PPG_R_AC: IC2.26 ((PCI11/ADC3)PC3), R29.2, U4.13 (-IN), U4.14 (OUT), X4.2
PPG_R_DC: IC2.24 ((PCI9/ADC1)PC1), R21.2, U4.6 (-IN), U4.7 (OUT), X5.2
PWMIR: R38.2, T4.3 (C)
PWMR: R39.2, T3.3 (C)
R: C4.1, IC1.5 (Y1), U2.12 (+IN)
TIA_AMP: IC1.3 (Y_IN), R11.2
UD: IC2.14 ((PCI0/ICP/CLKO)PB0), U$1.2 (U/D), U$2.2 (U/D)
VDD(OUT): U$3.P$5 (VDD(OUT))

Notes on the sheet:
ATTiny
Netz-Versorgung/Microcontroller
Multiplexer

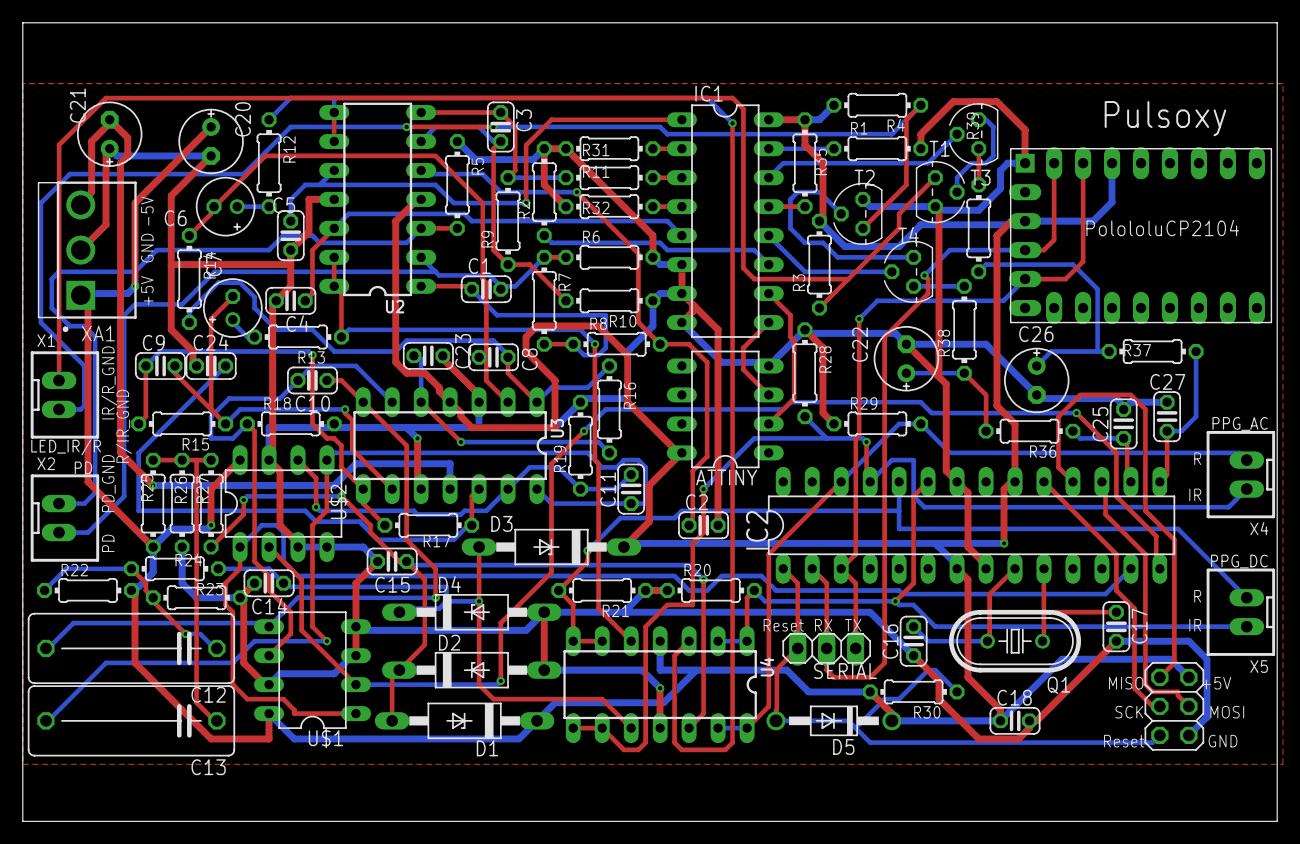
[picture p38: board Pulsoxy.brd from above]

Board: 2 copper layers, 110.0 x 70.0 mm, 89 parts (0 on the bottom side), 63 nets.
