cadus/Hardware-Circuit-Boards/Schematics_PCBs_EAGLE/Octopus/Power_Supply/Spannungsversorgung.brd

## EAGLE design Schematics_PCBs_EAGLE/Octopus/Power_Supply/Spannungsversorgung.brd (2019-03-29)

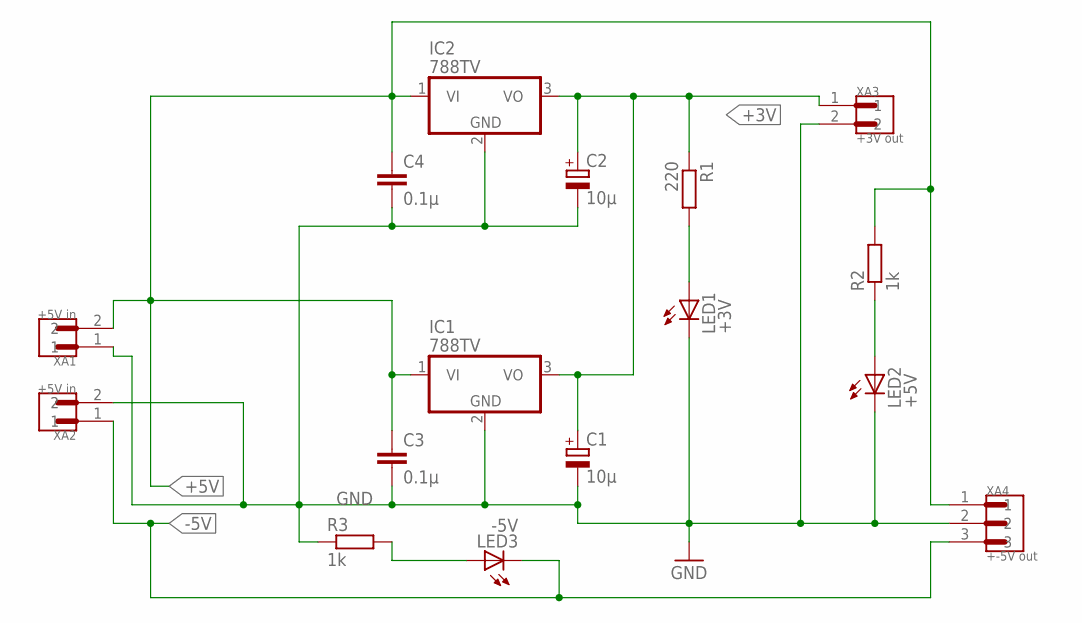
[picture p39: schematic Spannungsversorgung.sch]

Parts:
C1, C2: 10µ; E2,5-6
C3, C4: 0.1µ; C2.5-3
IC1, IC2: 788TV; TO220V
LED1: +3V; LED3MM
LED2: +5V; LED3MM
LED3: -5V; LED3MM
R1: 220; 0207/7
R2, R3: 1k; 0207/7
XA1, XA2: +5V in; JST_B2P-VH(LF)(SN)
XA3: +3V out; JST_B2P-VH(LF)(SN)
XA4: +-5V out; JST_B3P-VH(LF)(SN)

Connections:
+3V: C1.+, C2.+, IC1.3 (VO), IC2.3 (VO), R1.1, XA3.1
+5V: C3.1, C4.1, IC1.1 (VI), IC2.1 (VI), R2.2, XA1.2, XA4.1
-5V: LED3.K (C), XA2.1, XA4.3
GND: C1.-, C2.-, C3.2, C4.2, IC1.2 (GND), IC2.2 (GND), LED1.K (C), LED2.K (C), R3.1, XA1.1, XA2.2, XA3.2, XA4.2
unnamed: LED3.A, R3.2
unnamed: LED1.A, R1.2
unnamed: LED2.A, R2.1

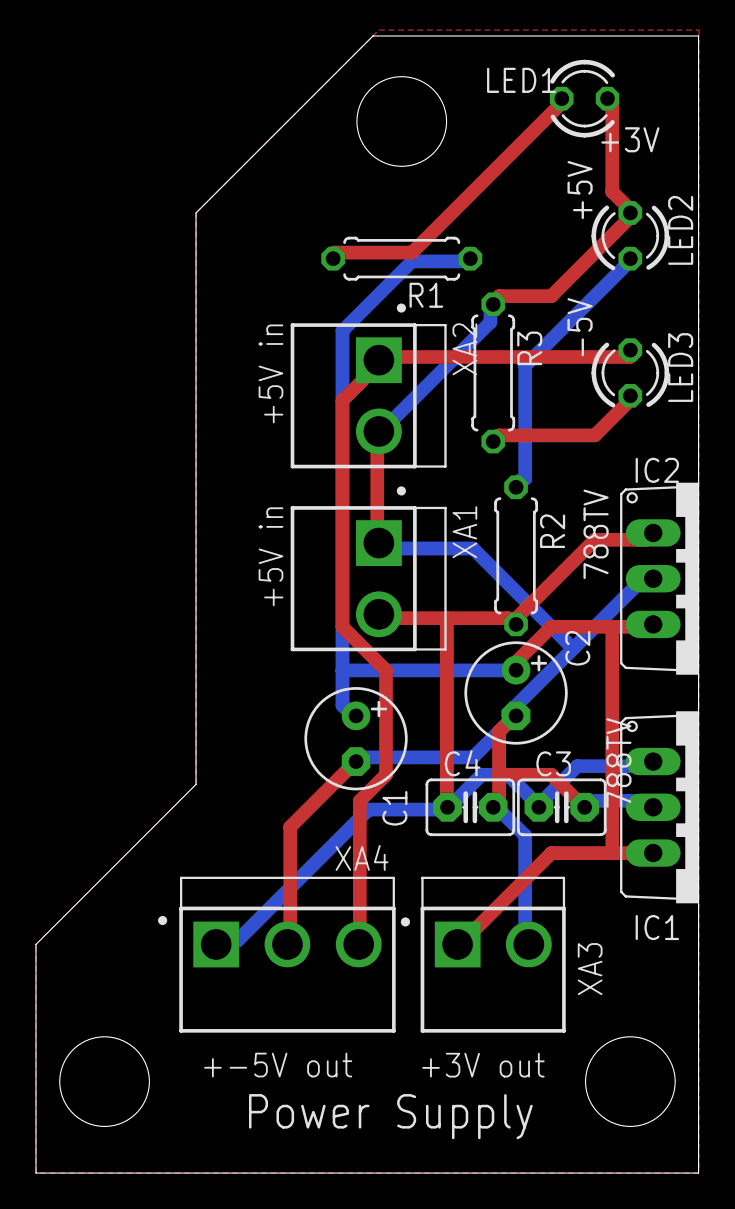
[picture p40: board Spannungsversorgung.brd from above]

Board: 2 copper layers, 36.8 x 63.2 mm, 16 parts (0 on the bottom side), 7 nets.
