cadus/Hardware-Circuit-Boards/Schematics_PCBs_EAGLE/Octopus/ECG/EKG_Modul_Versorgung.brd

## EAGLE design Schematics_PCBs_EAGLE/Octopus/ECG/EKG_Modul_Versorgung.brd (2019-03-29)

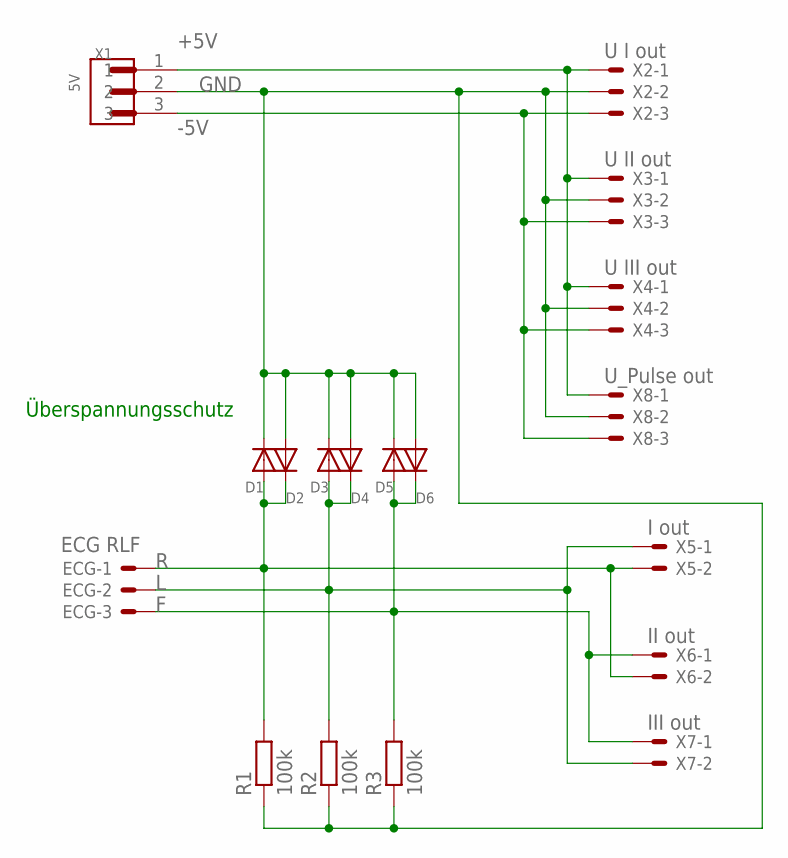
[picture p41: schematic EKG_Modul_Versorgung.sch]

Parts:
D1, D2, D3, D4, D5, D6: DIODEDO-1N4148; DO-1N4148
ECG: ECG RLF; JST-XH-03-PACKAGE-LONG-PAD
R1, R2, R3: 100k; 0207/7
X1: 5V; JST_B3P-VH(LF)(SN)
X2: U I out; JST-XH-03-PACKAGE-LONG-PAD
X3: U II out; JST-XH-03-PACKAGE-LONG-PAD
X4: U III out; JST-XH-03-PACKAGE-LONG-PAD
X5: I out; JST-XH-02-PACKAGE-LONG-PAD
X6: II out; JST-XH-02-PACKAGE-LONG-PAD
X7: III out; JST-XH-02-PACKAGE-LONG-PAD
X8: U_Pulse out; JST-XH-03-PACKAGE-LONG-PAD

Connections:
+5V: X1.1, X2.1, X3.1, X4.1, X8.1
-5V: X1.3, X2.3, X3.3, X4.3, X8.3
F: D5.A, D6.C, ECG.3, R3.2, X6.1, X7.1
GND: D1.C, D2.A, D3.C, D4.A, D5.C, D6.A, R1.1, R2.1, R3.1, X1.2, X2.2, X3.2, X4.2, X8.2
L: D3.A, D4.C, ECG.2, R2.2, X5.1, X7.2
R: D1.A, D2.C, ECG.1, R1.2, X5.2, X6.2

Notes on the sheet:
Überspannungsschutz

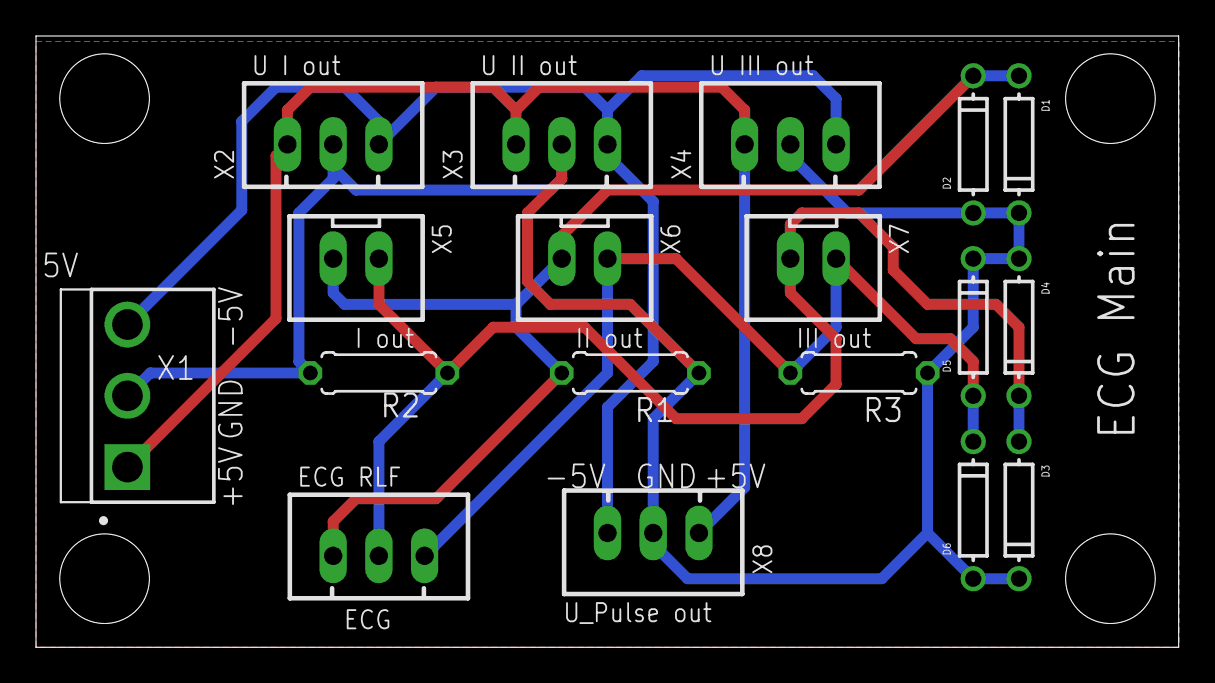
[picture p42: board EKG_Modul_Versorgung.brd from above]

Board: 2 copper layers, 63.5 x 34.0 mm, 18 parts (0 on the bottom side), 6 nets.
