cadus/Hardware-Circuit-Boards/Schematics_PCBs_EAGLE/Octopus/Brain/Brain.brd

## EAGLE design Schematics_PCBs_EAGLE/Octopus/Brain/Brain.brd (2019-03-29)

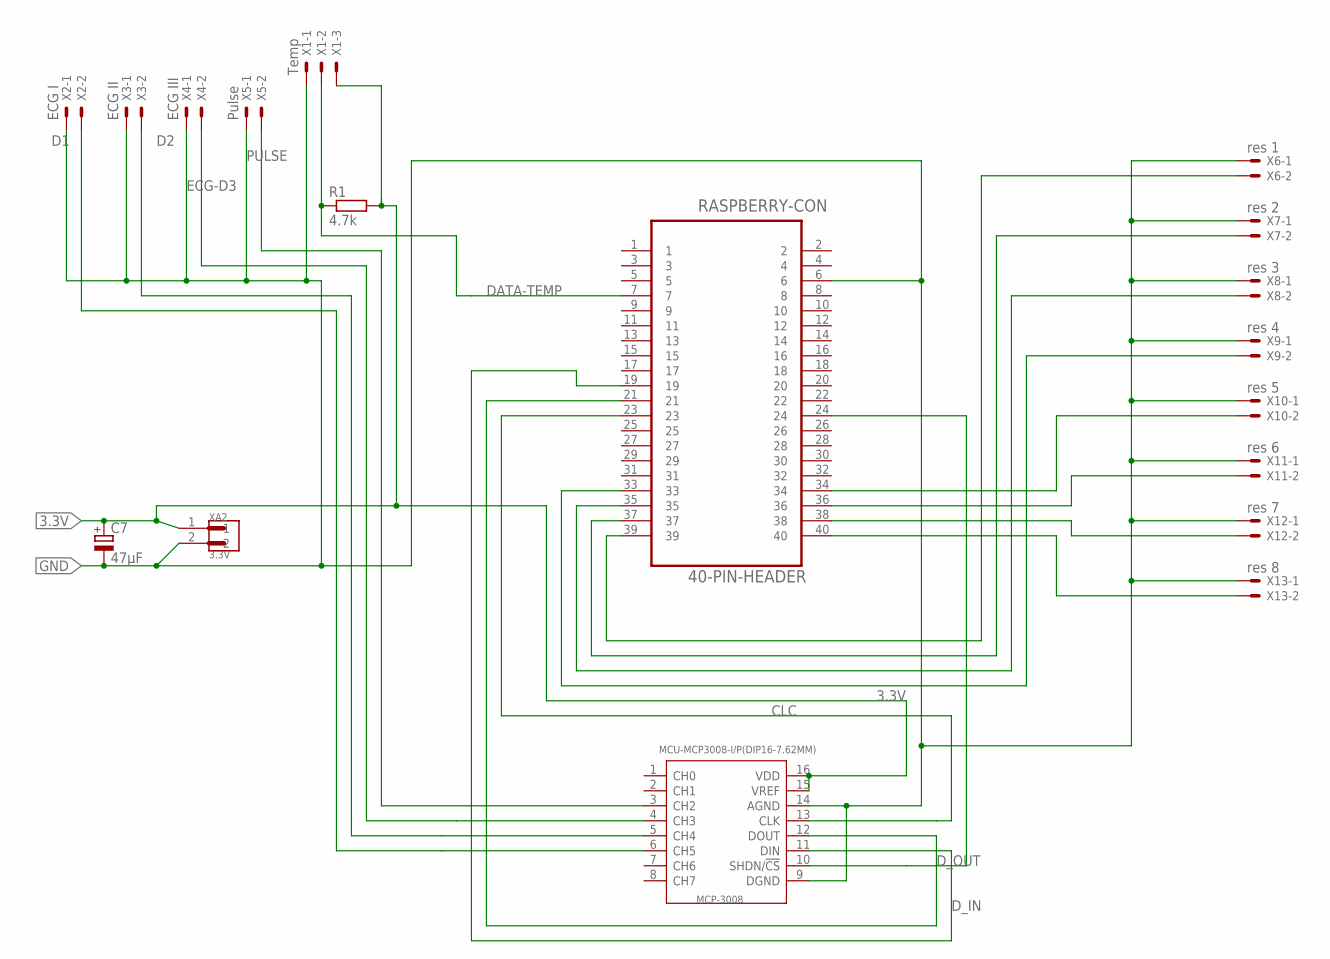
[picture p43: schematic Brain.sch]

Parts:
C7: 47µF; E2,5-6E
MCP-3008: MCU-MCP3008-I/P(DIP16-7.62MM); DIP16-2.54-19.2X7.62MM
R1: 4.7k; 0207/7
RASPBERRY-CON: 40-PIN-HEADER; SAMTEC_TSW-120-09-F-Q
X1: Temp; JST-XH-03-PACKAGE-LONG-PAD
X2: ECG I; JST-XH-02-PACKAGE-LONG-PAD
X3: ECG II; JST-XH-02-PACKAGE-LONG-PAD
X4: ECG III; JST-XH-02-PACKAGE-LONG-PAD
X5: Pulse; JST-XH-02-PACKAGE-LONG-PAD
X6: res 1; JST-XH-02-PACKAGE-LONG-PAD
X7: res 2; JST-XH-02-PACKAGE-LONG-PAD
X8: res 3; JST-XH-02-PACKAGE-LONG-PAD
X9: res 4; JST-XH-02-PACKAGE-LONG-PAD
X10: res 5; JST-XH-02-PACKAGE-LONG-PAD
X11: res 6; JST-XH-02-PACKAGE-LONG-PAD
X12: res 7; JST-XH-02-PACKAGE-LONG-PAD
X13: res 8; JST-XH-02-PACKAGE-LONG-PAD
XA2: 3.3V; JST_B2P-VH(LF)(SN)

Connections:
3.3V: C7.+, MCP-3008.15 (VREF), MCP-3008.16 (VDD), R1.2, X1.3, XA2.1
CLC: MCP-3008.13 (CLK), RASPBERRY-CON.23
D1: MCP-3008.6 (CH5), X2.2
D2: MCP-3008.5 (CH4), X3.2
DATA-TEMP: R1.1, RASPBERRY-CON.7, X1.2
D_IN: MCP-3008.11 (DIN), RASPBERRY-CON.19
D_OUT: MCP-3008.12 (DOUT), RASPBERRY-CON.21
ECG-D3: MCP-3008.4 (CH3), X4.2
GND: C7.-, MCP-3008.9 (DGND), MCP-3008.14 (AGND), RASPBERRY-CON.6, X1.1, X2.1, X3.1, X4.1, X5.1, X6.1, X7.1, X8.1, X9.1, X10.1, X11.1, X12.1, X13.1, XA2.2
unnamed: RASPBERRY-CON.40, X13.2
unnamed: RASPBERRY-CON.38, X12.2
unnamed: MCP-3008.10 (SHDN/!CS), RASPBERRY-CON.24
unnamed: RASPBERRY-CON.36, X11.2
unnamed: RASPBERRY-CON.34, X10.2
unnamed: RASPBERRY-CON.39, X6.2
unnamed: RASPBERRY-CON.37, X7.2
unnamed: RASPBERRY-CON.35, X8.2
unnamed: RASPBERRY-CON.33, X9.2
PULSE: MCP-3008.3 (CH2), X5.2

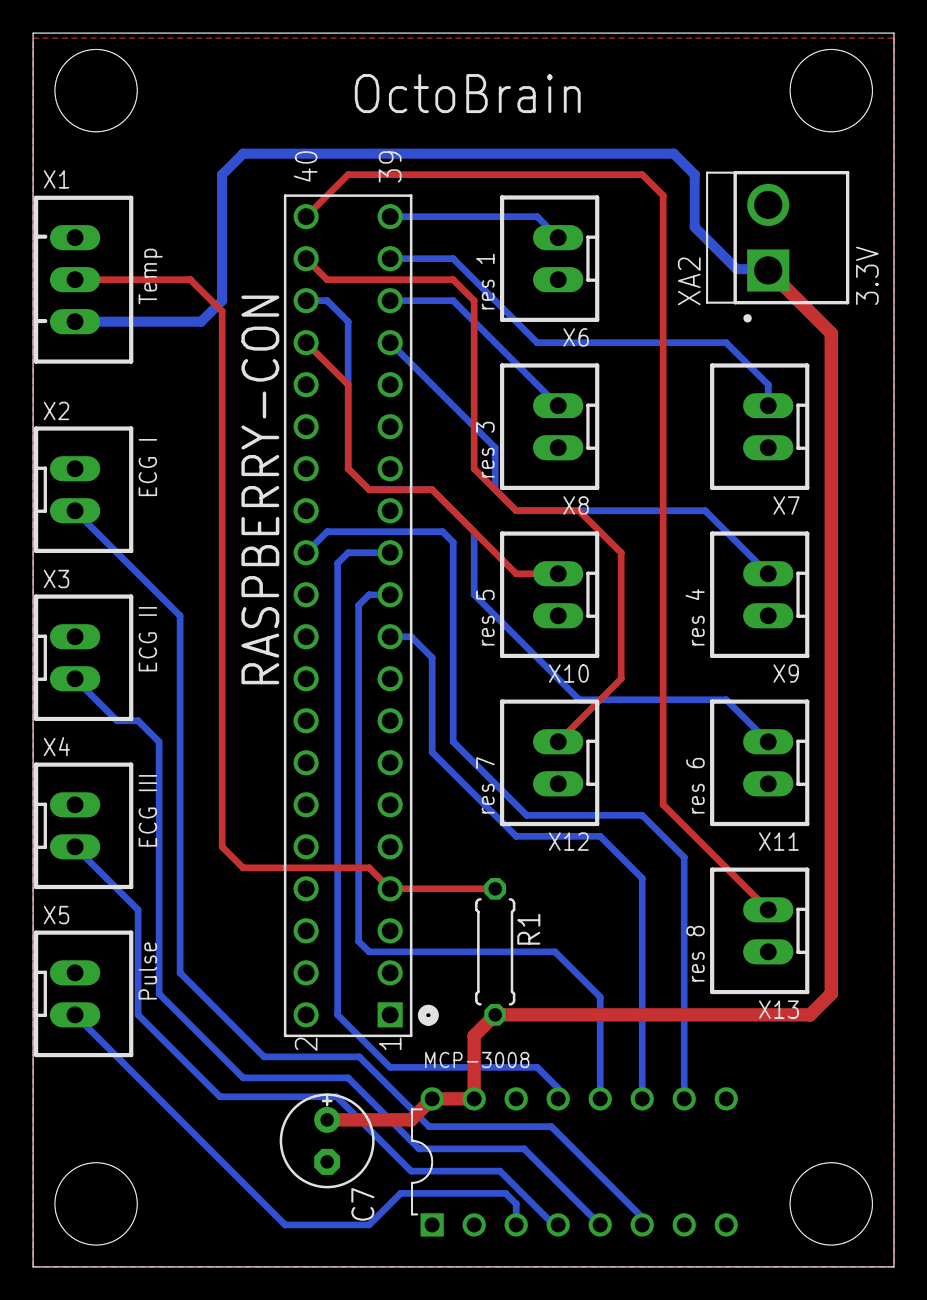
[picture p44: board Brain.brd from above]

Board: 2 copper layers, 52.0 x 74.6 mm, 18 parts (0 on the bottom side), 19 nets.
