cadus/Hardware-Circuit-Boards/(commit log)

2019-03-29 Electronic schematics and PCB Layouts
    [Blutdruck.brd, Blutdruck.sch, Brain.brd, Brain.sch, EKG_Modul_I.brd, EKG_Modul_I.sch, EKG_Modul_II.brd, EKG_Modul_II.sch]
2019-03-29 Device files not included in standard EAGLE
2019-03-29 PCB gerber files
2019-03-29 Part lists for each PCB
2019-06-25 Wiring schematics for PCB modules
2019-07-31 Wiring schematics for all PCB boards and power supply
2019-07-31 Add files via upload
    Description of electronic components and assembly instructions
2019-07-31 Create folder
    Schematics for circuit boards and PCB layouts as PNG and PDF files
2019-07-31 PCB layout of OctoBrain board
