cadus/Hardware-Circuit-Boards/(notices)

Notices in the files:
parts and their libraries:
op-amp: Copyright (C) 2006 by Bob Starr
SparkFun-IC-Microcontroller: Licensing: Creative Commons ShareAlike 4.0 International - https://creativecommons.org/licenses/by-sa/4.0
